harrypatrick442/hvps/Structure/Assembly/PCBImages/LM2596.png

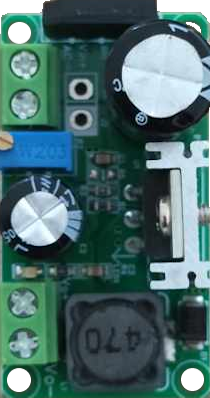
Structure/Assembly/PCBImages/LM2596.png
