harrypatrick442/hvps/Code/C++/VoltageFeedbackModuleBase/FiberOpticLayout.txt

 Voltage feedback module
 +  -   blank
TR2 RC  TR1
 ^^ ^^ ^^
