harrypatrick442/hvps/DataSheets/terminals/PCB-3 M4.png

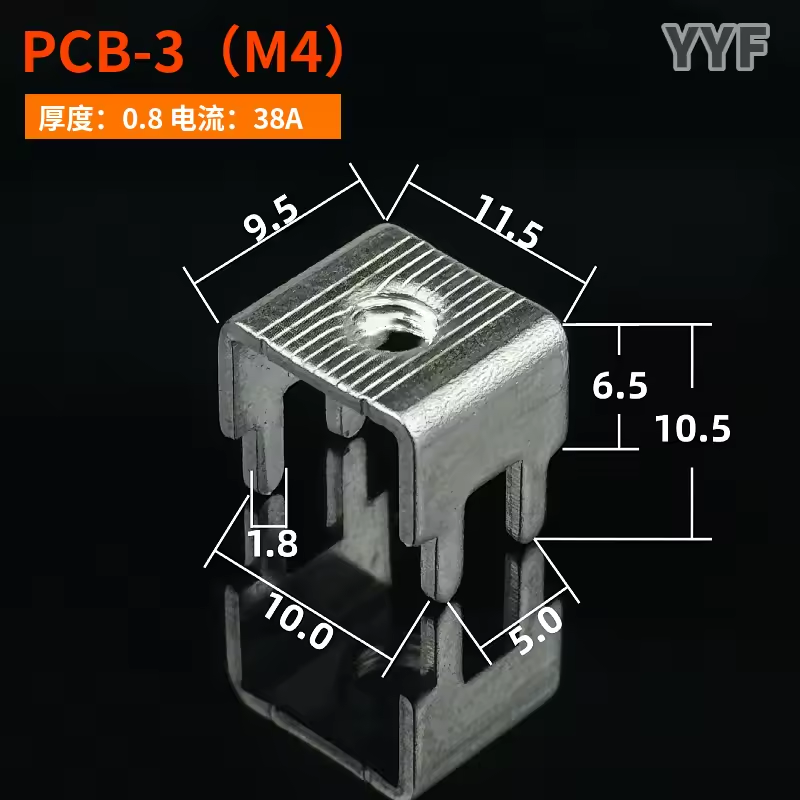
DataSheets/terminals/PCB-3 M4.png
