harrypatrick442/hvps/Documents/ESP-FPGA Interface/Block Logic Diagram.png

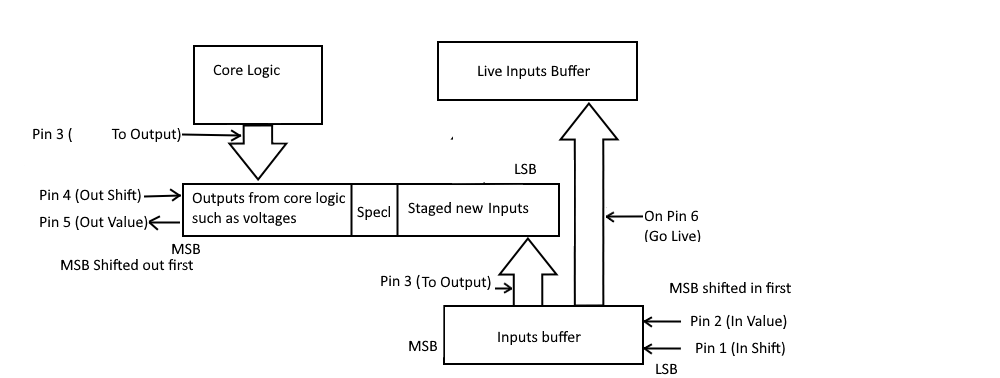
Documents/ESP-FPGA Interface/Block Logic Diagram.png
