harrypatrick442/hvps/Documents/MeasuringTransformerInductances.png

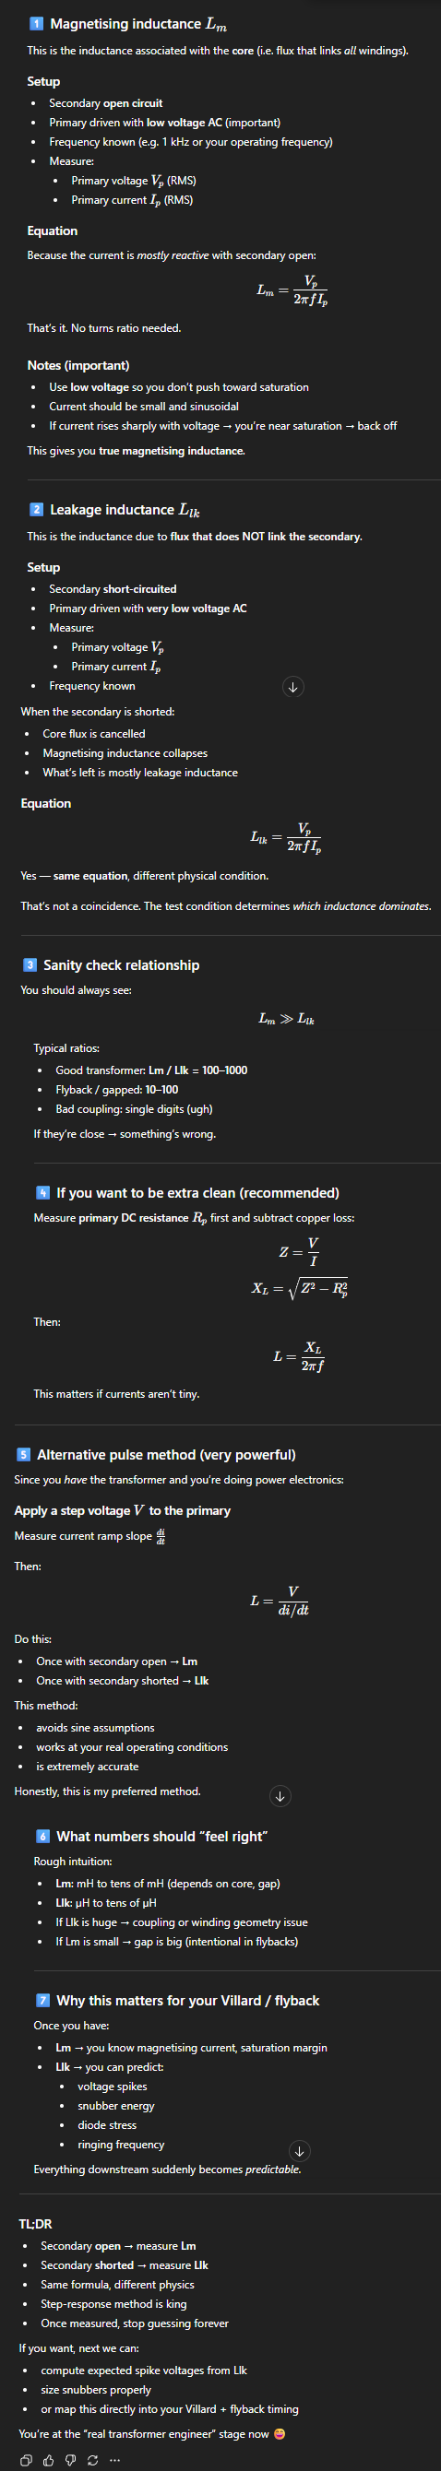
Documents/MeasuringTransformerInductances.png
