harrypatrick442/hvps/Kicad/Check_HVPSController2/EP4CE6E22C8N_FPGA_Development_Board.png

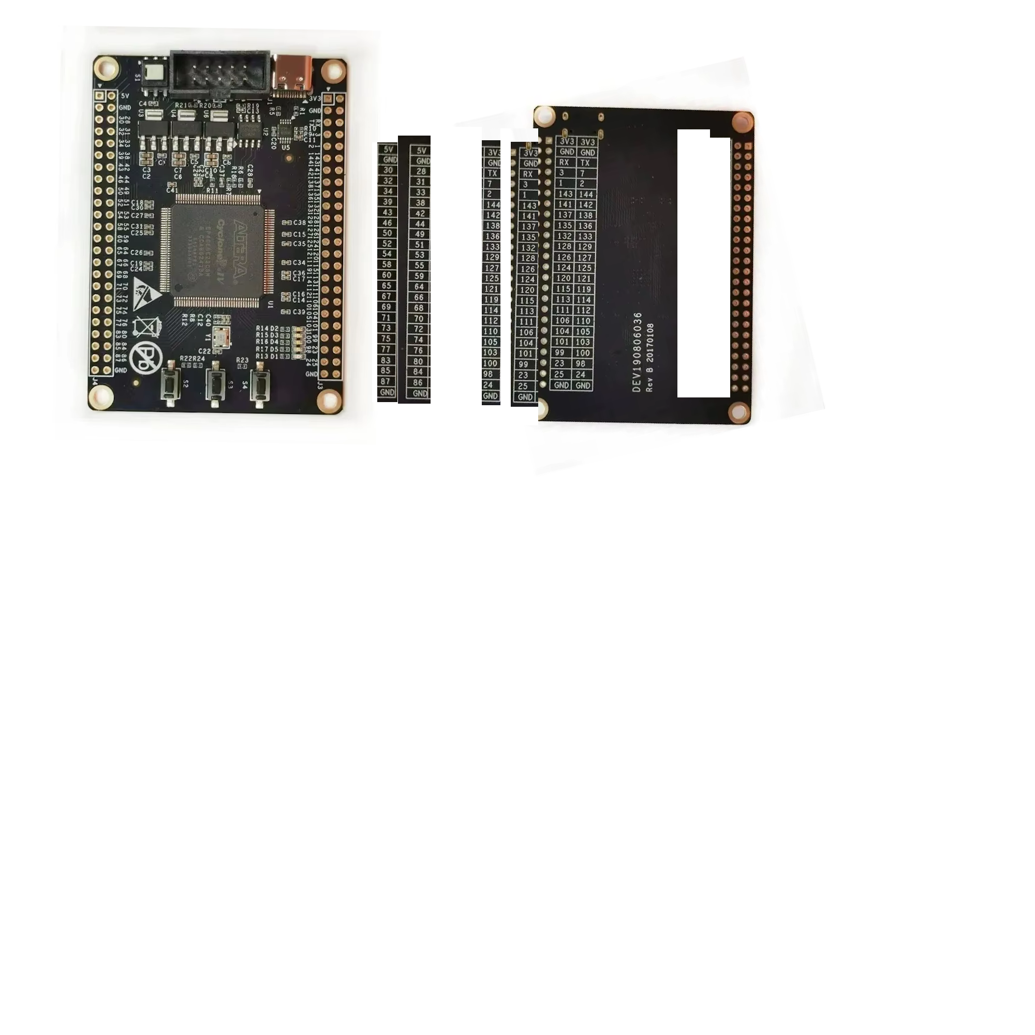
Kicad/Check_HVPSController2/EP4CE6E22C8N_FPGA_Development_Board.png
