harrypatrick442/hvps/Structure/Base/Bolts_Top.png

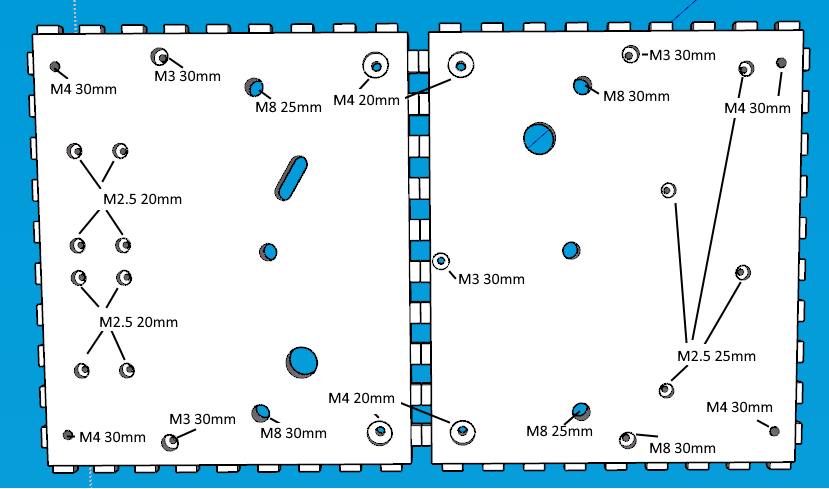
Structure/Base/Bolts_Top.png
