harrypatrick442/hvps/Validation/CheckingControllerSchematic.png

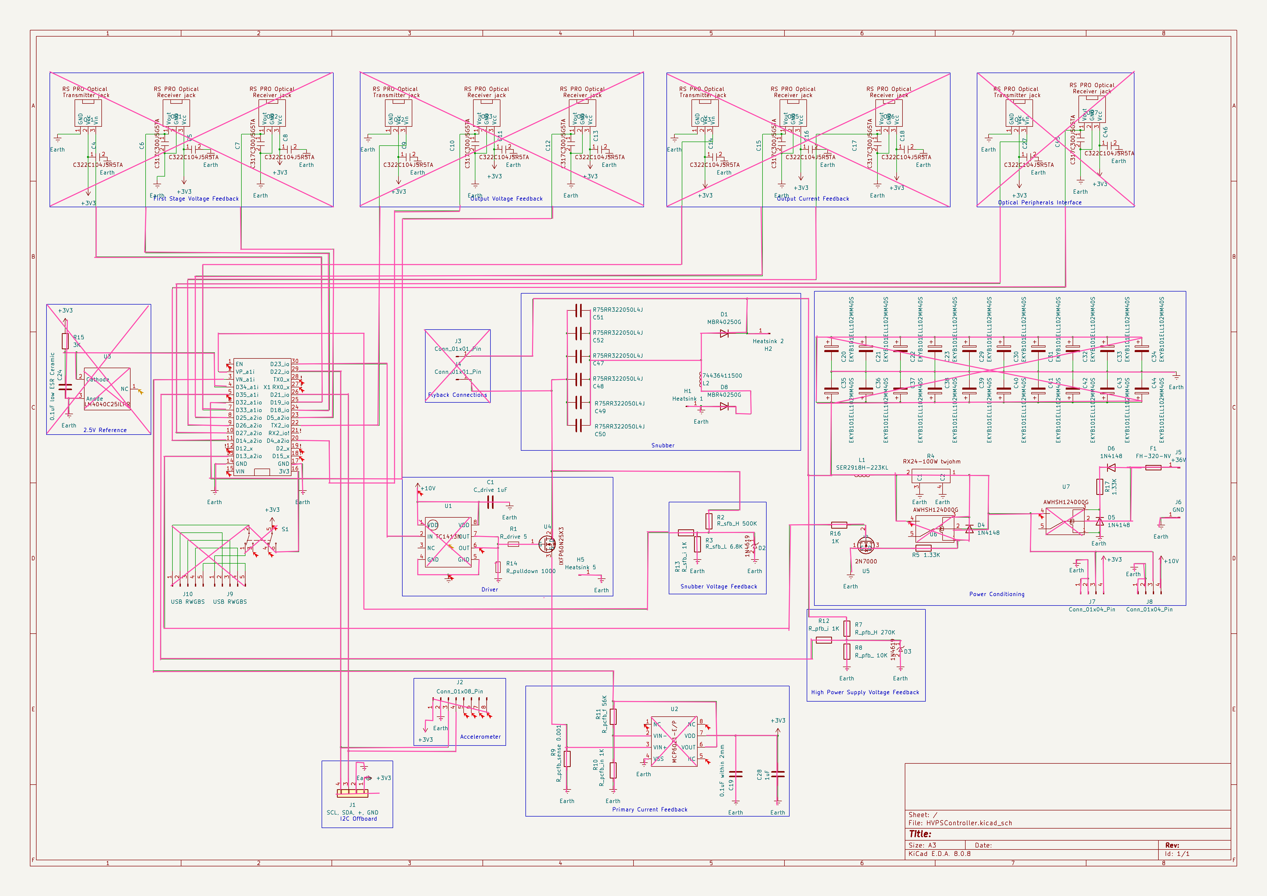
Validation/CheckingControllerSchematic.png
