harrypatrick442/hvps/Spreadsheets/Parts_HVPSController.xlsx

Sheet: Sheet1
Subsystem |  | Item # | Url | Include (green) | Part Name | Part Number | Category | Quantity Needed | Quantity in Stock | Description | Value/Rating | Tolerance | Voltage Rating | Power Rating | Package/Size | Supplier | Supplier Part Number | Unit Price | Total Cost | Lead Time | Notes
 |  | Unique identifier or reference number for each part (useful for cross-referencing in schematics). | Link(s) to related pages | ‎ | Name of the component (e.g., Resistor, Capacitor, MOSFET). | Manufacturer’s part number or internal part number. | ‎ | Number of each component required for the project. | Number of components you currently have. | Brief description of the part, including key specs (e.g., 10kΩ, 1/4W for a resistor). | Specific value, rating, or specification (e.g., 10µF, 16V for a capacitor). | Tolerance for components like resistors and capacitors (e.g., ±5%). | Voltage rating (especially important for capacitors, diodes, etc.). | Power rating for resistors, MOSFETs, etc. | Package type (e.g., SMD-0805, TO-220) or physical size. | Supplier name (e.g., Digi-Key, Mouser, LCSC). | Supplier-specific part number, if different from manufacturer part number. | Price per unit of the part. | Total cost calculated as Quantity Needed × Unit Price. | Expected time for delivery from supplier. | Any additional notes, like alternatives or special instructions.
Flyback Core |  |  |  | ‎
 |  |  |  | ‎
 |  |  | https://www.aliexpress.com/item/1005006725342220.html?scm_id=1007.13339.291025.0&scm-url=1007.13339.291025.0 | ‎ | UY42 UY120/89/42 | ‎
 |  |  | https://www.aliexpress.com/item/1005005826311044.html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 | ‎ | 1pair/lot UY42 Ultra Large Power Transformer Core Al 8448nH/N2 UY120/89/42 UU Isolator Ferrite Core Ferrite Chokes MnZn PC40 | ‎
 |  |  | https://www.aliexpress.com/item/33011851355.html?scm_id=1007.40050.354490.0&scm-url=1007.40050.354490.0 | ‎ | uy30
 |  |  | https://www.aliexpress.com/item/1005002286755922.html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 | ‎
 |  |  | https://www.aliexpress.com/item/1005002286755922.html | ‎ | 1pair UY 30 MnZn PC40 U Shape Ferrite Filter 130x95mm For Transformer Core | ‎ |  | 1 | 0 | 1pair UY 30 MnZn PC40 U Shape Ferrite Filter 130x95mm For Transformer Core | ‎ |  |  | PC40 |  | Aliexpress, New Accessory Store, Store no 912028214 | ‎ | £33.79 | £33.79
 |  |  |  | ‎ |  |  |  |  |  |  |  |  |  |  |  |  |  |  | £0.00
Capacitor Distcharge Resistor |  |  | https://www.mouser.co.uk/ProductDetail/Vishay-BC-Components/VR68000002496FAC00?qs=wEmTtUuRSe6YkQzEm4CWKw%3D%3D | ‎ |  | VR68000002496FAC00 |  |  |  |  |  |  |  |  |  |  |  |  | £0.00
 |  |  | ‎ | ‎ |  |  |  |  |  |  |  |  |  |  |  |  |  |  | £0.00
 |  |  | ‎ | ‎ |  |  |  |  |  |  |  |  |  |  |  |  |  |  | £0.00
 |  |  | ‎ | ‎ |  |  |  |  |  |  |  |  |  |  |  |  |  |  | £0.00
 |  |  | ‎ | ‎ |  |  |  |  |  |  |  |  |  |  |  |  |  |  | £0.00
 |  |  | ‎ | ‎ |  |  |  |  |  |  |  |  |  |  |  |  |  |  | £0.00
Gate Driver |  |  | ‎ | ‎ | n channel gate driver | TC1413N |  | 1 | 0 | single n channel non inverting gate driver able to drive up to 1800pf gate. | ‎ |  |  |  |  |  |  |  | £0.00
 |  |  | ‎ | ‎ | CSD19534KCS 100V N-Channel NexFET | CSD19534KCS |  | 1 | 0 | 100V N-Channel NexFET | ‎ |  |  |  |  |  |  |  | £0.00
 |  |  | ‎ | ‎ | 1uf X7R capacitor | C320C104K5R5TA (https://www.mouser.co.uk/ProductDetail/KEMET/C320C104K5R5TA) |  | 1 | 0 | Capacitor that goes across Vdd and Gnd for TC1413N | 1uf | 10% |  |  |  |  |  |  | £0.00
 |  |  | ‎ | ‎ |  |  |  |  |  |  |  |  |  |  |  |  |  |  | £0.00
 |  |  | ‎ | ‎ |  |  |  |  |  |  |  |  |  |  |  |  |  |  | £0.00
 |  |  | ‎ | ‎ |  |  |  |  |  |  |  |  |  |  |  |  |  |  | £0.00
Voltage Feedback |  |  | ‎ | ‎ | 1N4619 BK PBFREE | 1N4619 BK PBFREE |  |  |  | zener diode protection, 3v 0.8uA leakage | ‎ | 5% | 3 | 0.25w | DO-35-2 |  |  |  | £0.00
 |  |  | ‎ | ‎ |  | SM108033006FE (https://www.mouser.co.uk/ProductDetail/Ohmite/SM108033006FE) |  |  |  | Thick Film Resistors - Through Hole 300M ohms 1% | 300M | 1% | 20kv | 2.5w |  |  |  |  | £0.00
 |  |  | ‎ | ‎ |  | MFR-25FBF52-30K1 (https://www.mouser.co.uk/ProductDetail/YAGEO/MFR-25FBF52-45K3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) |  |  |  | Metal Film Resistors - Through Hole 30.1K OHM 1/4W 1% | 30.1k | s | 250v | 0.25w |  |  |  |  | £0.00
 |  |  | ‎ | ‎ |  | C322C102F5G5TA |  |  |  | Multilayer Ceramic Capacitors MLCC - Leaded 50V 1000pF C0G 1% LS=5.08mm | 1000pf | 1% | 50v |  |  |  |  |  | £0.00
 |  |  | ‎ | ‎ |  | RS Stock No.:270-7764 |  |  |  | RS PRO 16Mbps Fibre Optic Transmitter 640 → 670nm, Square Fiber Optic Connector, 13.6 x 11.5 x 9.5mm SUPPORTS toslink | ‎ |  |  |  |  |  |  |  | £0.00
 |  |  | ‎ | ‎ |  | RS Stock No.:270-7763 |  |  |  | RS PRO 16Mbps 650nm Fibre Optic Receiver, Square, Fiber Optic Connector SUPPORTS toslink | ‎ |  |  |  |  |  |  |  | £0.00
 |  |  | ‎ | ‎ |  | C317C300J5G5TA (https://www.mouser.co.uk/ProductDetail/KEMET/C317C300J5G5TA?qs=b8KOIaRqXtdsFXPxXiN2GA%3D%3D) |  |  |  | Multilayer Ceramic Capacitors MLCC - Leaded 50V 30pF C0G 5% LS=5.08mm | 30pf | 5% | 50v |  |  |  |  |  | £0.00
 |  |  | ‎ | ‎ |  | C322C104J5R5TA |  |  |  | Multilayer Ceramic Capacitors MLCC - Leaded 50V 0.1uF X7R 5% LS=5.08mm | 0.1uf | 5% | 50v |  |  |  |  |  | £0.00
 |  |  | ‎ | ‎ |  | WP154A4SEJ3VBDZGW/CA | ‎ |  |  | Common anode RGB led WP154A4SEJ3VBDZGW/CA | ‎ |  |  |  |  |  |  |  | £0.00
Villard Capacitor |  |  | https://www.alibaba.com/product-detail/CT81-20KV-1000PF-N4700-D19-5xT8_60495534513.html | ‎ | Villard Capacitors | AXCT81D20KV102K |  | 190 | 0 | CT81 20KV 1000PF N4700 D19.5xT8.5xF13.0mm, d0.8 | 1uF | 10% | 20000 | N4700 |  | AnXon |  | $0.68 | £180.00 | 7-8 weeks | $48 Fedex postage from china
 |  |  | ‎ | ‎ |  |  |  |  |  |  |  |  |  |  |  |  |  |  | £0.00
 |  |  | ‎ | ‎ |  |  |  |  |  |  |  |  |  |  |  |  |  |  | £0.00
 |  |  | ‎ | ‎ |  |  |  |  |  |  | ‎ |  |  |  |  |  |  |  | £0.00
 |  |  | ‎ | ‎ |  | HVC-20KV-DL21-F12.5-102K | ‎ |  |  | https://www.hv-caps.com/HV-Ceramic-Disc-Capacitor/hv-ceramic-disc-capacitor163.html | ‎ |  |  |  |  |  |  |  | £0.00
 |  |  | ‎ | ‎ |  | HVC-20KV -DL28- F16 -202K | ‎ |  |  |  |  |  |  |  |  |  |  |  | £0.00
 |  |  | https://www.mouser.co.uk/ProductDetail/Vishay-Roederstein/HVCC203Y6P102MEAX | ‎ |  | HVCC203Y6P102MEAX (https://www.mouser.co.uk/ProductDetail/Vishay-Roederstein/HVCC203Y6P102MEAX) |  |  |  |  |  |  |  |  |  |  |  |  | £0.00
 |  |  |  | ‎ |  |  |  |  |  |  |  |  |  |  |  |  |  |  | £0.00
villard Diode |  |  | https://www.aliexpress.com/item/1005008408941647.html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 | ‎ |  | 35kv 0.1 amp diodes |  |  |  |  |  |  |  |  |  |  |  |  | £0.00
 |  |  | https://www.aliexpress.com/item/32991104517.html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 | ‎ | high voltage capacitor | 2CL2FR (https://www.alldatasheet.com/datasheet-pdf/pdf/876496/GETEDZ/2CL2FP_16.html) |  |  |  | 35kv 0.1 amp diodes | 35kv 100ma |  |  |  |  |  |  |  | £0.00
 |  |  | https://www.aliexpress.com/item/1005007066972173.html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 | ‎ |  | 2CL2FP |  |  |  | 35kv 0.1 amp diodes | ‎ |  |  |  |  |  |  |  | £0.00
 |  |  | https://www.aliexpress.com/item/1005007066972173.html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 | ‎ |  | 2CL2FR (https://www.alldatasheet.com/datasheet-pdf/pdf/876496/GETEDZ/2CL2FP_16.html) |  |  |  | 35kv 0.1 amp diodes | ‎ |  |  |  |  |  |  |  | £0.00
 |  |  |  | ‎ |  | CL08-35 |  |  |  | 35kv 200ma high voltage diodes for main villard cascading | ‎ |  |  |  |  |  |  |  | £0.00
 |  |  | https://www.alibaba.com/product-detail/hot-sell-MT100F35-100mA-35KV-100ns_1601105852602.html | ‎ |  | MT100F35 |  |  |  | hot sell MT100F35 100mA 35KV 100ns Fast Recovery High Voltage Diode replace 2CL2FR for wholesales |  |  |  |  |  |  |  |  | £0.00
 |  |  | https://www.aliexpress.com/item/1005006421523336.html |  |  | JB289 |  | 12 | 0 | JB289 HIGH high voltage diodes | 35kv 100mA |  | 35kv |  |  |  |  | 2.1 | £25.20
 |  |  |  | ‎ |  |  |  |  |  |  |  |  |  |  |  |  |  |  | £0.00
Villard Distcharge Resistor |  |  | https://www.mouser.co.uk/ProductDetail/Vishay-BC-Components/VR68000002496FAC00?qs=wEmTtUuRSe6YkQzEm4CWKw%3D%3D | ‎ |  | VR68000002496FAC00 |  |  |  |  |  |  |  |  |  |  |  |  | £0.00
 |  |  | https://www.mouser.co.uk/ProductDetail/Murata-Power-Solutions/MHR0422SA108F70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 | ‎ |  | MHR0422SA_1G |  |  |  |  |  |  |  |  |  |  |  |  | £0.00
 |  |  | https://www.aliexpress.com/item/1005005496744751.html | ‎ |  | 2G HVR82ML2204J * 2 in series | ‎ |  |  | 30kv |  |  |  |  |  |  |  |  | £0.00
 |  |  | https://www.aliexpress.com/item/1005005756305538.html | ‎ |  | 2G HVR82MY2505 * 2 in series | ‎ |  |  |  |  |  |  |  |  |  |  |  | £0.00
 |  |  | https://www.aliexpress.com/item/1005007223750578.html | ‎ |  | multiple HVR82MZ1005. cheap high values low power small | ‎ |  |  |  |  |  |  |  |  |  |  |  | £0.00
 |  |  | https://www.aliexpress.com/item/1005003588041883.html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 | ‎ |  | multiple HVR82MZ1005. cheap high values low power small | ‎ |  |  |  |  |  |  |  |  |  |  |  | £0.00
 |  |  |  | ‎ |  |  |  |  |  |  |  |  |  |  |  |  |  |  | £0.00
Nice quick reply alibaba |  |  | https://anxon.en.alibaba.com/catalog/865474/index.html | ‎ |  |  |  |  |  |  |  |  |  |  |  |  |  |  | £0.00
 |  |  |  | ‎ |  |  |  |  |  |  |  |  |  |  |  |  |  |  | £0.00
Mineral oil pumping and floating power generation |  |  | https://www.aliexpress.com/item/1005007549969044.html?mp=1 | ‎ |  |  |  |  |  |  |  |  |  |  |  |  |  |  | £0.00
 |  |  | https://www.aliexpress.com/item/1005006754784195.html?mp=1 | ‎ |  |  |  |  |  |  |  |  |  |  |  |  |  |  | £0.00
 |  |  | https://www.aliexpress.com/item/1005007511957479.html?mp=1 | ‎ |  |  |  |  |  |  |  |  |  |  |  |  |  |  | £0.00
 |  |  |  | ‎ |  |  |  |  |  |  |  |  |  |  |  |  |  |  | £0.00
Mainboard: First Stage Voltage Feedback | / |  | ‎ http://uk.rs-online.com/web/p/fibre-optic-transmitters/2707764?gb=s | ‎ | RS PRO 16Mbps Fibre Optic Transmitter 640 → 670nm, Square Fiber Optic Connector, 13.6 x 11.5 x 9.5mm | RS Stock No.:270-7764 |  | 1 |  | RS PRO 16Mbps Fibre Optic Transmitter 640 → 670nm, Square Fiber Optic Connector, 13.6 x 11.5 x 9.5mm SUPPORTS toslink | ‎ |  |  |  |  | RS | 270-7764 |  | £0.00
 | / |  | ‎ https://uk.rs-online.com/web/p/fibre-optic-receivers/2707763?gb=s | ‎ | RS PRO 16Mbps 650nm Fibre Optic Receiver, Square, Fiber Optic Connector | RS Stock No.:270-7763 |  | 2 |  | RS PRO 16Mbps 650nm Fibre Optic Receiver, Square, Fiber Optic Connector SUPPORTS toslink | ‎ |  |  |  |  | RS | 270-7763 |  | £0.00
 | / |  | https://www.mouser.co.uk/ProductDetail/KEMET/C322C104J5R5TA?qs=fv%2FgaNrLmF3mCSYhUi18YA%3D%3D | ‎ | Multilayer Ceramic Capacitors MLCC - Leaded 50V 0.1uF X7R 5% LS=5.08mm | C322C104J5R5TA |  | 3 |  | Multilayer Ceramic Capacitors MLCC - Leaded 50V 0.1uF X7R 5% LS=5.08mm | ‎ | 5% | 50V |  |  | Mouser | 80-C322C104J5R | £0.28 | £0.84
 | / |  | https://www.mouser.co.uk/ProductDetail/?qs=b8KOIaRqXtdsFXPxXiN2GA%3D%3D | ‎ | Multilayer Ceramic Capacitors MLCC - Leaded 50V 30pF C0G 5% LS=5.08mm | C317C300J5G5TA |  | 2 |  | Multilayer Ceramic Capacitors MLCC - Leaded 50V 30pF C0G 5% LS=5.08mm | ‎ | 5% | 50V |  |  | Mouser | 80-C317C300J5G | £0.48 | £0.96
Mainboard: Output Voltage Feedback | / |  | ‎ http://uk.rs-online.com/web/p/fibre-optic-transmitters/2707764?gb=s | ‎ | RS PRO 16Mbps Fibre Optic Transmitter 640 → 670nm, Square Fiber Optic Connector, 13.6 x 11.5 x 9.5mm | RS Stock No.:270-7764 |  | 1 |  | RS PRO 16Mbps Fibre Optic Transmitter 640 → 670nm, Square Fiber Optic Connector, 13.6 x 11.5 x 9.5mm SUPPORTS toslink | ‎ |  |  |  |  | RS | 270-7764 |  | £0.00
 | / |  | ‎ https://uk.rs-online.com/web/p/fibre-optic-receivers/2707763?gb=s | ‎ | RS PRO 16Mbps 650nm Fibre Optic Receiver, Square, Fiber Optic Connector | RS Stock No.:270-7763 |  | 2 |  | RS PRO 16Mbps 650nm Fibre Optic Receiver, Square, Fiber Optic Connector SUPPORTS toslink | ‎ |  |  |  |  | RS | 270-7763 |  | £0.00
 | / |  | https://www.mouser.co.uk/ProductDetail/KEMET/C322C104J5R5TA?qs=fv%2FgaNrLmF3mCSYhUi18YA%3D%3D | ‎ | Multilayer Ceramic Capacitors MLCC - Leaded 50V 0.1uF X7R 5% LS=5.08mm | C322C104J5R5TA |  | 3 |  | Multilayer Ceramic Capacitors MLCC - Leaded 50V 0.1uF X7R 5% LS=5.08mm | ‎ | 5% | 50V |  |  | Mouser | 80-C322C104J5R | £0.28 | £0.84
 | / |  | https://www.mouser.co.uk/ProductDetail/?qs=b8KOIaRqXtdsFXPxXiN2GA%3D%3D | ‎ | Multilayer Ceramic Capacitors MLCC - Leaded 50V 30pF C0G 5% LS=5.08mm | C317C300J5G5TA |  | 2 |  | Multilayer Ceramic Capacitors MLCC - Leaded 50V 30pF C0G 5% LS=5.08mm | ‎ | 5% | 50V |  |  | Mouser | 80-C317C300J5G | £0.48 | £0.96
Mainboard: Output Current Feedback | / |  | ‎ http://uk.rs-online.com/web/p/fibre-optic-transmitters/2707764?gb=s | ‎ | RS PRO 16Mbps Fibre Optic Transmitter 640 → 670nm, Square Fiber Optic Connector, 13.6 x 11.5 x 9.5mm | RS Stock No.:270-7764 |  | 1 |  | RS PRO 16Mbps Fibre Optic Transmitter 640 → 670nm, Square Fiber Optic Connector, 13.6 x 11.5 x 9.5mm SUPPORTS toslink | ‎ |  |  |  |  | RS | 270-7764 |  | £0.00
 | / |  | ‎ https://uk.rs-online.com/web/p/fibre-optic-receivers/2707763?gb=s | ‎ | RS PRO 16Mbps 650nm Fibre Optic Receiver, Square, Fiber Optic Connector | RS Stock No.:270-7763 |  | 2 |  | RS PRO 16Mbps 650nm Fibre Optic Receiver, Square, Fiber Optic Connector SUPPORTS toslink | ‎ |  |  |  |  | RS | 270-7763 |  | £0.00
 | / |  | https://www.mouser.co.uk/ProductDetail/KEMET/C322C104J5R5TA?qs=fv%2FgaNrLmF3mCSYhUi18YA%3D%3D | ‎ | Multilayer Ceramic Capacitors MLCC - Leaded 50V 0.1uF X7R 5% LS=5.08mm | C322C104J5R5TA |  | 3 |  | Multilayer Ceramic Capacitors MLCC - Leaded 50V 0.1uF X7R 5% LS=5.08mm | ‎ | 5% | 50V |  |  | Mouser | 80-C322C104J5R | £0.28 | £0.84
 | / |  | https://www.mouser.co.uk/ProductDetail/?qs=b8KOIaRqXtdsFXPxXiN2GA%3D%3D | ‎ | Multilayer Ceramic Capacitors MLCC - Leaded 50V 30pF C0G 5% LS=5.08mm | C317C300J5G5TA |  | 2 |  | Multilayer Ceramic Capacitors MLCC - Leaded 50V 30pF C0G 5% LS=5.08mm | ‎ | 5% | 50V |  |  | Mouser | 80-C317C300J5G | £0.48 | £0.96
Mainboard: Other Peripherals | / |  | ‎ http://uk.rs-online.com/web/p/fibre-optic-transmitters/2707764?gb=s | ‎ | RS PRO 16Mbps Fibre Optic Transmitter 640 → 670nm, Square Fiber Optic Connector, 13.6 x 11.5 x 9.5mm | RS Stock No.:270-7764 |  | 1 |  | RS PRO 16Mbps Fibre Optic Transmitter 640 → 670nm, Square Fiber Optic Connector, 13.6 x 11.5 x 9.5mm SUPPORTS toslink | ‎ |  |  |  |  | RS | 270-7764 |  | £0.00
 | / |  | ‎ https://uk.rs-online.com/web/p/fibre-optic-receivers/2707763?gb=s | ‎ | RS PRO 16Mbps 650nm Fibre Optic Receiver, Square, Fiber Optic Connector | RS Stock No.:270-7763 |  | 1 |  | RS PRO 16Mbps 650nm Fibre Optic Receiver, Square, Fiber Optic Connector SUPPORTS toslink | ‎ |  |  |  |  | RS | 270-7763 |  | £0.00
 | / |  | https://www.mouser.co.uk/ProductDetail/KEMET/C322C104J5R5TA?qs=fv%2FgaNrLmF3mCSYhUi18YA%3D%3D | ‎ | Multilayer Ceramic Capacitors MLCC - Leaded 50V 0.1uF X7R 5% LS=5.08mm | C322C104J5R5TA |  | 2 |  | Multilayer Ceramic Capacitors MLCC - Leaded 50V 0.1uF X7R 5% LS=5.08mm | ‎ | 5% | 50V |  |  | Mouser | 80-C322C104J5R | £0.28 | £0.56
 | / |  | https://www.mouser.co.uk/ProductDetail/?qs=b8KOIaRqXtdsFXPxXiN2GA%3D%3D | ‎ | Multilayer Ceramic Capacitors MLCC - Leaded 50V 30pF C0G 5% LS=5.08mm | C317C300J5G5TA |  | 1 |  | Multilayer Ceramic Capacitors MLCC - Leaded 50V 30pF C0G 5% LS=5.08mm | ‎ | 5% | 50V |  |  | Mouser | 80-C317C300J5G | £0.48 | £0.48
Mainboard: 2.5V Reference | / |  | https://www.mouser.co.uk/ProductDetail/Texas-Instruments/LM4040C25ILPR?qs=xRTSnXjzBs7toHVdgzq9EQ%3D%3D | ‎ | LM4040C25ILPR | LM4040C25ILPR |  | 1 |  | Voltage References 2.5-V Precision Micr opower Shunt A 595-LM4040C25ILP |  | 0.50% | 2.5V | 15 mA | TO-92-3 | Mouser | 595-LM4040C25ILPR | £0.72 | £0.72
 | / |  | https://www.mouser.co.uk/ProductDetail/Vishay-Dale/CCF073K00JKE36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 | ‎ | Metal Film Resistors 1/4watt 3Kohms 5% Rated to 1/2watt | CCF073K00JKE36 |  | 1 |  | Metal Film Resistors - Through Hole 1/4watt 3Kohms 5% Rated to 1/2watt | 3K | 5% | 250 V |  | 6.22 mm | Mouser | 71-CCF073K00JKE36 | £0.24 | £0.24
 | / |  | https://www.mouser.co.uk/ProductDetail/Murata-Electronics/RDE5C1H104J2K1H03B | ‎ | Multilayer Ceramic Capacitors MLCC - Leaded .1UF 50V 5% 5.0MM | RDE5C1H104J2K1H03B |  | 1 |  | Multilayer Ceramic Capacitors MLCC - Leaded .1UF 50V 5% 5.0MM | 0.1 uF | 5% | 50V |  | 5mm | Mouser | 81-RDE5C1H104J2K1H3B | 0.583 | £0.58
Mainboard: Flyback Connections | / |  |  | ‎ | TE Connectivity, Nylon Screw Terminal, Vertical, 37.8A | 5055556-9 |  | 2 |  | TE Connectivity, Nylon Screw Terminal, Vertical, 37.8A |  |  |  |  |  | RS | 217-5473 | £3.17 | £6.34
 |  |  |  |  |  |  |  |  |  |  |  |  |  |  |  |  |  |  | £0.00
Mainboard: Driver | / |  | https://www.mouser.co.uk/ProductDetail/Microchip-Technology/TC1413NEPA?qs=Ux5rHyN1IXTGNXxjM5rIZA%3D%3D | ‎ | Gate Drivers 3A Sngl N-Inv | TC1413NEPA |  | 1 |  |  |  |  |  |  |  | Mouser | 579-TC1413NEPA | £1.78 | £1.78
 | / |  | https://www.mouser.co.uk/ProductDetail/IXYS/IXFP60N25X3?qs=5aG0NVq1C4yTnBULxG9HTw%3D%3D | ‎ | MOSFETs 250V/60A Ultra Junct ion X3-Class MOSFET | IXFP60N25X3 |  | 1 |  | MOSFETs 250V/60A Ultra Junct ion X3-Class MOSFET |  |  |  |  |  | Mouser | 747-IXFP60N25X3 | £6.86 | £6.86
 | / |  | https://www.mouser.co.uk/ProductDetail/Wakefield-Thermal/647-25ABPE?qs=1%252ByrAFyf4wEF4vm1j%252Byz0w%3D%3D | ‎ | Heat Sinks Heat Sink+Solder Pins, TO220, Flat-Back, Vertical, 12.8 Degree C/W, 2.67mm Hole | 647-25ABEP |  | 1 | 0 | Heat Sinks High Performance Heat Sink for Vertical Board Mounting for TO-220, 63.5mm Height |  |  |  |  |  | Mouser | 532-581202B25G | £2.18 | £2.18
 | / |  | https://www.mouser.co.uk/ProductDetail/Vishay-Dale/CMF555R0000FKEA?qs=2tJBorIoXcvFADtNDQGMUg%3D%3D | ‎ | Metal Film Resistors - Through Hole 1/2W 5ohms 1% | CMF555R0000FKEA |  | 1 |  | Metal Film Resistors - Through Hole 1/2W 5ohms 1% |  | 1% | 350V | 0.5w | 6.5 mm | Mouser | 71-CMF555R0000FKEA | £0.08 | £0.08
 | / |  | https://www.mouser.co.uk/ProductDetail/YAGEO/MFR-25FRE52-1K |  | Metal Film Resistors - Through Hole 1Kohm 1% 1/4W Metal Film Resistor | MFR-25FRE52-1K |  | 1 |  | Metal Film Resistors 1Kohm 1% 1/4W Metal Film Resistor |  | 1% | 250V | 0.25w |  | Mouser | 603-MFR-25FRE52-1K | £0.08 | £0.08
 | / |  | https://www.mouser.co.uk/ProductDetail/KEMET/C320C105K5R5TA?qs=J6JJqAtew8ZzkfLDcKcSxg%3D%3D | ‎ | Multilayer Ceramic Capacitors MLCC - Leaded 50V 1uF X7R 10% LS=2.54mm | C320C105K5R5TA (https://www.mouser.co.uk/ProductDetail/KEMET/C320C104K5R5TA) |  | 1 | 0 | Capacitor that goes across Vdd and Gnd for TC1413N. Multilayer Ceramic Capacitors MLCC - Leaded 50V 1uF X7R 10% LS=2.54mm | 1uf | 10% | 50V |  | 2.54mm | Mouser | 80-C320C105K5R5TA | £0.81 | £0.81
Mainboard: Accelerometer |  |  |  | ‎ |  |  |  |  |  |  |  |  |  |  |  |  |  |  | £0.00
 |  |  |  | ‎ |  |  |  |  |  |  |  |  |  |  |  |  |  |  | £0.00
Mainboard: I2C Offboard |  |  |  | ‎ |  |  |  |  |  |  |  |  |  |  |  |  |  |  | £0.00
 |  |  |  | ‎ |  |  |  |  |  |  |  |  |  |  |  |  |  |  | £0.00
Mainboard: Snubber | / |  | https://www.mouser.co.uk/ProductDetail/KEMET/R75RR322050L4J?qs=zW32dvEIR3sfSLCevL5nlQ%3D%3D | ‎ | Film Capacitors 1.25k V 0.22 uF 105C 5% 2 Pin LS=27.5 mm AEC-Q200 | R75RR322050L4J |  | 6 | 0 | Film Capacitors 1.25k V 0.22 uF 105C 5% 2 Pin LS=27.5 mm AEC-Q200 |  |  |  |  |  | Mouser | 80-R75RR322050L4J | £2.54 | £15.24
 | / |  | https://www.mouser.co.uk/ProductDetail/onsemi/MBR40250G?qs=3JMERSakebrJFUp9PnjkTw%3D%3D | ‎ | Schottky Diodes & Rectifiers 40A 250 | MBR40250G |  | 2 | 0 | Schottky Diodes & Rectifiers 40A 250 |  |  | 250v |  |  | Mouser | 863-MBR40250G | £1.65 | £3.30
 | / |  | https://www.mouser.co.uk/ProductDetail/Wakefield-Thermal/647-25ABPE?qs=1%252ByrAFyf4wEF4vm1j%252Byz0w%3D%3D | ‎ | Heat Sinks Heat Sink+Solder Pins, TO220, Flat-Back, Vertical, 12.8 Degree C/W, 2.67mm Hole | 647-25ABEP |  | 2 | 0 | Heat Sinks High Performance Heat Sink for Vertical Board Mounting for TO-220, 63.5mm Height |  |  |  |  |  | Mouser | 532-581202B25G | £2.18 | £4.36
 | / |  | https://www.we-online.com/components/products/datasheet/74436411500.pdf | ‎ | Power Inductors - SMD WE-HCF HighCurr 2815 15uH 36A 1.31mOhms AEC-Q200 | 74436411500 |  | 1 | 0 | Power Inductors - SMD WE-HCF HighCurr 2815 15uH 36A 1.31mOhms AEC-Q200 |  |  |  |  |  | Mouser | 710-74436411500 | £6.14 | £6.14
Mainboard: Snubber Voltage Feedback | / |  | https://www.mouser.co.uk/ProductDetail/YAGEO/MFR-25FRE52-1K | ‎ | Metal Film Resistors - Through Hole 1Kohm 1% 1/4W Metal Film Resistor | MFR-25FRE52-1K |  | 1 | 0 | Metal Film Resistors 1Kohm 1% 1/4W Metal Film Resistor |  | 1% | 250V | 0.25w |  | Mouser | 603-MFR-25FRE52-1K | £0.08 | £0.08
 | / |  | https://www.mouser.co.uk/ProductDetail/YAGEO/MFR-25FTF52-500K?qs=xZ%2FP%252Ba9zWqaL8mzaXpXK8g%3D%3D | ‎ | Metal Film Resistors - Through Hole 6.8K OHM 1/4W 1% | MFR-25FBF52-6K8 |  | 1 | 0 | Metal Film Resistors 6.8K OHM 1/4W 1% |  | 1% | 250V | 0.25w |  | Mouser | 603-MFR-25FBF52-6K8 | £0.08 | £0.08
 | / |  | https://www.mouser.co.uk/ProductDetail/YAGEO/MFR-25FTF52-500K | ‎ | Metal Film Resistors | MFR-25FTF52-500K |  | 1 | 0 | Metal Film Resistors |  | 1% | 250V | 0.25w |  | Mouser | 603-MFR-25FTF52-500K | £0.08 | £0.08
 | / |  | https://www.mouser.co.uk/ProductDetail/Central-Semiconductor/1N4619-BK-PBFREE?qs=l7cgNqFNU1hI2SGXFdSwFQ%3D%3D | ‎ | Zener Diodes .25W 5% Lw Noise/Lvl | 1N4619 BK PBFREE |  | 1 | 0 | Zener Diodes .25W 5% Lw Noise/Lvl |  | 5% | 3V | 0.25w |  | Mouser | 610-1N4619 | £0.59 | £0.59
Mainboard: Power Input Conditioning | / |  |  | ‎ | TE Connectivity, Nylon Screw Terminal, Vertical, 37.8A | 5055556-9 |  | 2 |  | TE Connectivity, Nylon Screw Terminal, Vertical, 37.8A |  |  |  |  |  | RS | 217-5473 | £3.17 | £6.34
 | / |  | https://www.aliexpress.com/item/1005003907866404.html?mp=1 | ‎ | 2PCS RX24-100W high-power winding resistor | 2PCS RX24-100W-33 |  | 1 | 0 | 2PCS RX24-100W |  |  |  |  |  |  |  |  | £0.00
 | / |  | https://www.mouser.co.uk/ProductDetail/Coilcraft/SER2918H-223KL | ‎ | Power Inductors - SMD 22uH Shld 20% 28A 2.86mOhms AECQ2 | SER2918H-223KL |  | 1 | 0 | Power Inductors - SMD 22uH Shld 20% 28A 2.86mOhms AECQ2 |  | 10% |  |  |  | Mouser | 994-SER2918H-223KL | £4.67 | £4.67
 | / |  | https://www.mouser.co.uk/ProductDetail/onsemi-Fairchild/2N7000?qs=FOlmdCx%252BAA2o%2FKZOTk%2F3hg%3D%3D | ‎ | MOSFETs N-Channel Enhancement Mode Field Effect Transistor 60V, 200mA, 5 ohm | 2N7000 |  | 1 | 0 | MOSFETs N-Channel Enhancement Mode Field Effect Transistor 60V, 200mA, 5 ohm |  |  |  |  |  | Mouser | 512-2N7000 | £0.38 | £0.38
 | / |  | https://www.mouser.co.uk/ProductDetail/onsemi-Fairchild/1N4148?qs=i4Fj9T%2FoRm8RMUhj5DeFQg%3D%3D |  | 1N4148 | 1N4148 |  | 3 | 0 | Small Signal Switching Diodes 100V Io/200mA BULK |  |  |  |  |  | Mouser | 512-1N4148 | £0.08 | £0.24
 | / |  | https://www.mouser.co.uk/ProductDetail/YAGEO/MFR-25FRE52-1K | ‎ | Metal Film Resistors - Through Hole 1Kohm 1% 1/4W Metal Film Resistor | MFR-25FRE52-1K |  | 1 | 0 | Metal Film Resistors 1Kohm 1% 1/4W Metal Film Resistor |  | 1% | 250V | 0.25w |  | Mouser | 603-MFR-25FRE52-1K | £0.08 | £0.08
 |  |  | https://www.mouser.co.uk/ProductDetail/YAGEO/MFR-25FTE52-10K?qs=oAGoVhmvjhyxqkhLibETTw%3D%3D | ‎ | Metal Film Resistors - Through Hole 10 kOhms 250 mW 1% 5 0 PPM / C | MFR-25FTE52-10K |  | 1 | 0 | Metal Film Resistors - Through Hole 10 kOhms 250 mW 1% 5 0 PPM / C |  | 1% | 250V | 0.25w |  | Mouser | 603-MFR-25FTE52-10K | £0.08 | £0.08
 | / |  | https://www.mouser.co.uk/ProductDetail/Amphenol-Anytek/AWHSH112DM00G?qs=rSMjJ%252B1ewcRkINR7MLX27w%3D%3D | ‎ | General Purpose Relays Commercial RelayRated Carrying Current :15AType of Sealing : Sealed and Waterproof TypeNumber of pole : one poleCoil Voltage : 24VCoil Type : Standard DC CoilContact Form : Form C | AWHSH124D00G |  | 2 | 0 | General Purpose Relays Commercial RelayRated Carrying Current :15AType of Sealing : Sealed and Waterproof TypeNumber of pole : one poleCoil Voltage : 24VCoil Type : Standard DC CoilContact Form : Form C |  |  |  |  |  | Mouser | 523-AWHSH124D00G | £0.80 | £1.60
 |  |  | https://www.mouser.co.uk/ProductDetail/YAGEO/MFR50SFTE52-1K33?qs=UFD7vfw3J8osCEB2xFvg0Q%3D%3D | ‎ | Metal Film Resistors - Through Hole 1.33K Ohm 1/2 Wat 1% Miniature Version | MFR50SFTE52-1K33 |  | 2 | 0 | Metal Film Resistors - Through Hole 1.33K Ohm 1/2 Wat 1% Miniature Version |  |  |  |  |  | Mouser | 603-MFR50SFTE52-1K33 | £0.09 | £0.18
 |  |  | https://www.mouser.co.uk/ProductDetail/Littelfuse/0232008.MX125P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 | ‎ | 576-0232008.MX125P | 0232008.MX125P |  | 1 | 0 | Fuse 576-0232008.MX125P |  |  |  |  |  | Mouser | 0232008.MX125P | £0.87 | £0.87
 | / |  | https://www.mouser.co.uk/ProductDetail/Chemi-Con/EKYB101ELL102MM40S?qs=IYueExuAvkrcoErCvSFiXg%3D%3D | ‎ | Aluminium Electrolytic Capacitors - Radial Leaded 100VDC 1000uF Tol 20% 18x40mm | EKYB101ELL102MM40S |  | 20 | 0 | Aluminium Electrolytic Capacitors - Radial Leaded 100VDC 1000uF Tol 20% 18x40mm |  | 20% | 100V |  |  | Mouser | 661-EKYB101E102MM40S | £1.49 | £29.80
 | / |  | https://www.mouser.co.uk/ProductDetail/Essentra/FH-320-NV?qs=PzGy0jfpSMtU9GQhdYJRvA%3D%3D | ‎ | Fuse Holder Accessories Fuse Holder,Black,5X20 Fuse | FH-320-NV |  | 1 | 0 | Fuse Holder Accessories Fuse Holder,Black,5X20 Fuse |  |  |  |  |  | Mouser | 144-FH-320-NV | £0.72 | £0.72
Mainboard:Power Conditioning Voltage Feedback | / |  | https://www.mouser.co.uk/ProductDetail/YAGEO/MFR-25FRE52-1K | ‎ | Metal Film Resistors - Through Hole 1Kohm 1% 1/4W Metal Film Resistor | MFR-25FRE52-1K |  | 1 | 0 | Metal Film Resistors 1Kohm 1% 1/4W Metal Film Resistor |  | 1% | 250V | 0.25w |  | Mouser | 603-MFR-25FRE52-1K | £0.08 | £0.08
 |  |  | https://www.mouser.co.uk/ProductDetail/YAGEO/MFR-25FTE52-10K?qs=oAGoVhmvjhyxqkhLibETTw%3D%3D | ‎ | Metal Film Resistors - Through Hole 10 kOhms 250 mW 1% 5 0 PPM / C | MFR-25FTE52-10K |  | 1 | 0 | Metal Film Resistors - Through Hole 10 kOhms 250 mW 1% 5 0 PPM / C |  | 1% | 250V | 0.25w |  | Mouser | 603-MFR-25FTE52-10K | £0.08 | £0.08
 | / |  | https://www.mouser.co.uk/ProductDetail/Central-Semiconductor/1N4619-BK-PBFREE?qs=l7cgNqFNU1hI2SGXFdSwFQ%3D%3D | ‎ | Zener Diodes .25W 5% Lw Noise/Lvl | 1N4619 BK PBFREE |  | 1 | 0 | Zener Diodes .25W 5% Lw Noise/Lvl |  | 5% | 3V | 0.25w |  | Mouser | 610-1N4619 | £0.59 | £0.59
 | / |  | https://www.mouser.co.uk/ProductDetail/YAGEO/MFR-25FTF52-270K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 | ‎ | MFR-25FTF52-270K | MFR-25FTF52-270K |  | 1 | 0 | Metal Film Resistors |  | 1% | 250V | 0.25w |  | Mouser | 603-MFR-25FTF52-270K | £0.08 | £0.08
Mainboard: Primary Current Feedback | / |  | https://www.mouser.co.uk/ProductDetail/Microchip-Technology/MCP6021-E-P?qs=W2ndVjZwIIKVhoK39SuWRw%3D%3D | ‎ | Operational Amplifiers - Op Amps Single 2.3V PNP in | MCP6021-E/P |  | 1 |  | Operational Amplifiers - Op Amps Single 2.3V PNP in |  |  |  |  |  | Mouser | 579-MCP616-I/P | £0.88 | £0.88
 | / |  | https://www.mouser.co.uk/ProductDetail/Ohmite/PCS2512FR0010ET | ‎ | Current Sense Resistors - SMD 2W 0.001 OHMS 1% | PCS2512FR0010ET |  | 1 |  | Current Sense Resistors - SMD 2W 0.001 OHMS 1% |  |  |  |  |  | Mouser | 588-PCS2512FR0010ET | £0.47 | £0.47
 | / |  | https://www.mouser.co.uk/ProductDetail/YAGEO/MFP-25BRD52-56K | ‎ | Metal Film Resistors - Through Hole 0.1% 25ppm 56K ohm | MFP-25BRD52-56K |  | 1 |  | Metal Film Resistors - Through Hole 0.1% 25ppm 56K ohm |  |  |  |  |  | Mouser | 603-MFP-25BRD52-56K | £0.43 | £0.43
 |  |  | https://www.mouser.co.uk/ProductDetail/YAGEO/MFP-25BRD52-1K | ‎ | Metal Film Resistors - Through Hole 0.1% 25ppm 1K ohm | MFP-25BRD52-1K |  | 1 |  | Metal Film Resistors - Through Hole 0.1% 25ppm 1K ohm |  |  |  |  |  | Mouser | 603-MFP-25BRD52-1K | £0.44 | £0.44
 | / |  | https://www.mouser.co.uk/ProductDetail/KEMET/C322C104J5R5TA?qs=fv%2FgaNrLmF3mCSYhUi18YA%3D%3D | ‎ | Multilayer Ceramic Capacitors MLCC - Leaded 50V 0.1uF X7R 5% LS=5.08mm | C322C104J5R5TA |  | 1 |  | Multilayer Ceramic Capacitors MLCC - Leaded 50V 0.1uF X7R 5% LS=5.08mm | ‎ | 5% | 50V |  |  | Mouser | 80-C322C104J5R | £0.28 | £0.28
 | / |  | https://www.mouser.co.uk/ProductDetail/KEMET/C320C105K5R5TA?qs=J6JJqAtew8ZzkfLDcKcSxg%3D%3D | ‎ | Multilayer Ceramic Capacitors MLCC - Leaded 50V 1uF X7R 10% LS=2.54mm | C320C105K5R5TA (https://www.mouser.co.uk/ProductDetail/KEMET/C320C104K5R5TA) |  | 1 | 0 | Capacitor that goes across Vdd and Gnd for TC1413N. Multilayer Ceramic Capacitors MLCC - Leaded 50V 1uF X7R 10% LS=2.54mm | 1uf | 10% | 50V |  | 2.54mm | Mouser | 80-C320C105K5R5TA | £0.81 | £0.81
 |  |  | https://www.mouser.co.uk/ProductDetail/Molex/50-57-9404?qs=u6Gr9%2FNt%252B%2F%2FUw3Dr7T8xxg%3D%3D |  | Headers & Wire Housings HSG 4P SINGLE ROW POSITIVE LATCH | 50-57-9404 |  | 1 | 0 | Headers & Wire Housings HSG 4P SINGLE ROW POSITIVE LATCH |  |  |  |  |  | Mouser | 538-50-57-9404 | £0.22 | £0.22
 |  |  | https://www.mouser.co.uk/ProductDetail/Molex/70553-0003?qs=tYx%252BZc2nXqor1JDF8v%2FPGQ%3D%3D |  | 70553-0003Headers & Wire Housings R/A HDR 4P low profile single | 70553-0003 |  | 1 | 0 | Headers & Wire Housings R/A HDR 4P low profile single |  |  |  |  |  | Mouser | 538-70553-0003 | £0.96 | £0.96
 |  |  | https://www.mouser.co.uk/ProductDetail/JST-Commercial/XNIRP-04V-A-S?qs=QpmGXVUTftGz3941P8FIaA%3D%3D |  | XNIRP-04V-A-S | XNIRP-04V-A-S |  | 1 | 0 |  |  |  |  |  |  |  |  |  | £0.00
 | / |  | https://www.mouser.co.uk/ProductDetail/Nichicon/UHD1H101MPD1TD?qs=NE4YvPat5pF7RlHwNM%252BO%2Fg%3D%3D | ‎ |  | UHD1H101MPD1TD |  | 1 | 0 | Aluminium Electrolytic Capacitors - Radial Leaded 100uF 50V 20% Aluminum Capacitor |  |  |  |  |  | Mouser | 647-UHD1H101MPD1TD |  | £0.00
 |  |  | https://www.mouser.co.uk/ProductDetail/Nichicon/UPW1E102MHD?qs=ecywdsU7aIK%252BPPnr1yjSKg%3D%3D | ‎ |  | UPW1E102MHD |  | 1 | 0 | Aluminium Electrolytic Capacitors - Radial Leaded 25volts 1000uF AEC-Q200 |  |  |  |  |  | Mouser | 647-UPW1E102MHD |  | £0.00
Bolts for structure |  |  |  |  |  |  |  |  |  |  |  |  |  |  |  |  |  |  | £0.00
Nylon rods, Allthread.co.uk |  |  | https://www.allthread.co.uk/custom-plastic-parts/ |  |  |  |  |  |  | two 107cm long lengths of M8 nylon rod |  |  |  |  |  |  |  |  | £0.00
 |  |  | https://www.plastock.co.uk/products/acrylic-extruded-clear-tube?variant=42776698618080 |  |  |  |  |  |  | £77 quid 180mm 5mm 500mm acrylic tube. |  |  |  |  |  |  |  |  | £0.00
High voltage wire |  |  | https://www.aliexpress.com/item/1005009422281234.html |  |  |  |  | 1 |  | 150kv 13awg silicon cable 1m |  |  |  |  |  |  |  |  | £0.00
Fiber optic cables |  |  | https://www.aliexpress.com/item/1005005833058990.html |  |  |  |  | 6 | 0 | TOSLINK Fiber optic cables |  |  |  |  |  |  |  | 0.59 | £3.54
 |  |  |  |  |  |  |  |  |  |  |  |  |  |  |  |  |  |  | £0.00
 |  |  |  |  |  |  |  |  |  |  |  |  |  |  |  |  |  |  | £0.00
 |  |  |  |  |  |  |  |  |  |  |  |  |  |  |  |  |  |  | £0.00
 |  |  |  |  |  |  |  |  |  |  |  |  |  |  |  |  |  |  | £0.00
 |  |  |  |  |  |  |  |  |  |  |  |  |  |  |  |  |  |  | £0.00
 |  |  |  |  |  |  |  |  |  |  |  |  |  |  |  |  |  |  | £0.00
 |  |  |  |  |  |  |  |  |  |  |  |  |  |  |  |  |  |  | £0.00
 |  |  |  |  |  |  |  |  |  |  |  |  |  |  |  |  |  |  | £0.00
 |  |  |  |  |  |  |  |  |  |  |  |  |  |  |  |  |  |  | £0.00
 |  |  |  |  |  |  |  |  |  |  |  |  |  |  |  |  |  |  | £0.00
 |  |  |  |  |  |  |  |  |  |  |  |  |  |  |  |  |  |  | £0.00
 |  |  |  |  |  |  |  |  |  |  |  |  |  |  |  |  |  |  | £0.00
 |  |  |  |  |  |  |  |  |  |  |  |  |  |  |  |  |  |  | £0.00
 |  |  |  |  |  |  |  |  |  |  |  |  |  |  |  |  |  |  | £0.00
 |  |  |  |  |  |  |  |  |  |  |  |  |  |  |  |  |  |  | £0.00
 |  |  |  |  |  |  |  |  |  |  |  |  |  |  |  |  |  |  | £0.00
 |  |  |  |  |  |  |  |  |  |  |  |  |  |  |  |  |  |  | £0.00
 |  |  |  |  |  |  |  |  |  |  |  |  |  |  |  |  |  |  | £0.00
 |  |  |  |  |  |  |  |  |  |  |  |  |  |  |  |  |  |  | £0.00
 |  |  |  |  |  |  |  |  |  |  |  |  |  |  |  |  |  |  | £0.00
 |  |  |  |  |  |  |  |  |  |  |  |  |  |  |  |  |  |  | £0.00
 |  |  |  |  |  |  |  |  |  |  |  |  |  |  |  |  |  |  | £0.00
 |  |  |  |  |  |  |  |  |  |  |  |  |  |  |  |  |  |  | £0.00
 |  |  |  |  |  |  |  |  |  |  |  |  |  |  |  |  |  |  | £0.00
 |  |  |  |  |  |  |  |  |  |  |  |  |  |  |  |  |  |  | £0.00
 |  |  |  |  |  |  |  |  |  |  |  |  |  |  |  |  |  |  | £0.00

Sheet: High Voltage Feedback
Subsystem | Item # | Url | ‎ | Part Name | Part Number | Category | Quantity Needed | Quantity in Stock | Description | Value/Rating | Tolerance | Voltage Rating | Power Rating | Package/Size | Supplier | Supplier Part Number | Unit Price | Total Cost | Lead Time | Notes
Voltage Feedback Board |  | ‎ | ‎ | Zener diode over voltage clamp | 1N4619 BK PBFREE |  | 1 | 0 | zener diode protection, 3v 0.8uA leakage | ‎ | 5% | 3 | 0.25w | DO-35-2
 |  | https://www.mouser.co.uk/ProductDetail/Murata-Power-Solutions/MHR0844SA107F70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 | ‎ | Potential divider upper leg resistors | MHR0844SA107F70 (https://www.mouser.co.uk/ProductDetail/Ohmite/SM108033006FE) |  | 2 | 0 | Thick Film Resistors - Through Hole 300M ohms 1% | 100M | 1% | 15.8 kV | 2.5w |  |  |  | £2.56 | £5.12
 |  | https://www.mouser.co.uk/ProductDetail/YAGEO/MFR-25FRF52-27K?qs=sGAEpiMZZMsPqMdJzcrNwiweiCzxKzWLhyrsT9Ty9ww%3D | ‎ | Potential divider lower leg resistor | MFR-25FRF52-27K (https://www.mouser.co.uk/ProductDetail/YAGEO/MFR-25FBF52-45K3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) |  | 1 | 0 | Metal Film Resistors - Through Hole 27K OHM 1/4W 1% | 27000 | 1% | 300v | 0.25w
 |  | ‎ | ‎ | Potential divider lower bias capacitor | C322C271K2G5TA |  | 1 | 0 | Multilayer Ceramic Capacitors MLCC - Leaded 50V 1000pF C0G 1% LS=5.08mm | 270pf | 1% | 250v
 |  | ‎ | ‎ | Fiber optic transmitter | RS Stock No.:270-7764 |  | 2 | 0 | RS PRO 16Mbps Fibre Optic Transmitter 640 → 670nm, Square Fiber Optic Connector, 13.6 x 11.5 x 9.5mm SUPPORTS toslink | ‎
 |  | ‎ | ‎ | Fiber optic receiver | RS Stock No.:270-7763 |  | 1 | 0 | RS PRO 16Mbps 650nm Fibre Optic Receiver, Square, Fiber Optic Connector SUPPORTS toslink | ‎
 |  | ‎ | ‎ |  | C317C300J5G5TA (https://www.mouser.co.uk/ProductDetail/KEMET/C317C300J5G5TA?qs=b8KOIaRqXtdsFXPxXiN2GA%3D%3D) |  | 1 | 0 | Multilayer Ceramic Capacitors MLCC - Leaded 50V 30pF C0G 5% LS=5.08mm | 30pf | 5% | 50v
 |  | ‎ | ‎ |  | C322C104J5R5TA |  | 3 | 0 | Multilayer Ceramic Capacitors MLCC - Leaded 50V 0.1uF X7R 5% LS=5.08mm | 0.1uf | 5% | 50v
 |  | ‎ | ‎ | Male Male pin strip |  | ‎ |  |  |  | ‎
Villard First Stage Potential Divider |  | https://www.mouser.co.uk/ProductDetail/Murata-Power-Solutions/MHR0844SA107F70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 | ‎ | Potential divider upper leg resistors | MHR0844SA107F70 (https://www.mouser.co.uk/ProductDetail/Ohmite/SM108033006FE) |  | 2 | 0 | Thick Film Resistors - Through Hole 300M ohms 1% | 100M | 1% | 15.8 kV | 2.5w |  |  |  | £2.56 | £5.12
 |  | https://www.aliexpress.com/item/1005004279932436.html | ‎ | Potential divider upper leg resistors | HVR82MY5010 100MF 1% (https://www.mouser.co.uk/ProductDetail/Ohmite/SM108033006FE) |  | 2 | 0 | HVR82MY5010 100MF (1% version) | 100M | 1% | 15.8 kV | 3.5w |  | Alibaba: twjohm |  | £0.80 | £1.59
200KV Villard Output Voltage |  | https://www.aliexpress.com/item/1005004279932436.html | ‎ | Potential divider upper leg resistors | HVR82MY5010 1GF 1% |  | 14 | 0 | HVR82MY5010 1GF (1% version) | 1G ohm | 1% | 25kv | 3.5w |  | Alibaba: twjohm |  | £0.97 | £13.58
 |  | https://www.aliexpress.com/item/1005003776755496.html?mp=1 |  | Potential divider calculations |  |  |  |  | M2 standoffs kit
 |  |  |  |  | Instance name | First Stage Voltage Feedback | Output Voltage Feedback 200Kv
 |  |  |  |  | Safety factor | 1.2 | 1.2
 |  |  |  |  | Maximum zener diode leakage current | 8e-07 | 8e-07
 |  |  |  |  | Maximum high voltage | 20000 | 250000
 |  |  |  |  | Minimum high voltage | 1000 | 50000
 |  |  |  |  | Maximum tap voltage | 2.7 | 2.7
 |  |  |  |  | Minimum tap voltage
 |  |  |  |  | Resistor ratio required | 7407.407407 | 92592.59259
 |  |  |  |  | X zener leakage current minimum | 6 | 4
 |  |  |  |  | minimum current | 4.8e-06 | 3.2e-06
 |  |  |  |  | maximum RL to give high enough current | 4166666667 | 78125000000 |  | Composite resistor combination finding
 |  |  |  |  | Power dissipated at maximum series resistance and high voltage | 0.096 | 0.8 |  | max voltage | 200000 | 250000
 |  |  |  | High volatge resistor Rh | Rh minimum individual voltage rating required | 12000 | 23076.92308 |  | safety factor | 1.2 | 1.2
 |  |  |  |  | Rh individual high voltage resistor resistance | 100000000 | 1000000000 |  | resistance required | 13500000000 | 300000
 |  |  |  |  | Rh actual voltage rating | 15800 | 25000 |  | voltage rating of part | 25000 | 25000
 |  |  |  |  | Rh tolerance percent | 1 | 1 |  | n parts required minimum | 10 | 12
 |  |  |  |  | Rh power rating | 2.5 | 3.5 |  | actual number of parts using | 13 | 15
 |  |  |  |  | Resistor part | MHR0844SA107F70 | HVR82MY5010 1GF |  | desired resistance | 1038461538 | 20000
 |  |  |  | Low voltage resistor Rl | Suggested value | 27000 | 10800 |  | desired resistance M | 1038.461538 | 0.02
 |  |  |  |  | RL voltage rating | 300 |  |  | voltage across each part | 15384.61538 | 16666.66667
 |  |  |  |  | RL resistance | 27000 | 18200 |  | power dissipation in each part | 0.2279202279 | 13888.88889
 |  |  |  |  | RL tolerance percent | 1 | 1 |  | Url | https://www.aliexpress.com/item/1005004279932436.html | https://www.aliexpress.com/item/1005004279932436.html
 |  |  |  |  | Rl power rating | 0.25 | 0.25 |  | part number | HVR82MY5010 1GF (1% version) | HVR82MY5010 1GF (1% version)
 |  |  |  |  | Resistor part | RN60C1351FB14 |  |  | voltage rating | 25000 | 25000
 |  |  |  |  | Rh individual maximum resistance | 101000000 | 1010000000 |  | tolerance | 1% | 1%
 |  |  |  |  | Rh individual minimum resistance | 99000000 | 990000000 |  | resistance | 1G | 200K
 |  |  |  |  | Nrh high voltage resistors | 2 | 13 |  | unit price | £0.97
 |  |  |  |  | RH tolerance proportion | 0.01 | 0.01 |  | total price | £12.61
 |  |  |  |  | RH total series resistance | 200000000 | 13000000000 |  | part power rating | 3.5W | 3.5W
 |  |  |  |  | RH maximum resistance | 202000000 | 13130000000 |  | unit length mm | 50 | 51
 |  |  |  |  | RH minimum resistance | 198000000 | 12870000000
 |  |  |  |  | Nrh x Vrh Total voltage rating | 31600 | 325000
 |  |  |  |  | Nrh x Vrh / safety factor Operating voltage rating | 26333.33333 | 270833.3333
 |  |  |  |  | RH tolerance proportion | 0.01 | 0.01
 |  |  |  |  | RL maximum resistance | 27270 | 18382
 |  |  |  |  | RL minimum resistance | 26730 | 18018
 |  |  |  |  | High voltage resistors Acceptible voltage rating | TRUE | TRUE
 |  |  |  |  | Low voltage resistor acceptible voltage rating
 |  |  |  |  | Minimum current (at lowest high voltage and highest end of tolerance) | 4.949833438e-06 | 3.808067836e-06
 |  |  |  |  | Maximum current (at highest high voltage and lowest end of tolerance) | 0.0001009964665 | 1.942499223e-05
 |  |  |  |  | Acceptibly large current at minimum high voltage | TRUE | TRUE
 |  |  |  |  | Alter resistance by proportion |  | 1.190022848
 |  |  |  |  | P_Rh Maximum power disipation individual high voltage resistor | 1.030228911 | 0.3811036264
 |  |  |  |  | P_RL Maximum power disipation low voltage resistor | 0.0002781618058 | 6.936086e-06
 |  |  |  |  | Rh maximum power rating including safety factor | 2.083333333 | 2.916666667
 |  |  |  |  | Rl maximum power rating including safety factor | 0.2083333333 | 0.2083333333
 |  |  |  |  | Rh power rating acceptible | TRUE | TRUE
 |  |  |  |  | Rl power rating acceptible | TRUE | TRUE
 |  |  |  |  | Total power loss | 2.060735983 | 4.954354079
 |  |  |  |  | Minimum cycles to rise through full voltage range (limited by energy transformer can transfer to capacitor per cycle) | 6 | 6
 |  |  |  |  | Minimum cycles to fall through full voltage range (limited by output current limiting resistance) | 1 | 1
 |  |  |  |  | Minimum transition time | 1 | 1
 |  |  |  |  | Frequency of driver | 16000 | 16001
 |  |  |  |  | Period | 6.25e-05 | 6.249609399e-05
 |  |  |  |  | t_99% desired | 3.125e-05 | 3.1248047e-05
 |  |  |  |  | Effective time constant τ desired | 6.786102063e-06 | 6.785677958e-06
 |  |  |  |  | Suggested lower leg capacitance | 2.513371134e-10 | 3.728394483e-10
 |  |  |  | Lower leg capacitor | Actual lower leg capacitance | 2.7e-10 | 3.7e-10
 |  |  |  |  | t_99% actual | 3.356596346e-05 | 3.101002702e-05
 |  |  |  |  | Effective time constant τ for actual capacitor | 7.289025724e-06 | 6.733990666e-06
 |  |  |  |  | V_∞min | 0.1349817775 | 0.069999902
 |  |  |  |  | V_∞max | 2.7 | 2.7
 |  |  |  |  | Time taken for V_L to go from maximum to within 0.99 of minimum value | 5.503033115e-05 | 5.543027519e-05
 |  |  |  |  | N Cycles taken for V_L to go from maximum to within 0.99 of minimum value | 0.8804852984 | 0.8869398332
 |  |  |  |  | Time taken for V_L to go from lowest to within 0.99 of maximum value | 3.319337759e-05 | 3.083428532e-05
 |  |  |  |  | N cycles taken for V_L to go from lowest to within 0.99 of maximum value | 0.5310940415 | 0.4933793995
 |  |  |  |  | Suitable | TRUE | TRUE
 |  |  | ‎
 |  |  | ‎
 |  |  | ‎
 |  |  | ‎
 |  |  | ‎
 |  |  | ‎
 |  |  | ‎
 |  |  | ‎
 |  |  | ‎
 |  |  | ‎
 |  |  | ‎
 |  |  | ‎
 |  |  | ‎
 |  |  | ‎
 |  |  | ‎
 |  |  | ‎
 |  |  | ‎
 |  |  | ‎
 |  |  | ‎
 |  |  | ‎
 |  |  | ‎
 |  |  | ‎
 |  |  | ‎

Sheet: VillardVessel
https://www.trentplastics.co.uk/product/clear-acrylic-tube/ |  |  |  | 200x5x190x1000 | 64
 |  |  |  | 3mm | £39.00
 | OD tube
 | ID tube | 0.17 | m
 | Height tube | 1 | m
 | Mineral oil volume | 0.02269800692 | m^3
 | Density | 870 | kg/m^3
 | Mass of mineral oil | 19.74726602
 | Safety factor | 4
 | Bending moment about base when on side filled supported at base | 96.86033984
 | Minimum distance between vessel base bolts | 0.154
 | Maximum bending moment on bolt | 628.9632457
 | Required bolt tensile strength | 2515.852983 | N
 | σ_nylon | 70000000
 | Required bolt tensile stress area | 3.59407569e-05 | m^2
 | Required Tensile stress diameter | 0.006764701985

Sheet: Sheet2
https://www.aliexpress.com/item/1005006754784195.html?mp=1
https://www.aliexpress.com/item/1005007549969044.html?mp=1
