harrypatrick442/hvps/Kicad/VillardCascadingVoltageMultiplierSubcircuit/experimenting with component layout.png

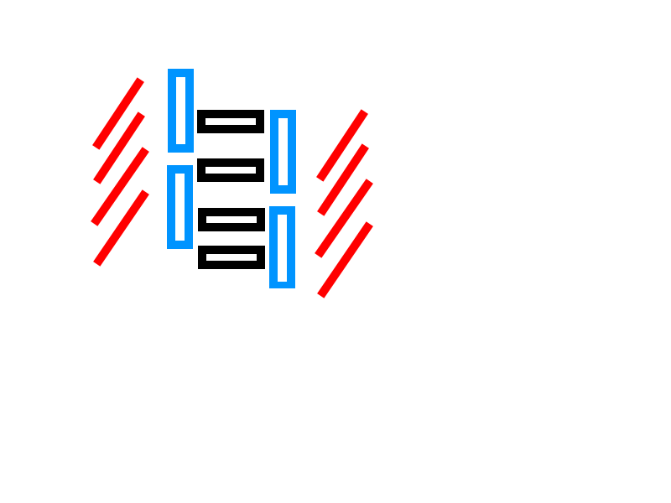
Kicad/VillardCascadingVoltageMultiplierSubcircuit/experimenting with component layout.png
