harrypatrick442/hvps/Structure/Assembly/SpacerForAssembling.stl

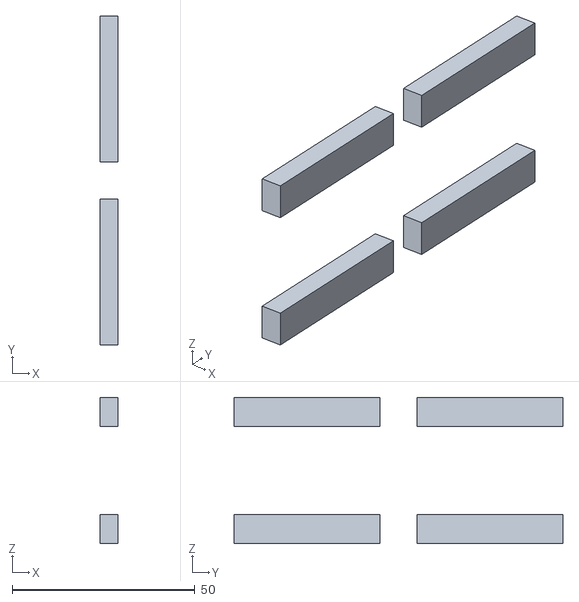
[picture p13: CAD file, 2025-09-17]
Structure/Assembly/SpacerForAssembling.stl
5.00 x 90.0 x 40.0
