harrypatrick442/hvps/Structure/Experimentation/FullEnclosedBoxJointMale.stl

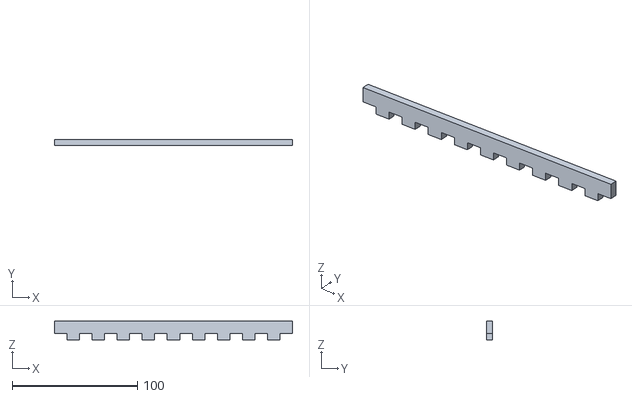
[picture p14: CAD file, 2025-09-17]
Structure/Experimentation/FullEnclosedBoxJointMale.stl
190.0 x 5.00 x 15.0
