harrypatrick442/hvps/Structure/Experimentation/FullEnclosedBoxJointFemale.stl

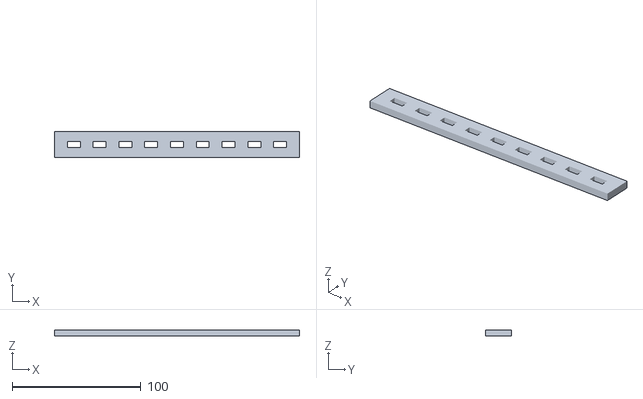
[picture p15: CAD file, 2025-09-17]
Structure/Experimentation/FullEnclosedBoxJointFemale.stl
190.0 x 20.0 x 5.00
