harrypatrick442/hvps/Code/C#/FlybackModelling/Meshes/UsingUY30MnZnPC40130x95mm.obj

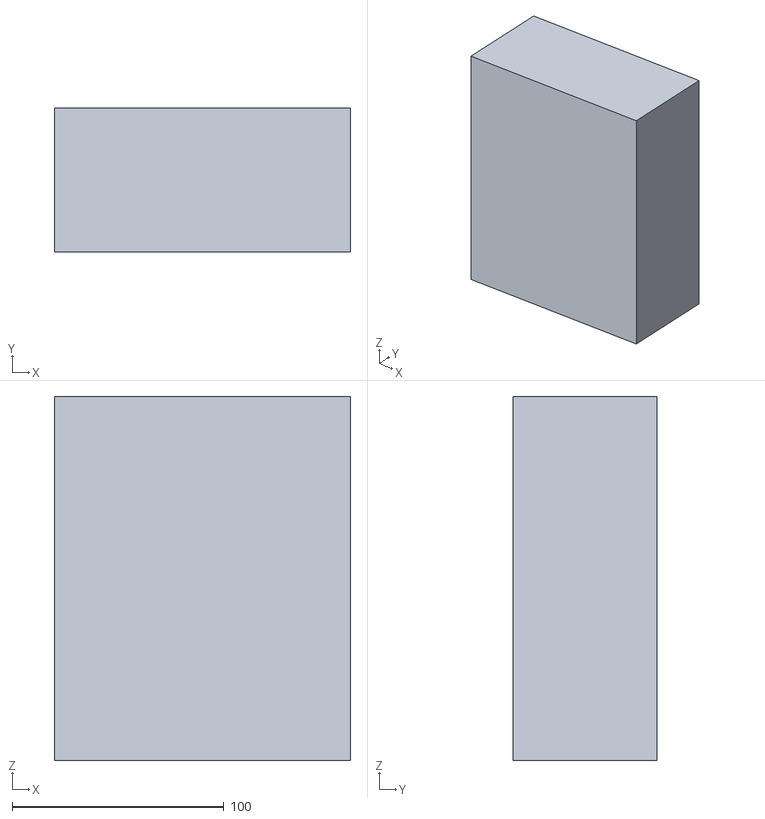
[picture p16: CAD file, 2025-09-17]
Code/C#/FlybackModelling/Meshes/UsingUY30MnZnPC40130x95mm.obj
140.0 x 68.0 x 172.0
Mesh1 Model
Mesh2 Model
Mesh3 Model
Mesh4 Model
Mesh5 Model
Mesh6 Model
Mesh7 Model
Mesh8 Model
Mesh9 Model
Mesh10 Model
Mesh11 Model
Mesh12 Model
Mesh13 Model
Mesh14 Model
Mesh15 Model
Mesh16 Model
Mesh17 Model
Mesh18 Model
Mesh19 Model
