harrypatrick442/hvps/Structure/Assembly/TubeFitTest.stl

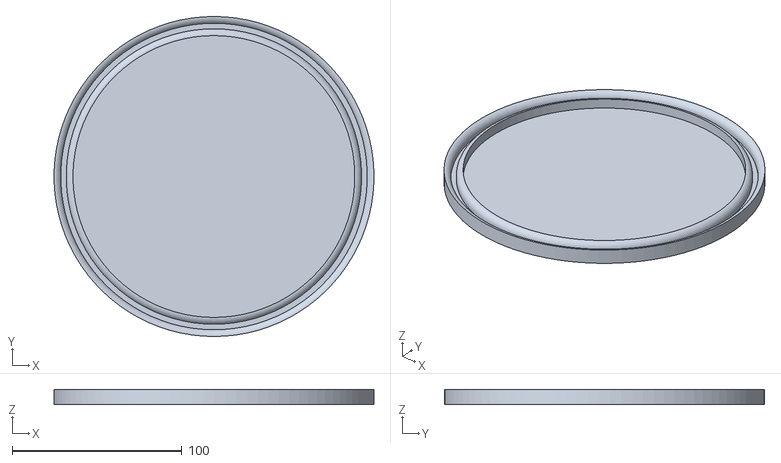
[picture p17: CAD file, 2025-09-17]
Structure/Assembly/TubeFitTest.stl
188.4 x 188.5 x 9.00
