harrypatrick442/hvps/Structure/Base/G.3mf

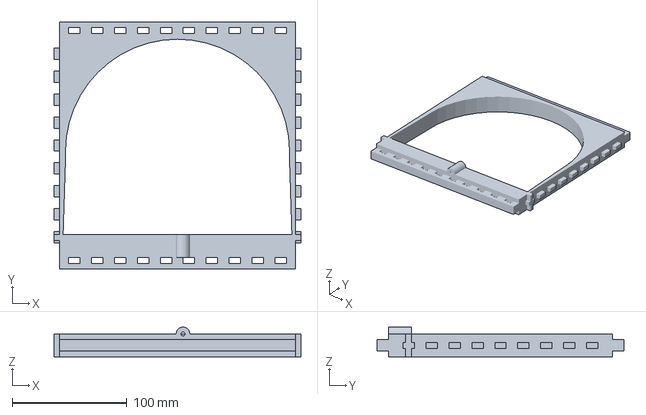
[picture p18: CAD file, 2025-09-17]
Structure/Base/G.3mf
215.0 x 215.0 x 26.0 mm
