harrypatrick442/hvps/Structure/DummyLoadResistorsCase/DummyLoadResistorsCase.3mf

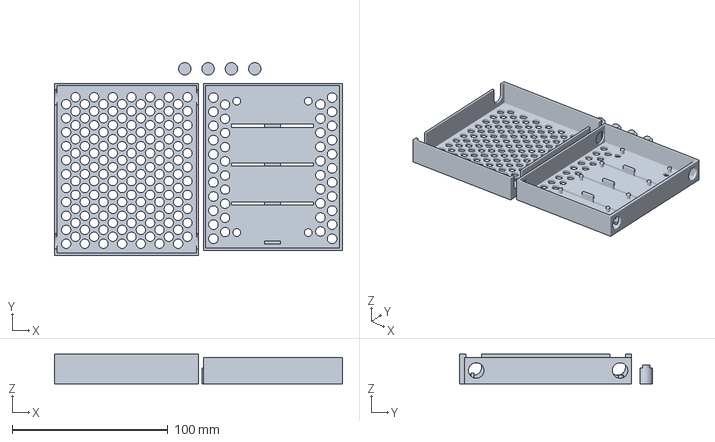
[picture p19: CAD file, 2026-01-17]
Structure/DummyLoadResistorsCase/DummyLoadResistorsCase.3mf
185.2 x 124.0 x 19.0 mm
