harrypatrick442/hvps/Structure/Experimentation/SlidingDovetailJointMale.stl

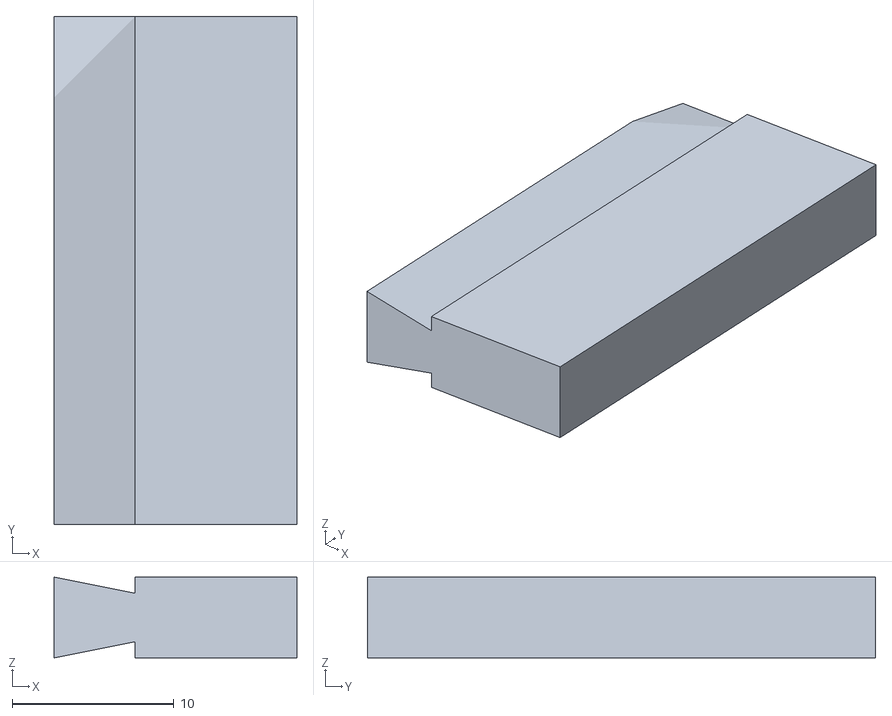
[picture p20: CAD file, 2025-09-17]
Structure/Experimentation/SlidingDovetailJointMale.stl
15.0 x 31.4 x 5.00
