harrypatrick442/hvps/Structure/FlybackBobin/FlybackBobinPerfectedSimpleDesign.stl

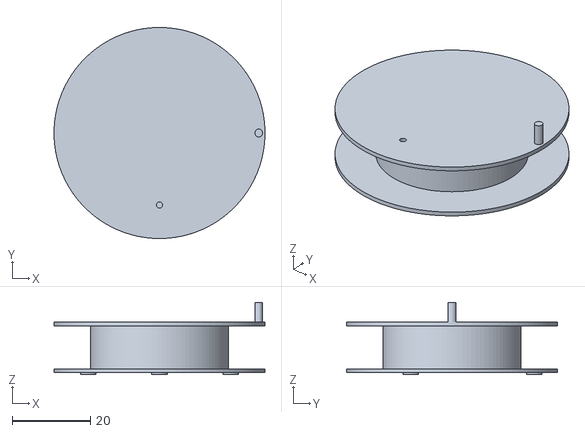
[picture p21: CAD file, 2025-09-17]
Structure/FlybackBobin/FlybackBobinPerfectedSimpleDesign.stl
54.0 x 54.0 x 18.5
