harrypatrick442/hvps/Structure/LM75AMounts/LM75APad.3mf

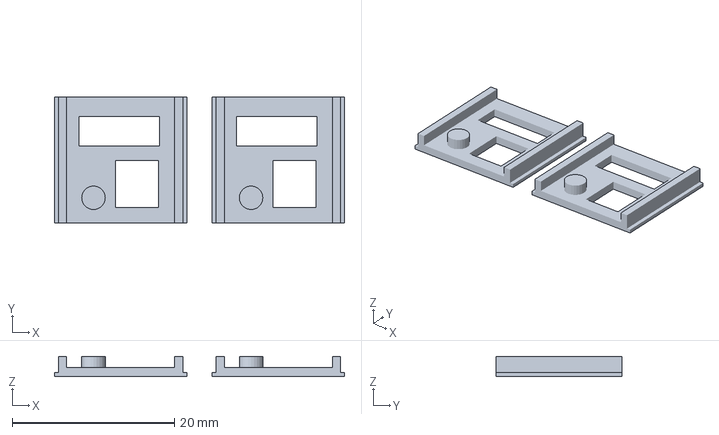
[picture p22: CAD file, 2026-01-17]
Structure/LM75AMounts/LM75APad.3mf
35.7 x 15.5 x 2.50 mm
