harrypatrick442/hvps/Structure/SoftStartResistorInsulator/SoftStartResistorInsulator.3mf

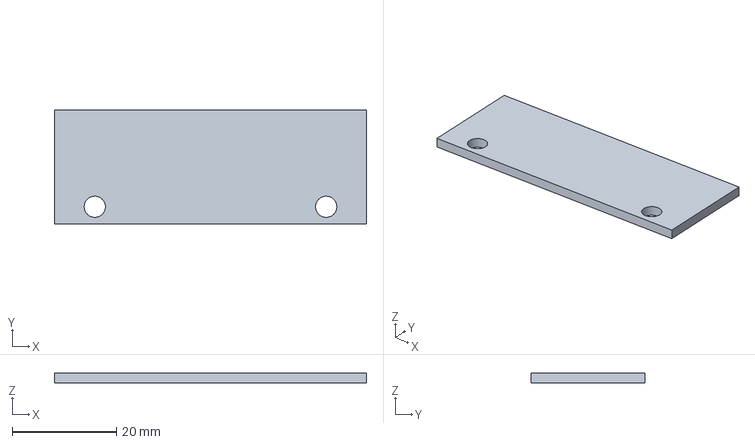
[picture p23: CAD file, 2025-09-17]
Structure/SoftStartResistorInsulator/SoftStartResistorInsulator.3mf
60.0 x 22.0 x 2.00 mm
