harrypatrick442/hvps/Structure/TransformerAirGapSpacers/TransformerAirGapSpacers.3mf

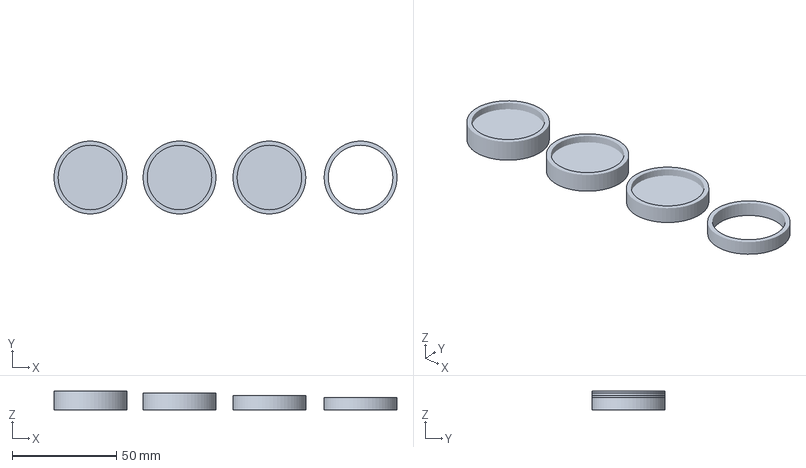
[picture p24: CAD file, 2026-01-30]
Structure/TransformerAirGapSpacers/TransformerAirGapSpacers.3mf
164.8 x 35.0 x 9.00 mm
