harrypatrick442/hvps/Structure/Assembly/ThreadFeeder.3mf

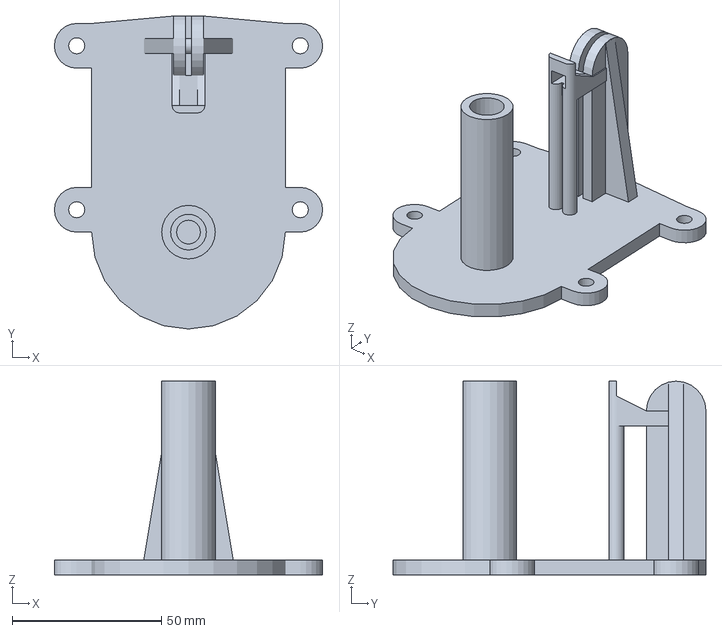
[picture p26: CAD file, 2025-09-17]
Structure/Assembly/ThreadFeeder.3mf
90.0 x 105.0 x 65.0 mm
