harrypatrick442/hvps/Structure/Base/E.3mf

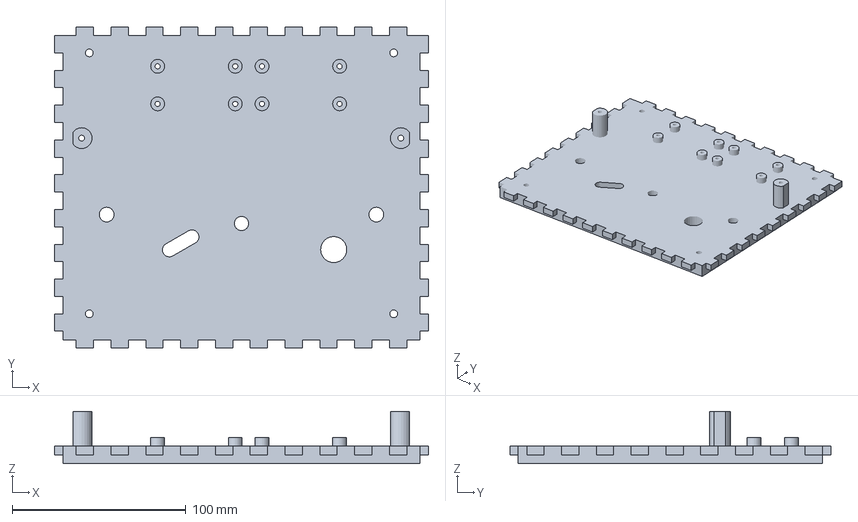
[picture p27: CAD file, 2025-09-17]
Structure/Base/E.3mf
215.0 x 184.8 x 30.0 mm
