harrypatrick442/hvps/Structure/Experimentation/TestPart2.3mf

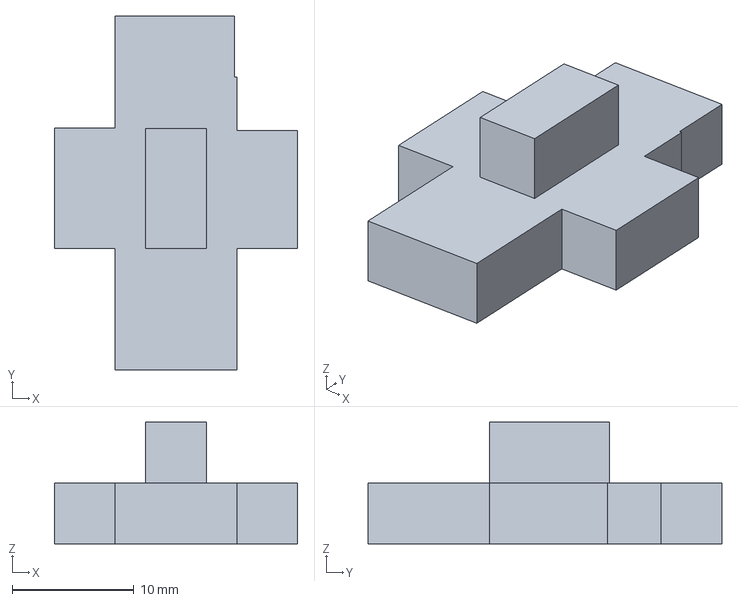
[picture p28: CAD file, 2025-09-17]
Structure/Experimentation/TestPart2.3mf
20.0 x 29.1 x 10.0 mm
