harrypatrick442/hvps/Structure/FlybackBobin/FlybackBobin4LowestVoltageEnd.stl

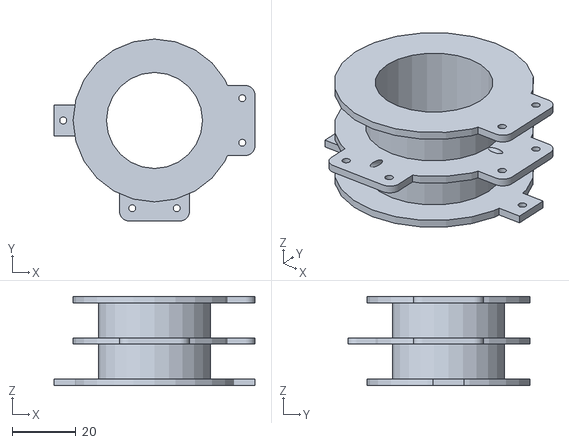
[picture p29: CAD file, 2025-09-17]
Structure/FlybackBobin/FlybackBobin4LowestVoltageEnd.stl
63.2 x 57.2 x 28.0
