harrypatrick442/hvps/Structure/LM75AMounts/LM75AClip.3mf

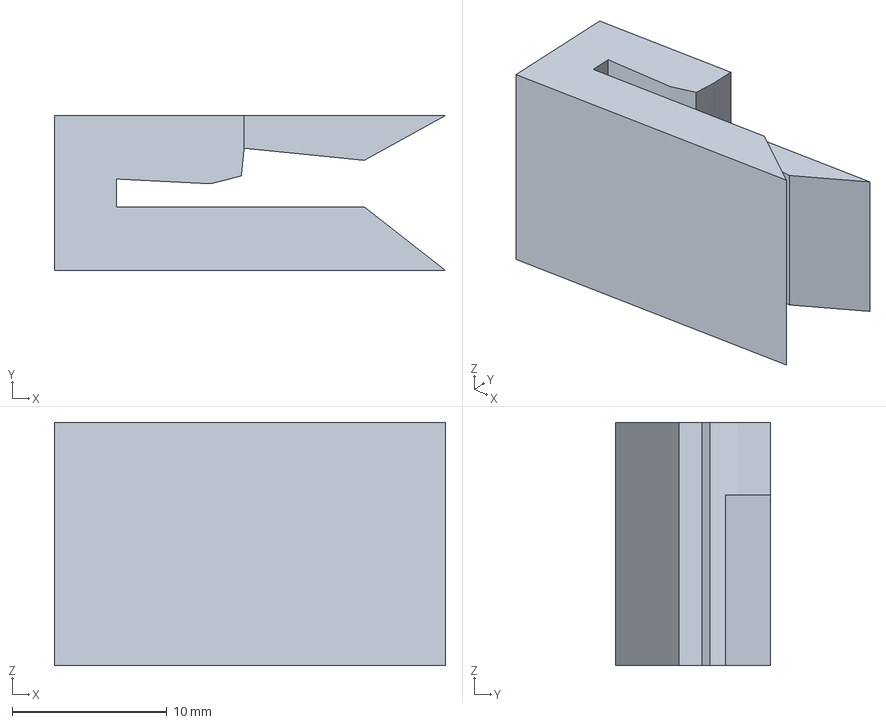
[picture p30: CAD file, 2026-01-17]
Structure/LM75AMounts/LM75AClip.3mf
25.2 x 10.0 x 15.7 mm
