harrypatrick442/hvps/Code/C#/FlybackModelling/Meshes/FlybackTransformer.obj

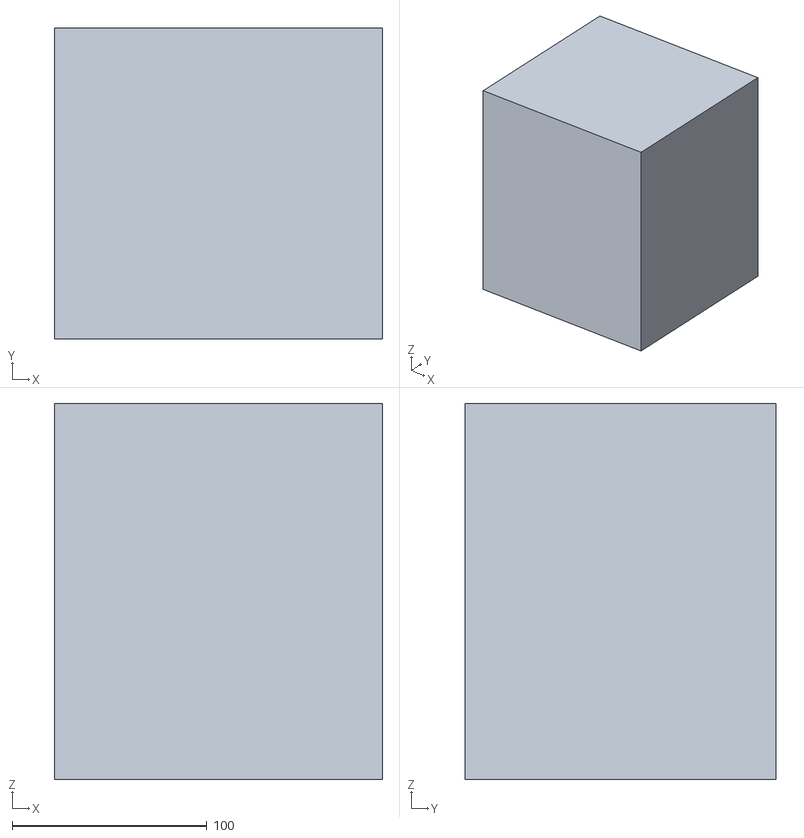
[picture p31: CAD file, 2025-09-17]
Code/C#/FlybackModelling/Meshes/FlybackTransformer.obj
168.5 x 159.5 x 193.0
