harrypatrick442/hvps/Structure/Assembly/TubeCap.stl

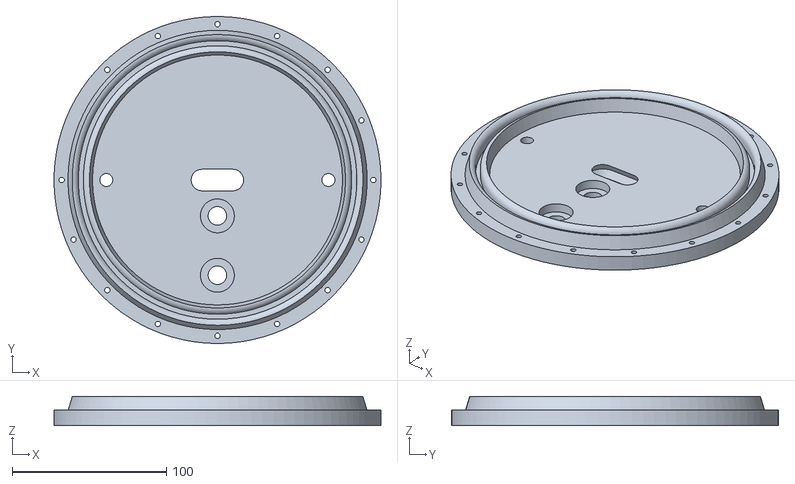
[picture p32: CAD file, 2025-09-17]
Structure/Assembly/TubeCap.stl
211.9 x 212.0 x 19.0
