harrypatrick442/hvps/Structure/Base/B.3mf

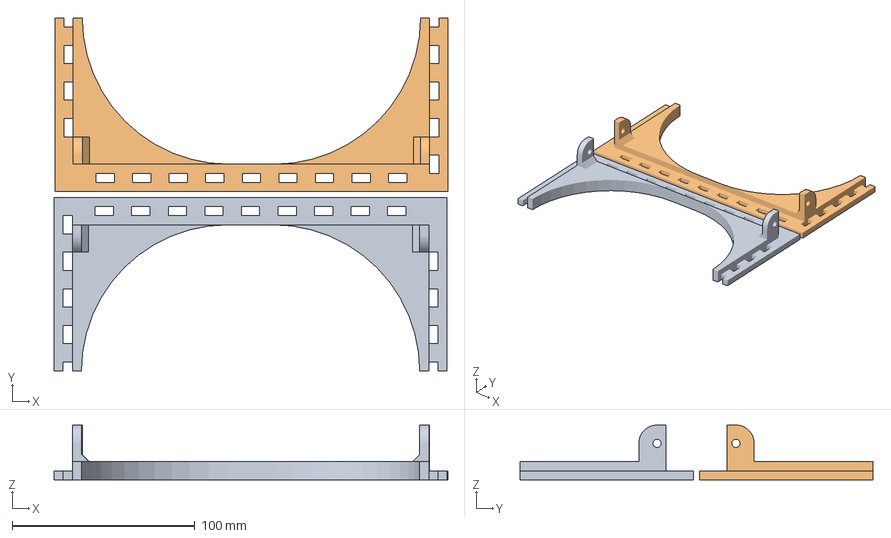
[picture p33: CAD file, 2025-09-17]
Structure/Base/B.3mf
215.5 x 193.1 x 30.0 mm
B.stl x 2
