harrypatrick442/hvps/Structure/Experimentation/TestPart1.3mf

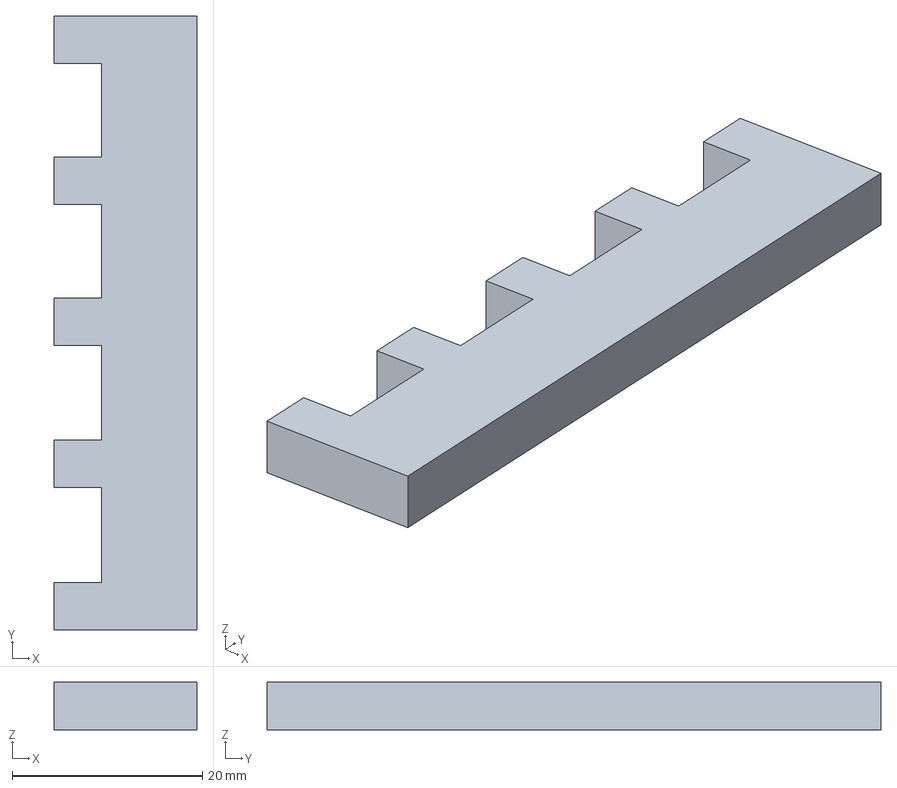
[picture p34: CAD file, 2025-09-17]
Structure/Experimentation/TestPart1.3mf
15.0 x 64.6 x 5.00 mm
