harrypatrick442/hvps/Structure/FlybackBobin/FlybackBobin1HighestVoltageEnd.stl

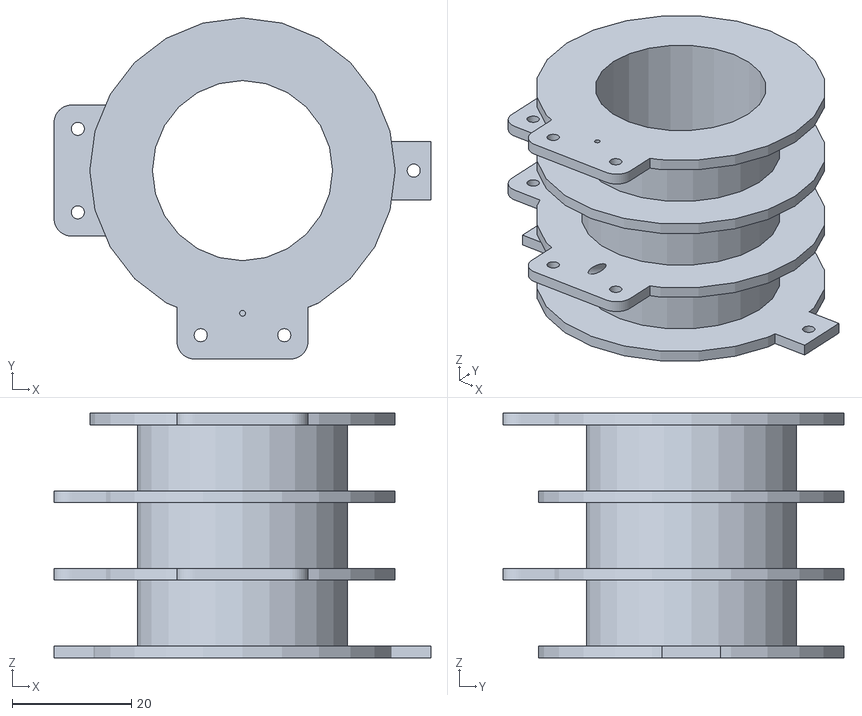
[picture p35: CAD file, 2025-09-17]
Structure/FlybackBobin/FlybackBobin1HighestVoltageEnd.stl
63.2 x 57.2 x 41.0
