harrypatrick442/hvps/Code/C#/FlybackModelling/Meshes/CheckingCurrentDensity.obj

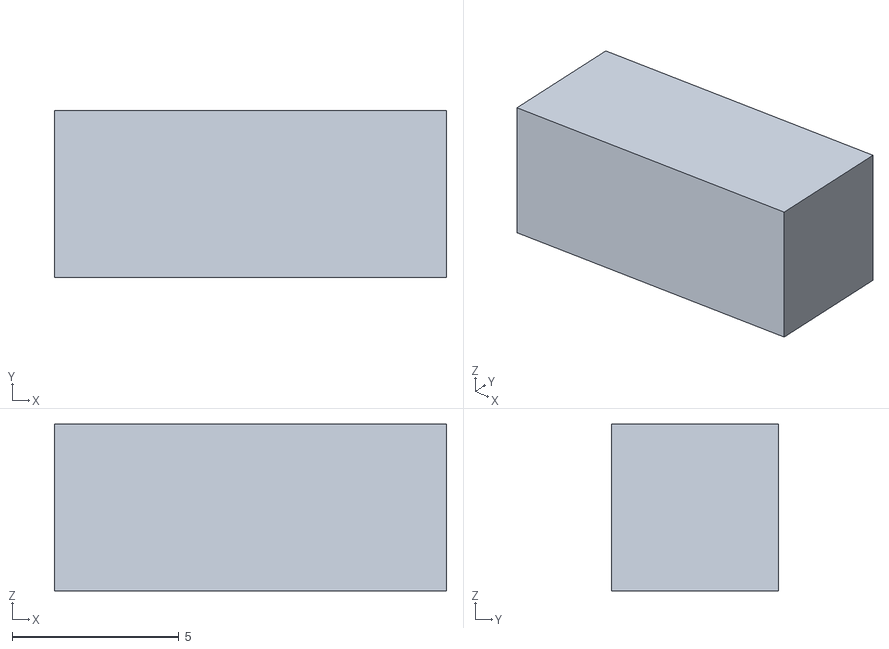
[picture p36: CAD file, 2025-09-17]
Code/C#/FlybackModelling/Meshes/CheckingCurrentDensity.obj
11.8 x 5.00 x 5.00
Mesh1 Component_1_1 Model
Mesh2 Component_1_1 Model
