harrypatrick442/hvps/Structure/Base/D.3mf

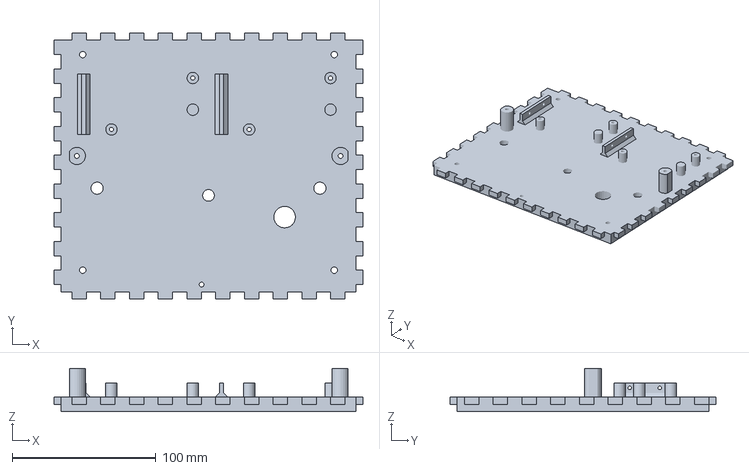
[picture p37: CAD file, 2025-09-17]
Structure/Base/D.3mf
215.0 x 185.0 x 30.0 mm
