harrypatrick442/hvps/Structure/Experimentation/BoxJoint005Female.stl

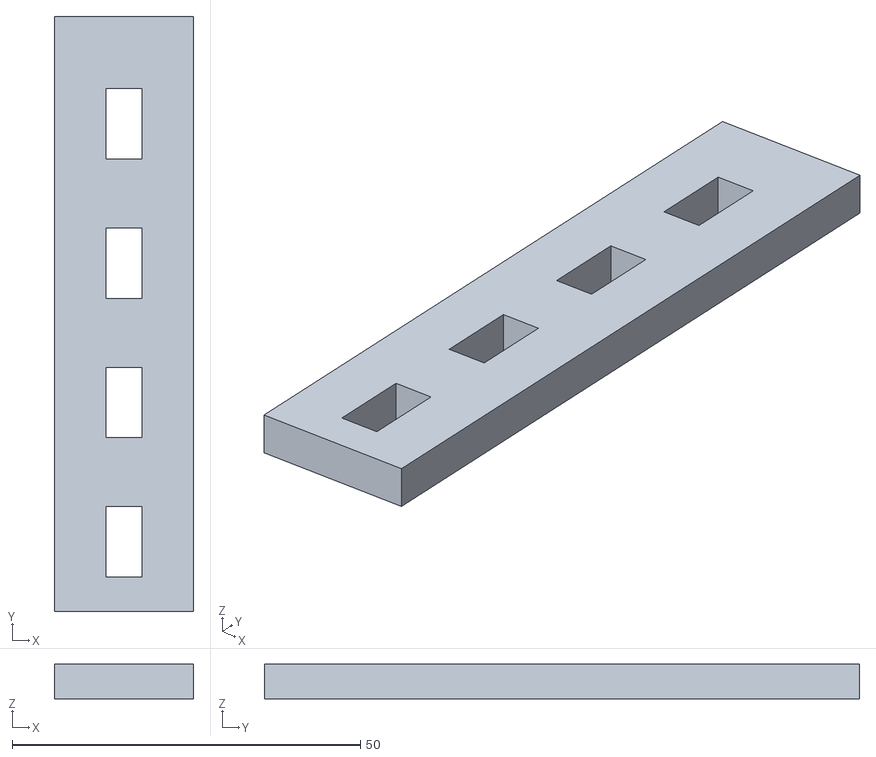
[picture p38: CAD file, 2025-09-17]
Structure/Experimentation/BoxJoint005Female.stl
20.0 x 85.4 x 5.00
