harrypatrick442/hvps/Structure/Assembly/TubeBase.stl

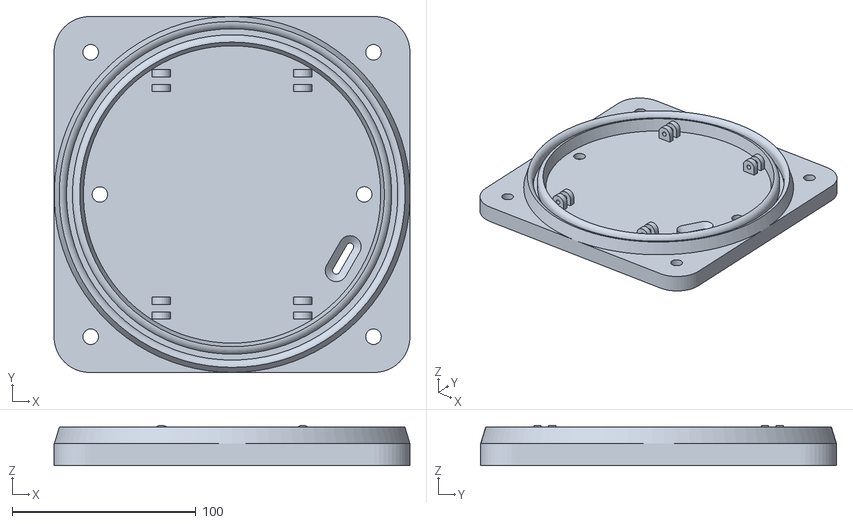
[picture p39: CAD file, 2025-09-17]
Structure/Assembly/TubeBase.stl
194.0 x 194.0 x 22.0
