harrypatrick442/hvps/Structure/Base/A.3mf

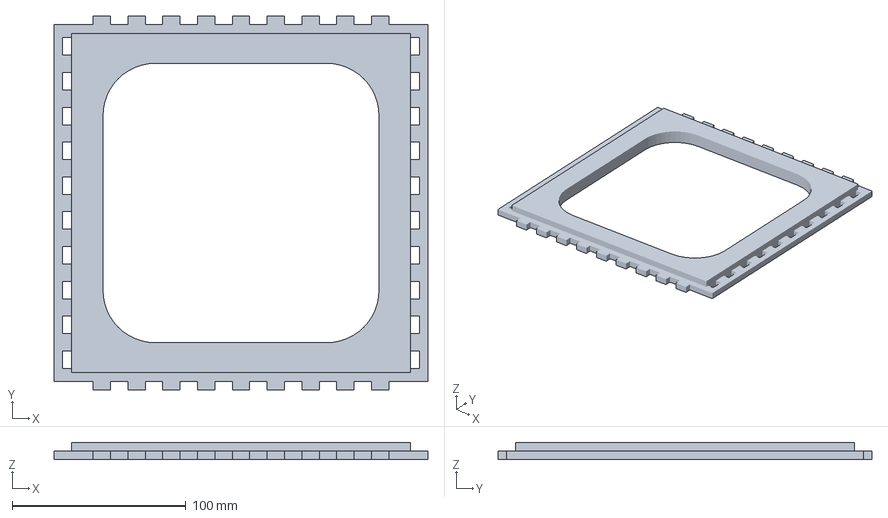
[picture p40: CAD file, 2025-09-17]
Structure/Base/A.3mf
215.0 x 215.0 x 10.0 mm
