harrypatrick442/hvps/Structure/Experimentation/BoxJoint005.stl

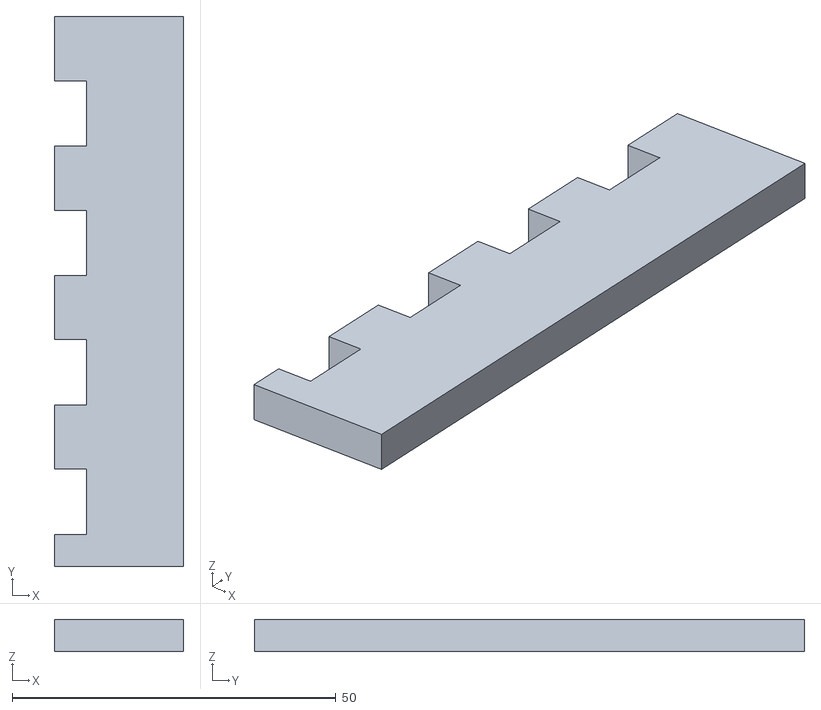
[picture p41: CAD file, 2025-09-17]
Structure/Experimentation/BoxJoint005.stl
20.0 x 85.0 x 5.00
