harrypatrick442/hvps/Structure/FlybackBobin/WindingBoss.3mf

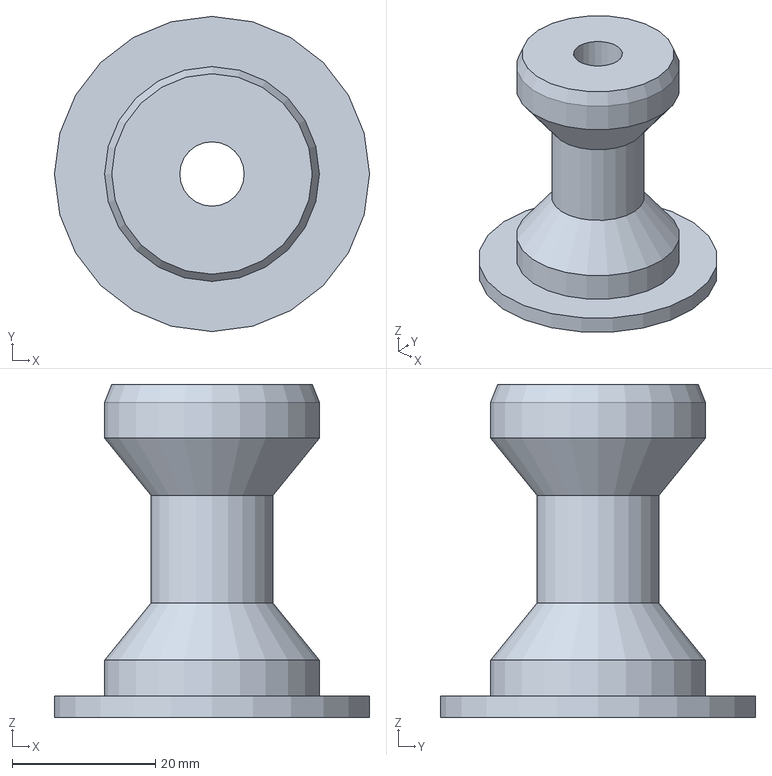
[picture p42: CAD file, 2025-09-17]
Structure/FlybackBobin/WindingBoss.3mf
44.0 x 44.0 x 46.5 mm
