harrypatrick442/hvps/Structure/Base/I.3mf

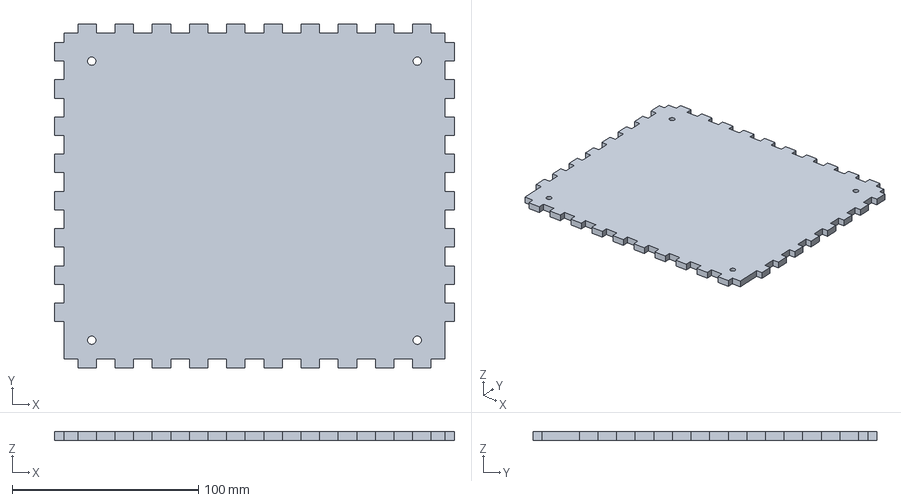
[picture p43: CAD file, 2025-09-17]
Structure/Base/I.3mf
215.0 x 185.0 x 5.00 mm
