harrypatrick442/hvps/Structure/Base/H.3mf

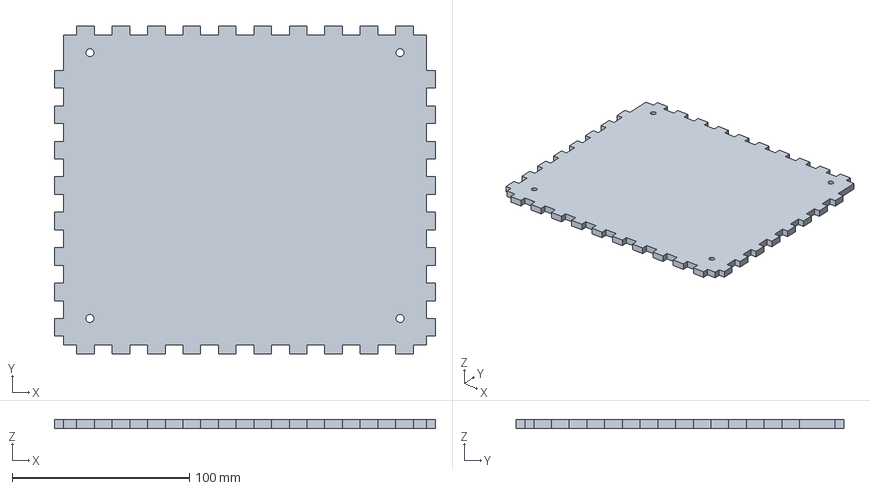
[picture p44: CAD file, 2025-09-17]
Structure/Base/H.3mf
215.0 x 185.0 x 5.00 mm
