harrypatrick442/hvps/Structure/Experimentation/SlidingHalfDovetailJointMale.stl

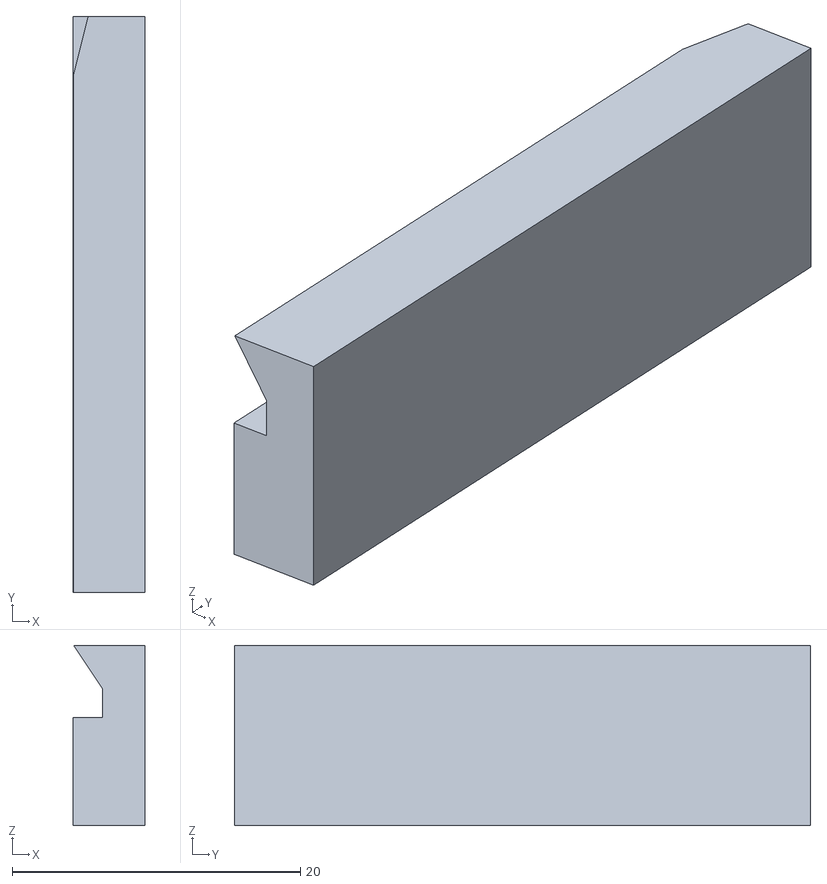
[picture p45: CAD file, 2025-09-17]
Structure/Experimentation/SlidingHalfDovetailJointMale.stl
5.00 x 40.0 x 12.5
