harrypatrick442/hvps/Structure/Base/F.3mf

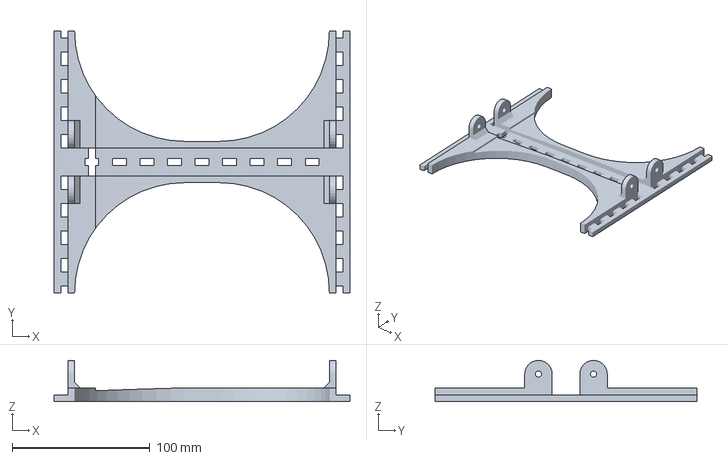
[picture p46: CAD file, 2025-09-17]
Structure/Base/F.3mf
215.0 x 190.0 x 30.0 mm
