harrypatrick442/hvps/Structure/Base/J.3mf

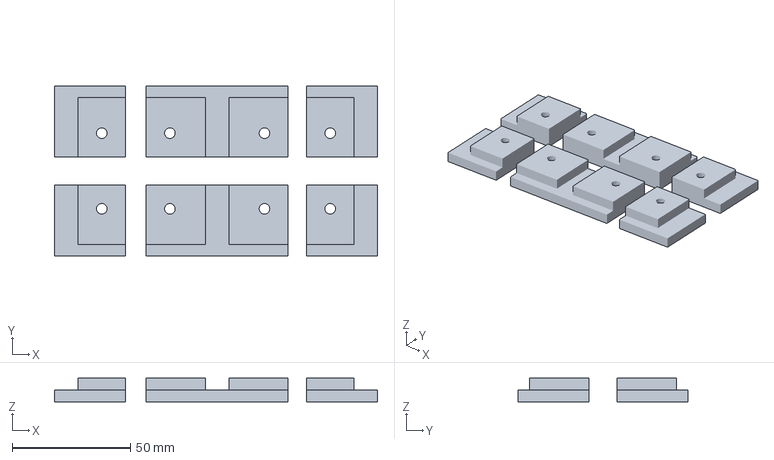
[picture p47: CAD file, 2025-09-17]
Structure/Base/J.3mf
136.6 x 72.0 x 10.00 mm
