harrypatrick442/hvps/Structure/Base/C.3mf

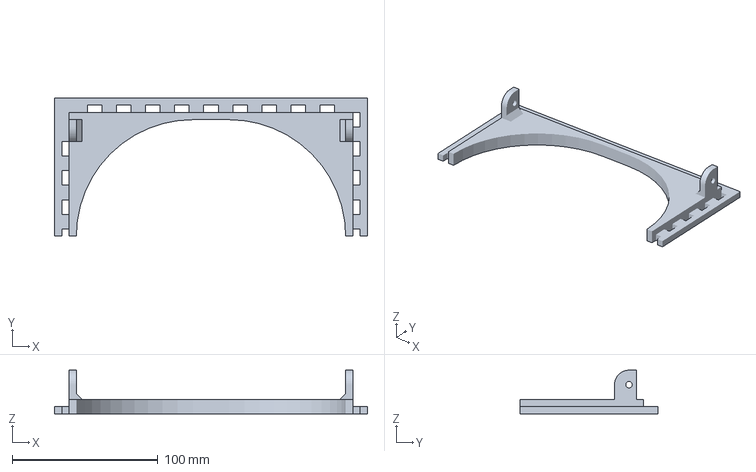
[picture p48: CAD file, 2025-09-17]
Structure/Base/C.3mf
215.0 x 95.0 x 30.0 mm
