harrypatrick442/hvps/Structure/Experimentation/BoxJoint0.stl

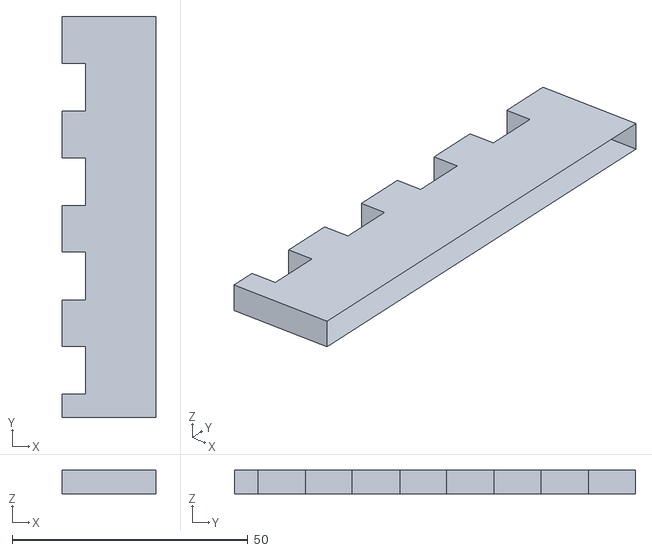
[picture p49: CAD file, 2025-09-17]
Structure/Experimentation/BoxJoint0.stl
20.0 x 85.0 x 5.00
