harrypatrick442/hvps/Structure/Experimentation/SlidingDovetailJointFemale.stl

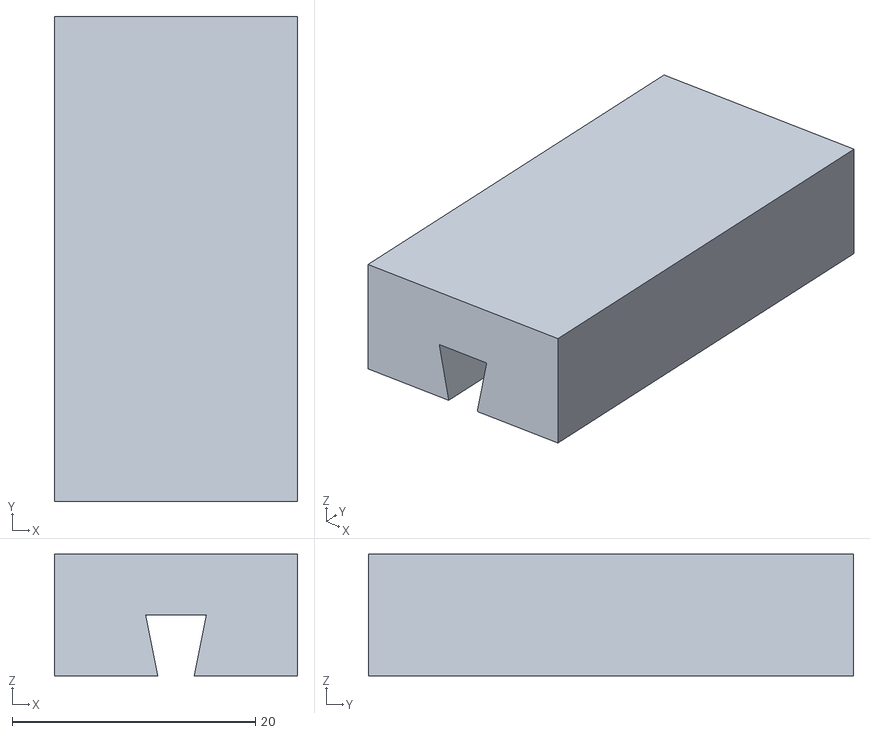
[picture p50: CAD file, 2025-09-17]
Structure/Experimentation/SlidingDovetailJointFemale.stl
20.0 x 39.9 x 10.0
