harrypatrick442/hvps/Structure/FlybackBobin/TubePlate.3mf

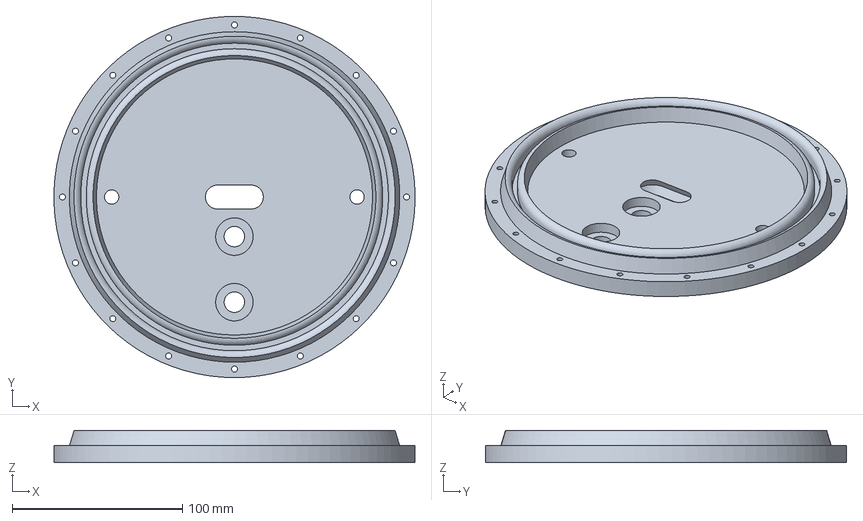
[picture p51: CAD file, 2025-09-17]
Structure/FlybackBobin/TubePlate.3mf
211.9 x 212.0 x 19.0 mm
