harrypatrick442/hvps/Structure/Experimentation/SlidingHalfDovetailJointFemale.stl

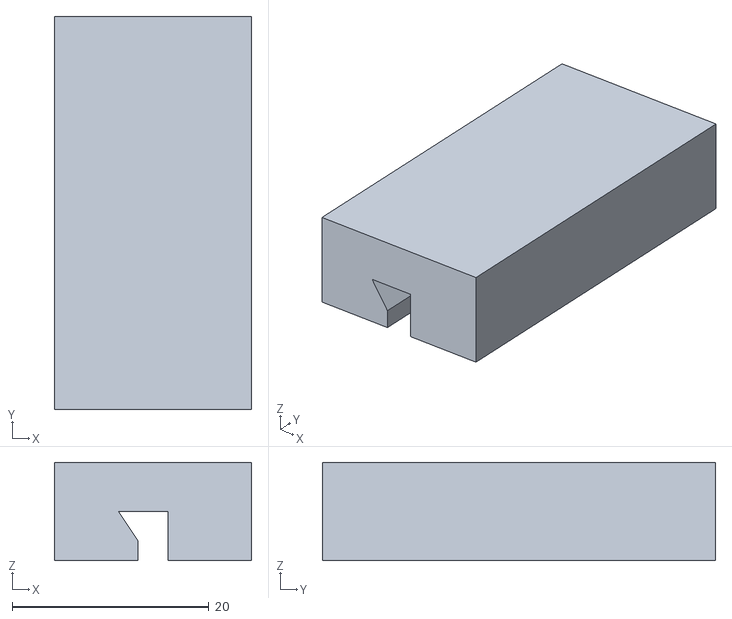
[picture p52: CAD file, 2025-09-17]
Structure/Experimentation/SlidingHalfDovetailJointFemale.stl
20.0 x 39.9 x 10.0
