harrypatrick442/hvps/Structure/Experimentation/TestPartFemale.3mf

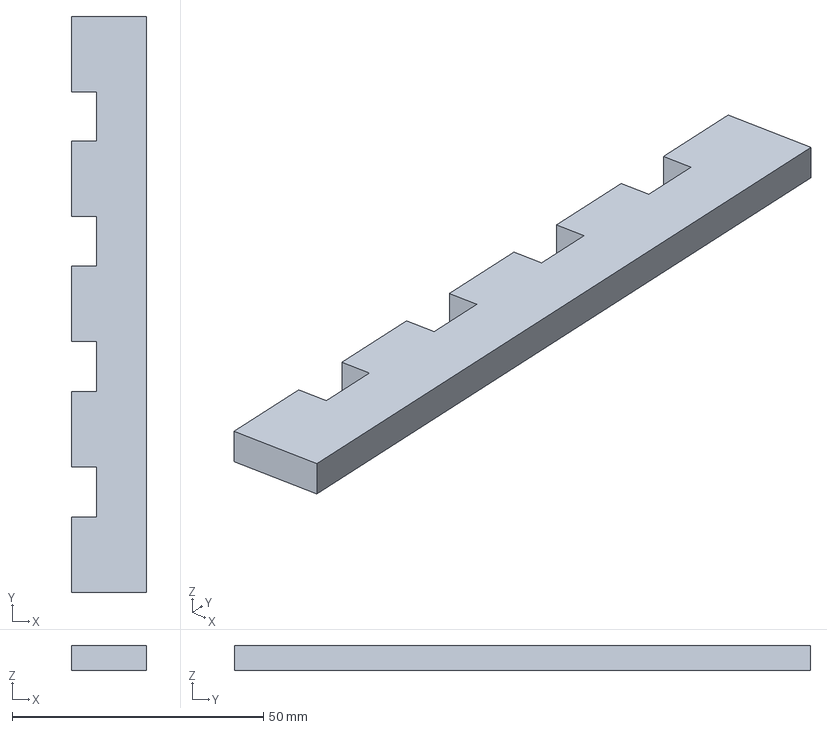
[picture p53: CAD file, 2025-09-17]
Structure/Experimentation/TestPartFemale.3mf
15.0 x 114.6 x 5.00 mm
