harrypatrick442/hvps/(list of files, cad)

Other CAD files:
Structure/DummyLoadResistorsCase2/DummyLoadResistorsCase2.3mf
Structure/FlybackBobin/Bobin4.3mf
Structure/Experimentation/TestPartMale.3mf
Structure/FlybackBobin/CustomFlybackBobin.3mf
Structure/FlybackBobin/FlybackBobin2.stl
Structure/FlybackBobin/Bobin2.3mf
Structure/FlybackBobin/Bobin1.3mf
Structure/FlybackBobin/FlybackBobin1HighestVoltageEnd.stl.stl
Structure/FlybackBobin/FlybackBobin4.stl
Code/C#/FlybackModelling/Meshes/CheckingCurrentDensity.skp
Code/C#/FlybackModelling/Meshes/FlybackTransformer.skp
Code/C#/FlybackModelling/Meshes/FlybackTransformerUnexploded.skp
Code/C#/FlybackModelling/Meshes/UsingPC40_UU120X160X20.skp
Code/C#/FlybackModelling/Meshes/UsingUY30MnZnPC40130x95mm.skp
Structure/Assembly/Assembly.skp
Structure/Assembly/SpacerForAssembling.skp
Structure/Assembly/ThreadFeeder.skp
Structure/Assembly/ThreadFeeder.stl
Structure/Assembly/TubeBase.skp
Structure/Assembly/TubeCap.skp
Structure/Assembly/TubeFitTest.skp
Structure/Base/A.skp
Structure/Base/A.stl
Structure/Base/B.skp
Structure/Base/B.stl
Structure/Base/C.skp
Structure/Base/C.stl
Structure/Base/D.skp
Structure/Base/D.stl
Structure/Base/E.skp
Structure/Base/E.stl
Structure/Base/F.skp
Structure/Base/F.stl
Structure/Base/G.obj
Structure/Base/G.skp
Structure/Base/G.stl
Structure/Base/H.skp
Structure/Base/H.stl
Structure/Base/I.skp
Structure/Base/I.stl
Structure/Base/J.skp
Structure/Base/J.stl
Structure/DummyLoadResistorsCase/DummyLoadResistorsCase.skp
Structure/DummyLoadResistorsCase/DummyLoadResistorsCase.stl
Structure/DummyLoadResistorsCase2/DummyLoadResistorsCase2.skp
Structure/DummyLoadResistorsCase2/DummyLoadResistorsCase2.stl
Structure/Experimentation/BoxJoint0.05.skp
Structure/Experimentation/SlidingDovetailJointMale.skp
Structure/Experimentation/TestPart1.obj
Structure/Experimentation/TestPart1.skp
Structure/Experimentation/TestPart1.stl
Structure/Experimentation/TestPart1_old.3mf
Structure/Experimentation/TestPart2.skp
Structure/Experimentation/TestPart2.stl
Structure/Experimentation/TestPartFemale.skp
Structure/Experimentation/TestPartMale.stl
Structure/FlybackBobin/FlybackBobin.skp
Structure/FlybackBobin/FlybackBobin1HighestVoltageEnd.obj
Structure/FlybackBobin/FlybackBobin1HighestVoltageEnd.skp
Structure/FlybackBobin/FlybackBobin1HighestVoltageEnd_Attempt2.skp
Structure/FlybackBobin/FlybackBobin1HighestVoltageEnd_Attempt3.skp
Structure/FlybackBobin/FlybackBobin2.skp
Structure/FlybackBobin/FlybackBobin3.skp
Structure/FlybackBobin/FlybackBobin4LowestVoltageEnd.skp
Structure/FlybackBobin/FlybackBobinBeforeMakeGroundSideThinnerToReduceLeakageInductance.skp
Structure/FlybackBobin/FlybackBobinPerfectedSimpleDesign.skp
Structure/FlybackBobin/WindingBoss.skp
Structure/FlybackBobin/WindingBoss.stl
Structure/LM75AMounts/LM75AClip.skp
Structure/LM75AMounts/LM75AClip.stl
Structure/LM75AMounts/LM75AClip_Try0.skp
Structure/LM75AMounts/LM75APad.skp
Structure/LM75AMounts/LM75APad.stl
Structure/SoftStartResistorInsulator/SoftStartResistorInsulator.skp
Structure/SoftStartResistorInsulator/SoftStartResistorInsulator.stl
Structure/TransformerAirGapSpacers/TransformerAirGapSpacers.skp
Structure/TransformerAirGapSpacers/TransformerAirGapSpacers.stl
