harrypatrick442/hvps/Structure/Assembly/PCBImages/CompositeSeriesResistor.png

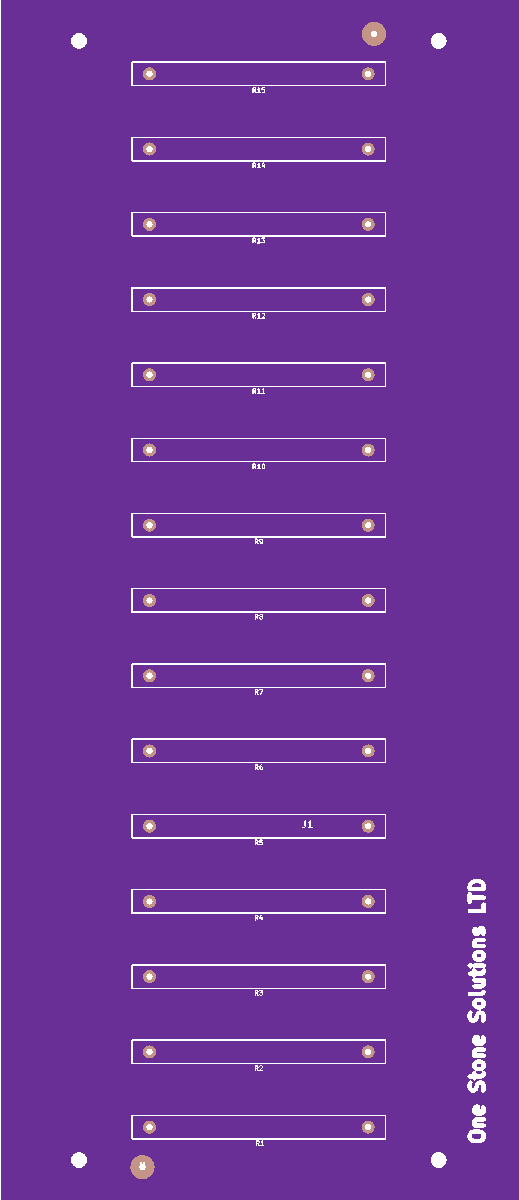
Structure/Assembly/PCBImages/CompositeSeriesResistor.png
