harrypatrick442/hvps/Structure/Assembly/PCBImages/HighVoltageFeedbackModule2.png

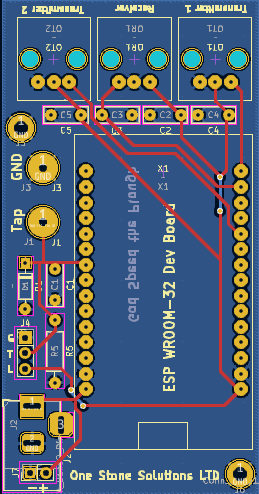
Structure/Assembly/PCBImages/HighVoltageFeedbackModule2.png
