harrypatrick442/hvps/Structure/Assembly/PCBImages/PCB.png

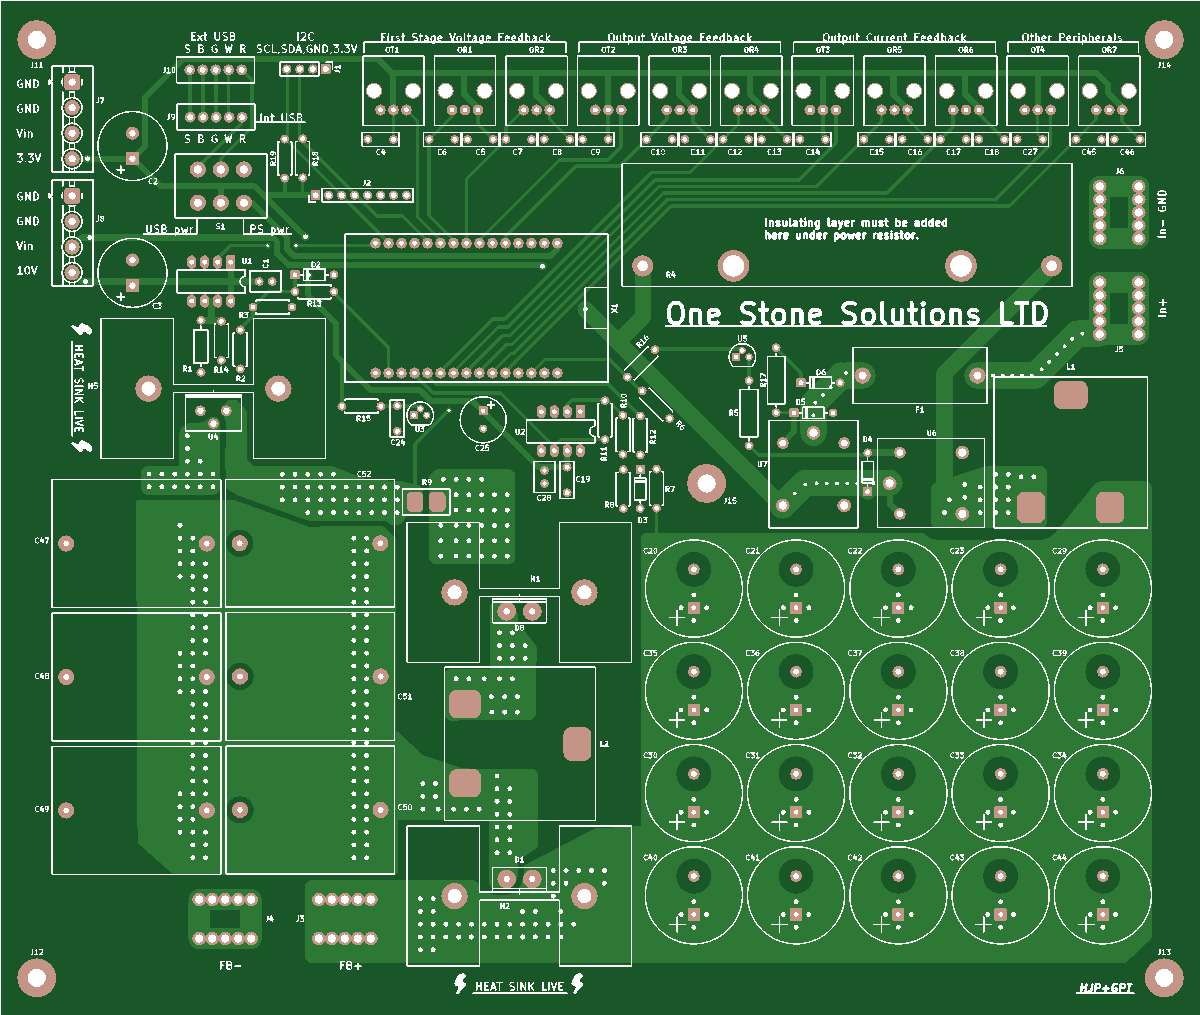
Structure/Assembly/PCBImages/PCB.png
