harrypatrick442/hvps/Structure/Assembly/PCBImages/VillardPCB.png

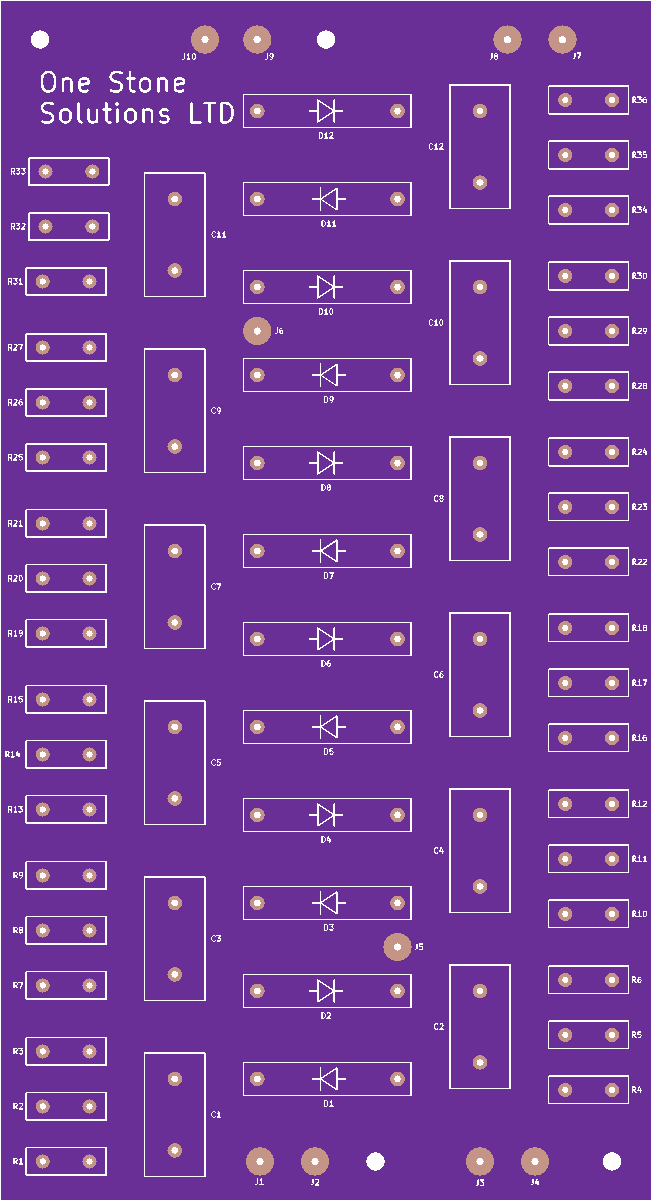
Structure/Assembly/PCBImages/VillardPCB.png
