harrypatrick442/hvps/Validation/Checking Controller.png

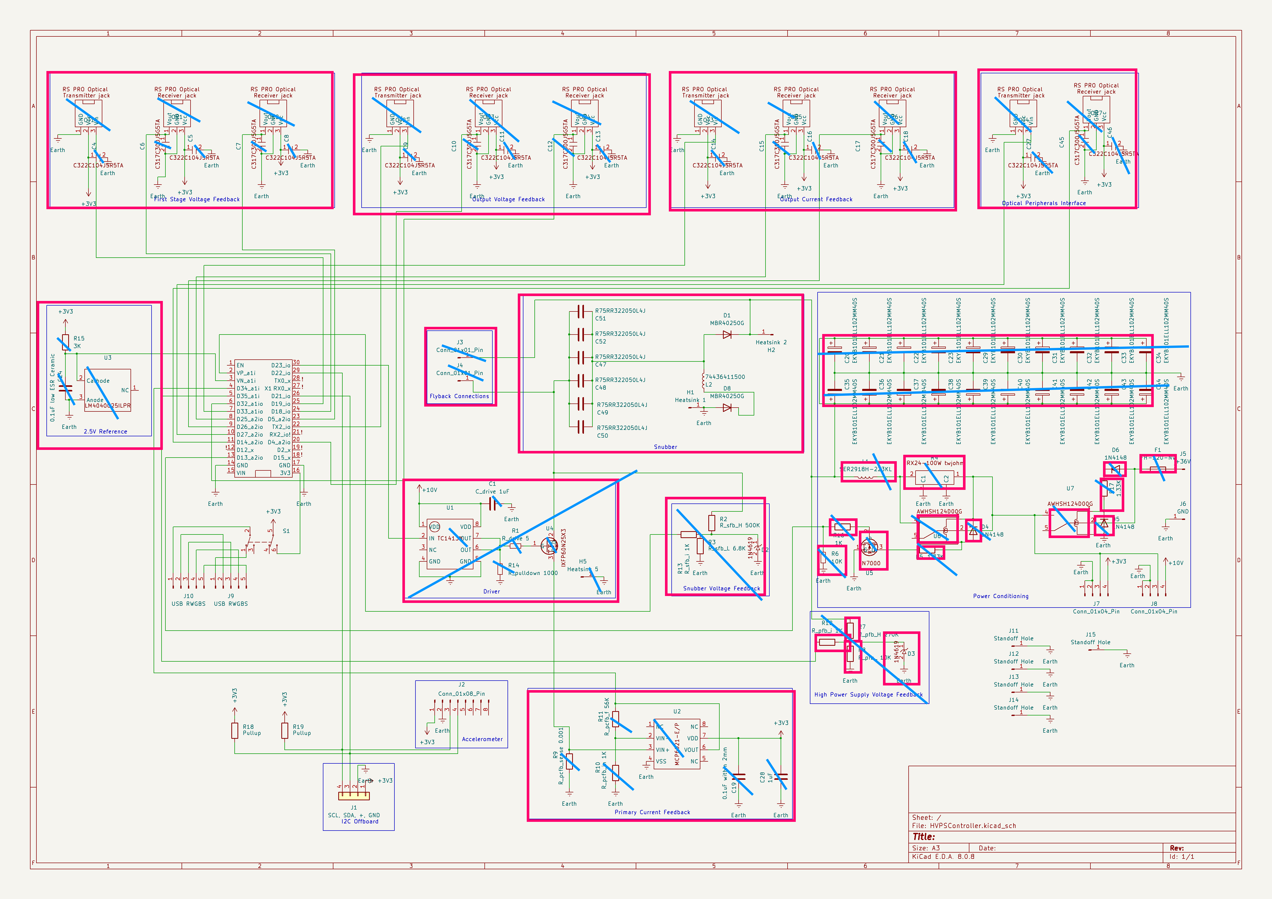
Validation/Checking Controller.png
