harrypatrick442/hvps/Validation/CheckingControllerPCB.png

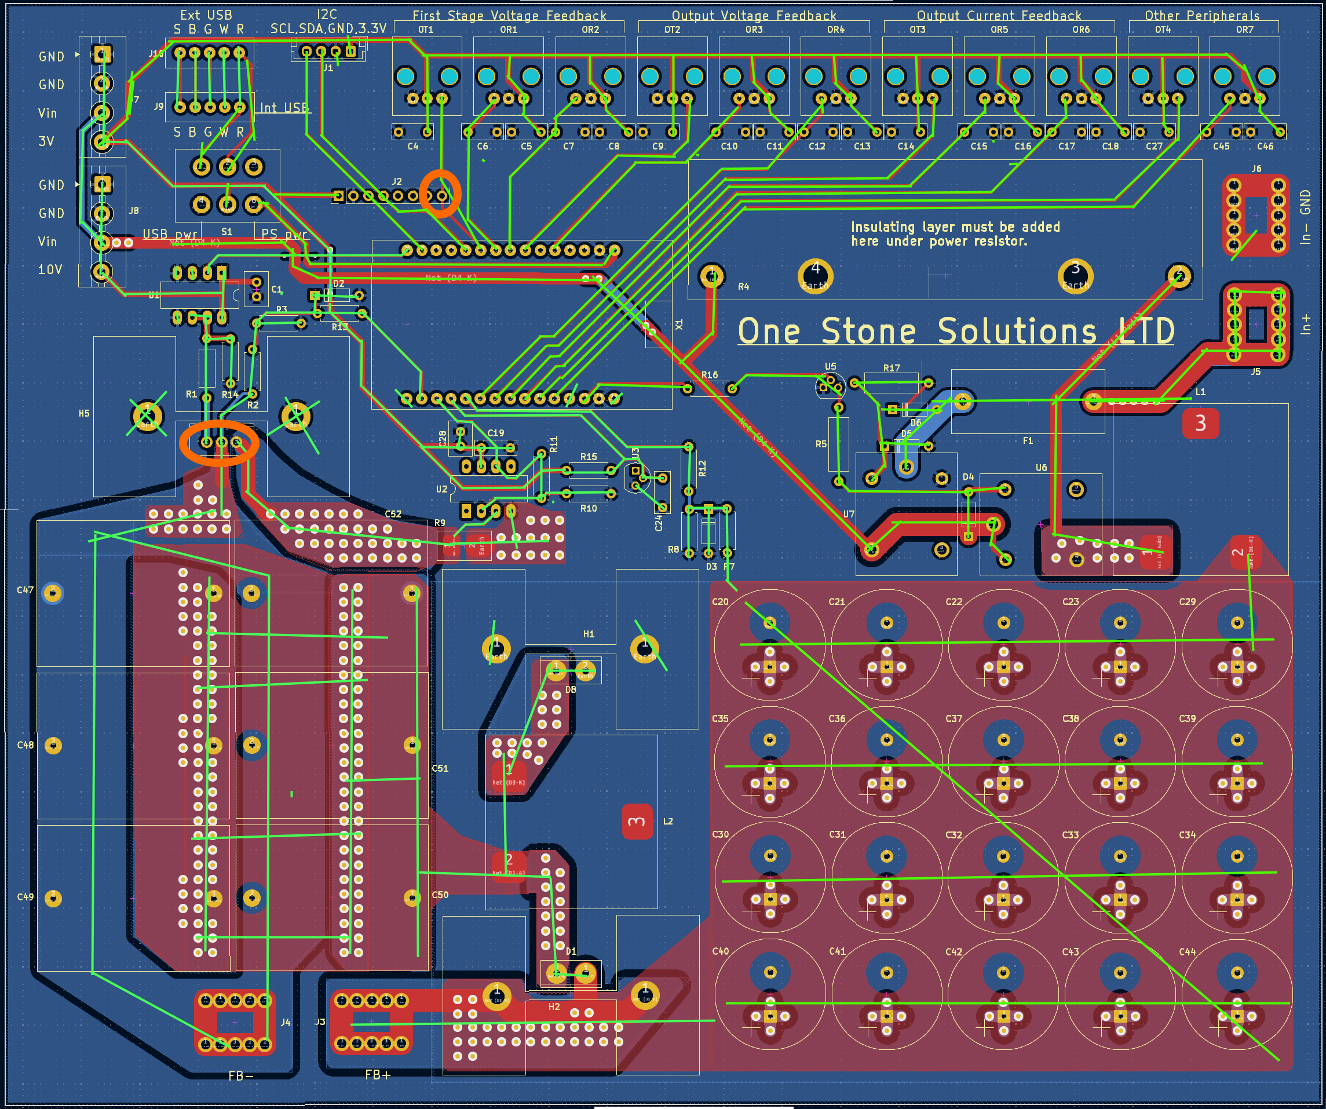
Validation/CheckingControllerPCB.png
