harrypatrick442/hvps/Validation/CheckingHighVoltageFeedbackModulePCB.png

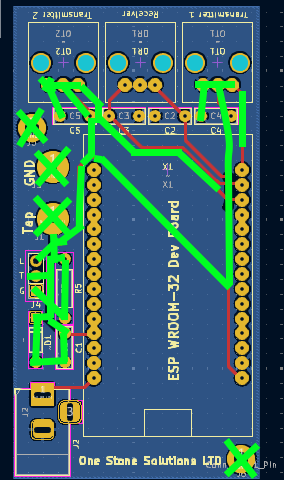
Validation/CheckingHighVoltageFeedbackModulePCB.png
