harrypatrick442/hvps/Code/C++/TODO IMPORTANT.txt

Must make sure voltage threshold set is capped. 
that low level locking mechanism check where used that it seemed to cause problems.
