harrypatrick442/hvps/MATLAB/schematic_capture.pdf

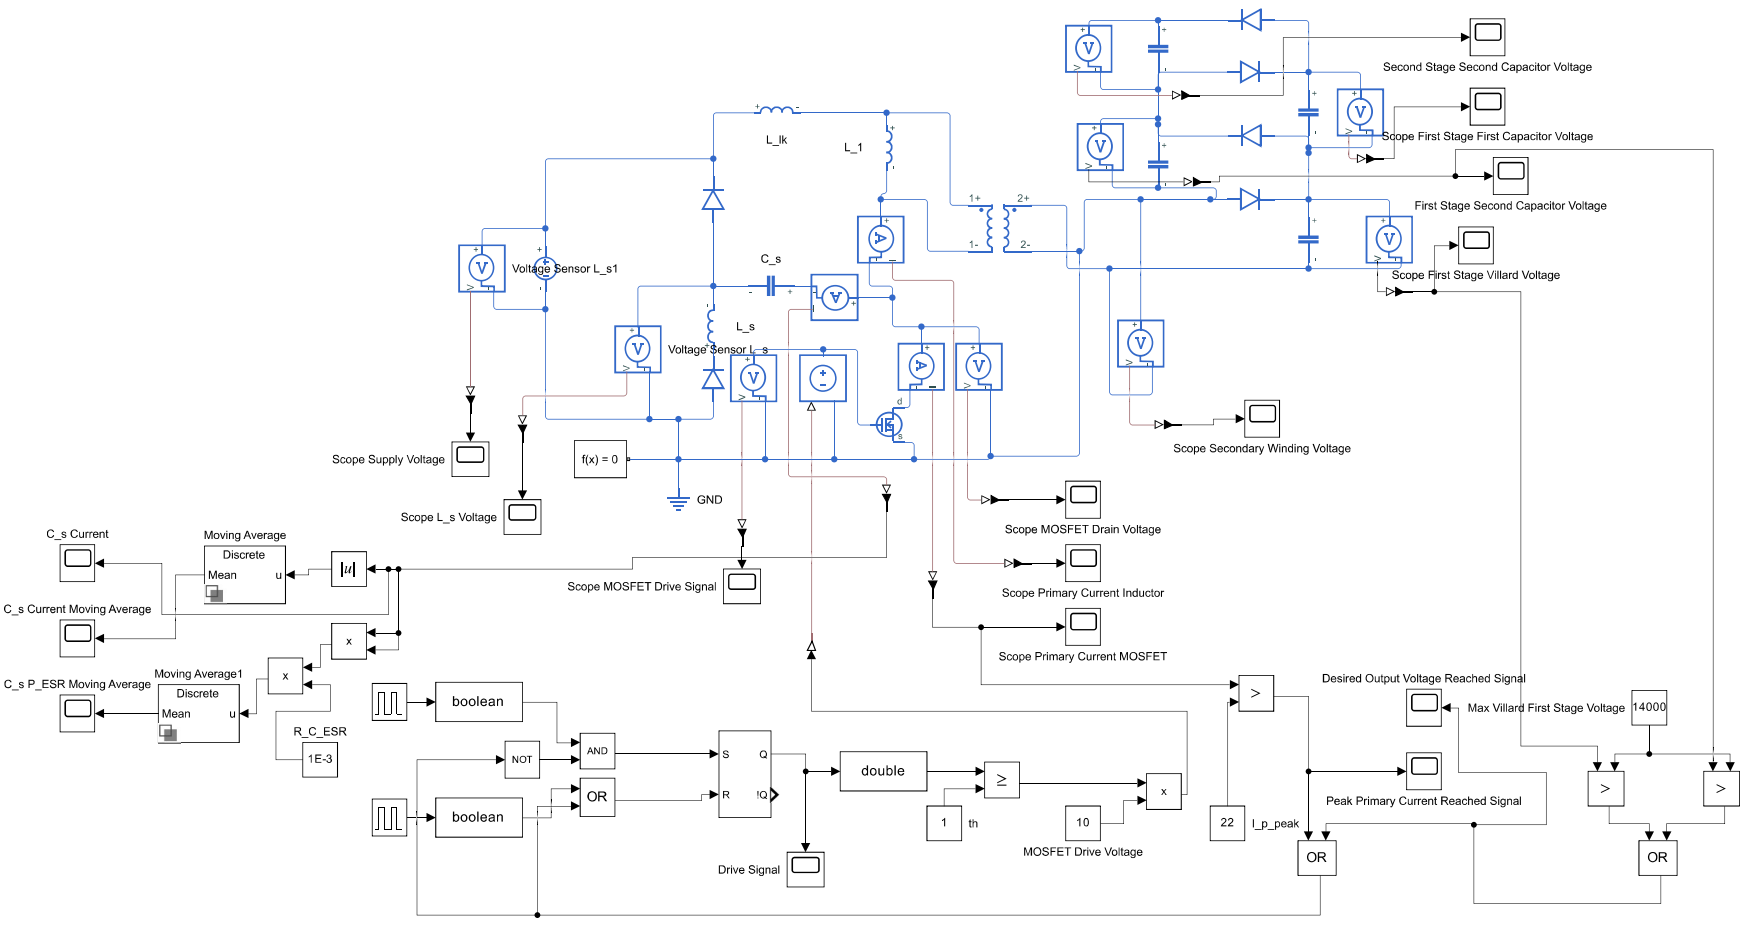
[picture p61: page 1]
