harrypatrick442/hvps/LTSpice/VillardCascadingModesOfFailure/FailedCapacitor.asc

C1: cap; 1e-9
C2: cap; 1e-9
C3: cap; 1e-9
C4: cap; 1e-9
C5: cap; 1e-9
D1: diode
D2: diode
D3: diode
D4: diode
D5: diode
S1: sw; switchshort
V1: voltage; PULSE(0 15000 0 0 0 3.125e-5 6.25e-5 30)
V2: voltage; PULSE(0 10 0.0015625 0 0 1e-3 2e-3 2)
Named nets: 0
.tran 2e-3
.plot V(C1)
