harrypatrick442/hvps/LTSpice/DriverSnubberModelling1/DriverSnubberModelling1.asc

C6: cap; 8.8108E-5
D6: diode
Lp: ind2; 5.0625E-5
M1: nmos; BSC060N10NS3
R1: res; 127
V1: voltage; 36
V5: voltage; PULSE(0 15 0 0 0 0.00003125 0.0000625 40)
Named nets: 0
.tran 0 0.000625 0 6.25e-7
.plot V(C1)
.model M1 NMOS (Vto=2.5V)
