harrypatrick442/hvps/LTSpice/RegenerativeSnubberModelling/RegenerativeSnubbe.asc

C_s: cap; 3.3E-6
L_m: ind; 0.000049 IC=-22
R2: res; 1000000000
V3: voltage; 36
Named nets: 0
.tran 0 0.0000625 0 6.25e-8
