harrypatrick442/hvps/LTSpice/VillardCascadingModel1/VillardCascadingModel1.asc

C1: cap; 1e-9
C2: cap; 1e-9
C3: cap; 1e-9
C4: cap; 1e-9
C5: cap; 1e-9
D1: diode
D2: diode
D3: diode
D4: diode
D5: diode
Lp: ind2; 5.0625E-5
Ls: ind2; 8.78906
S2: sw; switchshort
V1: voltage; PULSE(-18 18 0 0 0 3.125e-5 6.25e-5 30)
V3: voltage; PULSE(0 10 0 0 0 0.00003125 0.0000625 40)
Named nets: 0
.tran 2e-3
.plot V(C1)
K1 Lp Ls 1
