harrypatrick442/hvps/LTSpice/VillardCascadingModel2/VillardCascadingModel2.asc

C1: cap; 1e-9
C2: cap; 1e-9
C3: cap; 1e-9
C4: cap; 1e-9
C5: cap; 1e-9
C6: cap; 8.8108E-5
C7: cap; 8.8108E-5
D1: diode
D2: diode
D3: diode
D4: diode
D5: diode
D6: diode
D7: diode
Lp2: ind2; 5.0625E-5
Lp: ind2; 5.0625E-5
Ls: ind2; 4.39453
M1: nmos; BSC060N10NS3
M2: nmos; BSC060N10NS3
R1: res; 127
R2: res; 127
V1: voltage; 36
V2: voltage; PULSE(15 0 0.00003125 0 0 0.000015625 0.0000625 40)
V5: voltage; PULSE(15 0 0 0 0 0.000015625 0.0000625 40)
Named nets: 0
.tran 0 0.0025 0 6.25e-7
.plot V(C1)
K1 Lp Lp2 Ls 1
.model M1 NMOS (Vto=2.5V)
.model M2 NMOS (Vto=2.5V)
