harrypatrick442/hvps/Kicad/Check_HVPSController2/HVPSController2.kicad_pcb

## KiCad design Kicad/Check_HVPSController2/HVPSController2.kicad_pcb (2026-02-26)

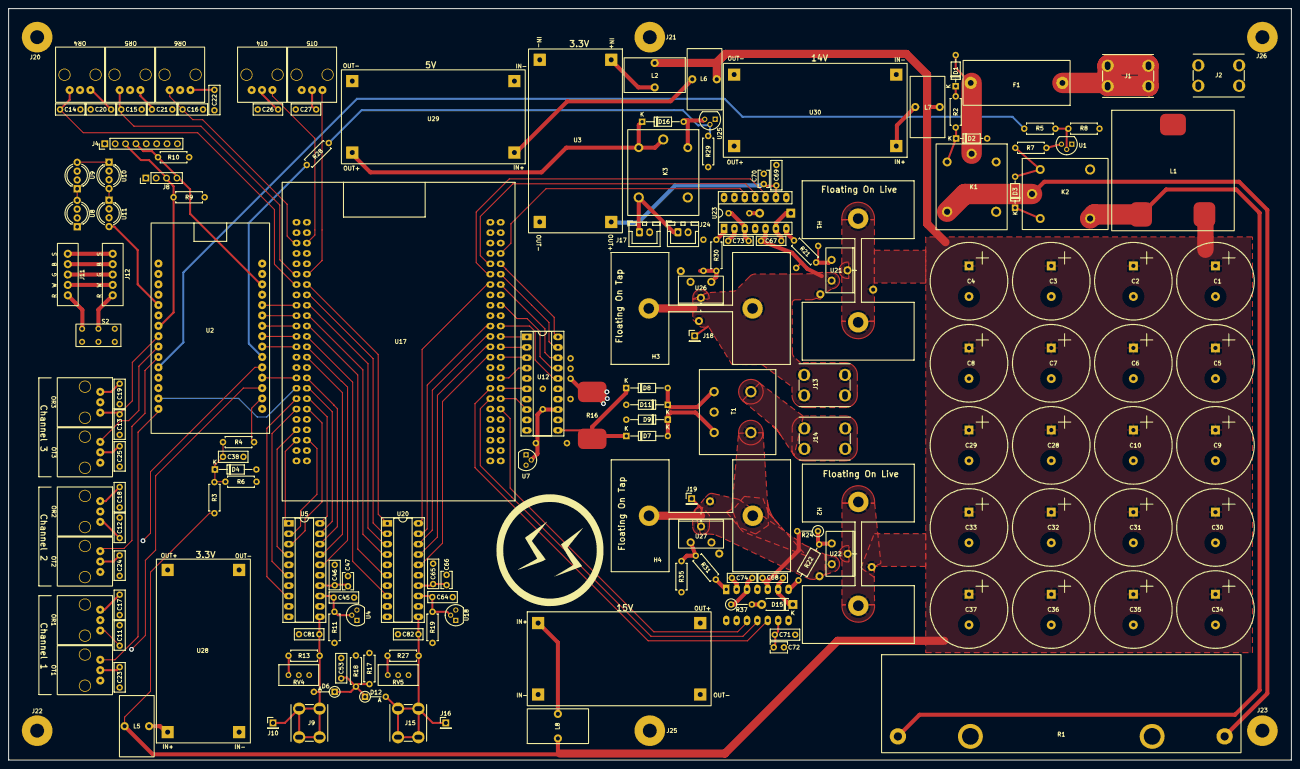
[picture p62: board HVPSController2.kicad_pcb from above]

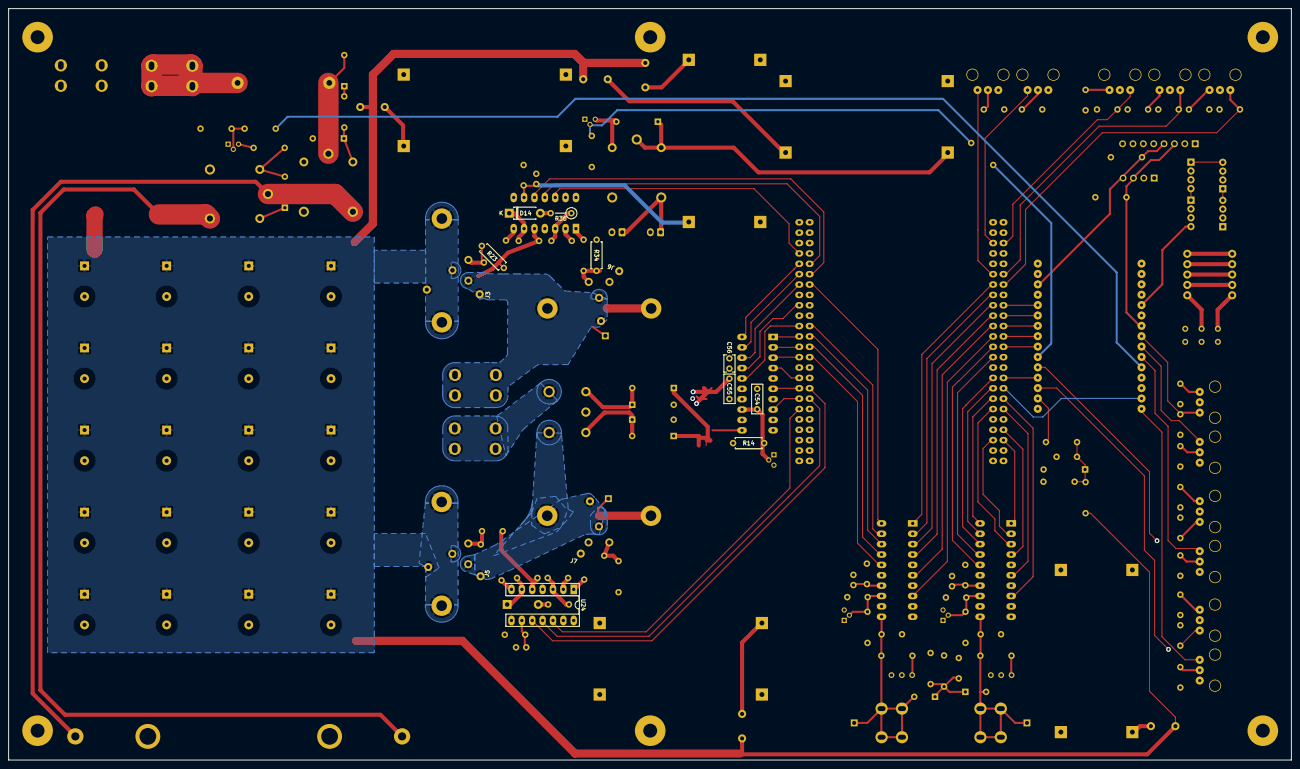
[picture p63: board HVPSController2.kicad_pcb from below]

Board: 4 copper layers, 314.1 x 184.0 mm, 181 parts (13 on the bottom side), 124 nets.

Parts:
C1, C2, C3, C4, C5, C6, C7, C8, C9, C10, C28, C29, C30, C31, C32, C33, C34, C35, C36, C37: EKYB101ELL102MM40S
C11, C12, C13, C14, C15, C16, C17, C18, C19, C20, C21, C22, C23, C24, C25, C26, C27: C_Rect_L7.0mm_W2.5mm_P5.00mm
C38: 4.7uF; C_Rect_L7.0mm_W2.5mm_P5.00mm
C45, C46, C54, C55, C64, C65, C69, C71, C81, C82: 0.1uF; C_Rect_L7.0mm_W2.5mm_P5.00mm
C47, C56, C66, C70, C72: 10uF; C_Rect_L4.0mm_W2.5mm_P2.50mm
C53: C; C_Rect_L7.0mm_W2.5mm_P5.00mm
C67: 1uF FG26X7R2A105KNT06; C_Rect_L7.0mm_W2.0mm_P5.00mm
C68: FG26X7R2A105KNT06; C_Rect_L7.0mm_W2.0mm_P5.00mm
C73, C74: 1uF; C_Rect_L7.0mm_W2.0mm_P5.00mm
D1, D2, D3: 1N4148; D_DO-35_SOD27_P7.62mm_Horizontal
D4: BZX55C3V0-TR; D_DO-35_SOD27_P10.16mm_Horizontal
D6, D12: 1N4149; D_DO-35_SOD27_P5.08mm_Vertical_AnodeUp
D7, D8, D9, D11: 1N4149; D_DO-35_SOD27_P10.16mm_Horizontal
D14: MUR220RLG; D_DO-41_SOD81_P7.62mm_Horizontal
D15: MUR420 R0; D_DO-41_SOD81_P7.62mm_Horizontal
D16: 1N4148; D_DO-35_SOD27_P10.16mm_Horizontal
F1: FH-320-NV
H1, H2, H3, H4: Heatsink; 647-25ABEP
J1: Vsupply; PCB-3 (M4)
J2: GND; PCB-3 (M4)
J3, J5, J6, J7: Snubber; Snubber_Connection_1
J4: Conn_01x08_Pin; PinHeader_1x08_P2.54mm_Vertical
J8: SCL, SDA, +, GND; PinHeader_1x04_P2.54mm_Vertical
J9, J15: Tap; PCB-1 (M4)
J10, J16: Tap debug pin; PinHeader_1x01_P2.54mm_Vertical
J11, J12: USB RWGBS; USB connection
J13, J14: Conn_01x01_Pin; PCB-3 (M4)
J17, J24: Conn_01x02_Pin; JST_XH_B2B-XH-A_1x02_P2.50mm_Vertical
J18, J19: PinHeader_1x01_P2.54mm_Vertical
J20, J21, J22, J23, J25, J26: Standoff Hole; ContactViaM3
K1, K2: AWHSH124D00G
K3: SRD-5VDC-SL-C
L1: SER2918H-223KL
L2, L5, L6, L7, L8: 5026 Inductor
OR1, OR2, OR3, OR4, OR5, OR6: RS PRO Optical Receiver jack
OT1, OT2, OT3, OT4, OT5: RS Pro Optical Transmitter jack
R1: RX24-100W
R2, R7: 1.33K; R_Axial_DIN0207_L6.3mm_D2.5mm_P7.62mm_Horizontal
R3: 33k; R_Axial_DIN0207_L6.3mm_D2.5mm_P7.62mm_Horizontal
R4, R5, R11, R14, R19, R28: 1K; R_Axial_DIN0207_L6.3mm_D2.5mm_P7.62mm_Horizontal
R6: 2k; R_Axial_DIN0207_L6.3mm_D2.5mm_P7.62mm_Horizontal
R8, R29: 10K; R_Axial_DIN0207_L6.3mm_D2.5mm_P7.62mm_Horizontal
R9, R10: Pullup; R_Axial_DIN0207_L6.3mm_D2.5mm_P7.62mm_Horizontal
R13: 120K; R_Axial_DIN0207_L6.3mm_D2.5mm_P7.62mm_Horizontal
R16: 10; SL2TTED10R0F
R17: 50; R_Axial_DIN0207_L6.3mm_D2.5mm_P7.62mm_Horizontal
R18: 100; R_Axial_DIN0207_L6.3mm_D2.5mm_P7.62mm_Horizontal
R21, R30, R31: 4.7; R_Axial_DIN0207_L6.3mm_D2.5mm_P7.62mm_Horizontal
R22: 4.7; R_Axial_DIN0207_L6.3mm_D2.5mm_P10.16mm_Horizontal
R23, R34, R35: 1000; R_Axial_DIN0207_L6.3mm_D2.5mm_P7.62mm_Horizontal
R24: 1000; R_Axial_DIN0207_L6.3mm_D2.5mm_P5.08mm_Vertical
R27: 22K; R_Axial_DIN0207_L6.3mm_D2.5mm_P7.62mm_Horizontal
R36, R37: 4.7; R_Axial_DIN0207_L6.3mm_D2.5mm_P5.08mm_Vertical
RV4: 10K (adjust to 5K); Potentiometer_Bourns_3296W_Vertical
RV5: 5K (adjusted to 1.38 for 23.8K total; Potentiometer_Bourns_3296W_Vertical
S2: MSS-04A
T1: CST2020-200L
U1, U4, U7, U18, U25: TO-92
U2: ESP32_WROOM-32_Dev_Board
U3, U28, U29, U30, U31: HW-677 LM2596HVS DC-DC
U5, U12, U20: DIP-20_W7.62mm_Socket_LongPads
U8, U9, U10, U11: LED_D5.0mm-4_RGB_Wide_Pins
U17: EP4CE6E22C8N_FPGA_Development_Board_
U21, U22, U26, U27: IXFP60N25X3_2
U23, U24: DIP-14_W7.62mm_Socket_LongPads

Connections:
+3V3: C17.1, C18.1, C19.1, C23.1, C24.1, C25.1, C46.1, C47.1, C65.1, C66.1, C71.1, C72.1, OR1.3 (Vcc), OR2.3 (Vcc), OR3.3 (Vcc), OT1.2 (Vcc), OT2.2 (Vcc), OT3.2 (Vcc), R11.1, R17.1, R19.1, S2.5, U5.14 (VDD), U20.14 (VDD), U24.9 (VDD), U28.4 (OUT+)
+5V: D16.1 (K), K3.2, K3.3, U8.2 (VDD), U9.2 (VDD), U10.2 (VDD), U11.2 (VDD), U17.1 (5V), U17.2 (5V), U29.4 (OUT+)
+15V: C73.2, R36.1, U23.3 (VCC), U30.4 (OUT+)
+36V: C1.1, C2.1, C3.1, C4.1, C5.1, C6.1, C7.1, C8.1, C9.1, C10.1, C28.1, C29.1, C30.1, C31.1, C32.1, C33.1, C34.1, C35.1, C36.1, C37.1, H1.1, H2.1, J3.2, J5.2, L1.2, L2.1, L5.1, L6.1, L7.1, L8.1, R3.1, U21.2 (D), U22.2 (D)
/3v3_2: C20.1, C21.1, C22.1, C26.1, C27.1, C55.1, C56.1, C69.1, C70.1, J4.1, J8.2, OR4.3 (Vcc), OR5.3 (Vcc), OR6.3 (Vcc), OT4.2 (Vcc), OT5.2 (Vcc), R9.1, R10.1, R14.1, U3.4 (OUT+), U12.14 (VDD), U23.9 (VDD)
/15V_2: C74.2, R37.1, U24.3 (VCC), U31.4 (OUT+)
Earth: C1.2, C2.2, C3.2, C4.2, C5.2, C6.2, C7.2, C8.2, C9.2, C10.2, C11.2, C12.2, C13.2, C14.2, C15.2, C16.2, C17.2, C18.2, C19.2, C20.2, C21.2, C22.2, C23.2, C24.2, C25.2, C26.2, C27.2, C28.2, C29.2, C30.2, C31.2, C32.2, C33.2, C34.2, C35.2, C36.2, C37.2, C38.2, C45.2, C46.2, C47.2, C53.2, C54.2, C55.2, C56.2, C64.2, C65.2, C66.2, C69.2, C70.2, C71.2, C72.2, C73.1, C74.1, C81.2, C82.2, D2.2 (A), D4.2 (A), D9.2 (A), D11.2 (A), J2.1, J4.2, J6.1, J7.1, J8.1, J17.2, J20.1, J21.1, J22.1, J23.1, J24.2, J25.1, J26.1, K1.1, OR1.2 (GND), OR2.2 (GND), OR3.2 (GND), OR4.2 (GND), OR5.2 (GND), OR6.2 (GND), OT1.1 (GND), OT2.1 (GND), OT3.1 (GND), OT4.1 (GND), OT5.1 (GND), R6.2, R8.2, R16.2, R18.2, R29.2, R34.2, R35.2, RV4.2, RV5.2, U1.1 (S), U2.14 (GND), U2.17 (GND), U3.2 (IN-), U3.3 (OUT-), U4.3 (Anode), U5.5 (!CS), U5.7 (DGND), U5.9 (!PD), U5.15 (AGND), U7.3 (Anode), U8.3 (GND), U9.3 (GND), U10.3 (GND), U11.3 (GND), U12.5 (!CS), U12.7 (DGND), U12.9 (!PD), U12.15 (AGND), U17.3 (GND), U17.4 (GND), U17.47 (GND), U17.48 (GND), U17.51 (GND), U17.52 (GND), U17.95 (GND), U17.96 (GND), U18.3 (Anode), U20.5 (!CS), U20.7 (DGND), U20.9 (!PD), U20.15 (AGND), U23.2 (COM), U23.13 (VSS), U24.2 (COM), U24.13 (VSS), U25.1 (S), U26.3 (S), U27.3 (S), U28.2 (IN-), U28.3 (OUT-), U29.2 (IN-), U29.3 (OUT-), U30.2 (IN-), U30.3 (OUT-), U31.2 (IN-), U31.3 (OUT-)
unnamed: D1.2 (A), F1.2, K1.2
unnamed: D1.1 (K), R2.1
unnamed: D2.1 (K), K1.3, R2.2
unnamed: D3.2 (A), K2.1, R7.1
unnamed: D3.1 (K), K1.4, K2.2, K2.3, R1.2
unnamed: C38.1, D4.1 (K), R3.2, R4.2, R6.1
unnamed: C81.1, D6.2 (A), J9.1, J10.1, R13.1, U5.11 (VIN1)
unnamed: D7.2 (A), D9.1 (K), T1.1
unnamed: D7.1 (K), D8.1 (K), R16.1, U12.11 (VIN1)
unnamed: D8.2 (A), D11.1 (K), T1.3
unnamed: C82.1, D12.2 (A), J15.1, J16.1, R27.1, U20.11 (VIN1)
unnamed: C53.1, D6.1 (K), D12.1 (K), R17.2, R18.1
unnamed: D14.2 (A), R36.2
unnamed: C67.2, D14.1 (K), U23.6 (VB)
unnamed: D15.2 (A), R37.2
unnamed: C68.2, D15.1 (K), U24.6 (VB)
unnamed: D16.2 (A), K3.1, U25.3 (D)
unnamed: C67.1, H3.1, J3.1, J6.2, J13.1, J18.1, R23.2, U21.3 (S), U23.5 (VS), U26.2 (D)
unnamed: C68.1, H4.1, J5.1, J7.2, J19.1, R24.2, T1.5, U22.3 (S), U24.5 (VS), U27.2 (D)
unnamed: F1.1, J1.1
unnamed: J4.3, J8.3, R9.2, U2.22 (TX2_io)
unnamed: J4.4, J8.4, R10.2, U2.13 (D13_a2io)
unnamed: J11.1, S2.1
unnamed: J11.2, J12.2
unnamed: J11.3, J12.3
unnamed: J11.4, J12.4
unnamed: J11.5, J12.5
unnamed: J12.1, S2.2
unnamed: J14.1, T1.4
unnamed: J17.1, J24.1, K3.4
unnamed: K2.4, L1.1, R1.1
unnamed: C11.1, OR1.1 (Vout), U2.3 (VN_a1i)
unnamed: C12.1, OR2.1 (Vout), U2.5 (D35_a1i)
unnamed: C13.1, OR3.1 (Vout), U2.23 (D5_a2io)
unnamed: C14.1, OR4.1 (Vout), U17.13 (43)
unnamed: C15.1, OR5.1 (Vout), U17.11 (39)
unnamed: C16.1, OR6.1 (Vout), U17.5 (30)
unnamed: OT1.3 (Vin), U2.30 (D23_io)
unnamed: OT2.3 (Vin), U2.25 (D19_io)
unnamed: OT3.3 (Vin), U2.24 (D18_io)
unnamed: OT4.3 (Vin), U17.6 (28)
unnamed: OT5.3 (Vin), U17.12 (38)
unnamed: R13.2, RV4.1
unnamed: R27.2, RV5.1
unnamed: R7.2, U1.3 (D)
unnamed: R5.2, R8.1, U1.2 (G)
unnamed: S2.6, U2.16 (3V3)
unnamed: R5.1, U2.26 (D21_io)
unnamed: R28.1, U2.6 (D32_a1io)
unnamed: R4.1, U2.2 (VP_a1i)
unnamed: L2.2, U3.1 (IN+)
unnamed: C45.1, R11.2, U4.2 (Cathode), U5.13 (VREF_IN/OUT)
unnamed: U8.4 (DIN), U9.1 (DOUT)
unnamed: U10.4 (DIN), U11.1 (DOUT)
unnamed: U9.4 (DIN), U10.1 (DOUT)
unnamed: U2.20 (D4_a2io), U11.4 (DIN)
unnamed: U12.4 (!CONVST), U17.80 (113)
unnamed: U12.8 (!EOC), U17.84 (106)
unnamed: U12.6 (!RD), U17.82 (111)
unnamed: U12.3 (DB0), U17.76 (120)
unnamed: U12.2 (DB1), U17.74 (124)
unnamed: U12.1 (DB2), U17.72 (126)
unnamed: U12.20 (DB3), U17.58 (1)
unnamed: U12.19 (DB4), U17.60 (143)
unnamed: U12.18 (DB5), U17.62 (141)
unnamed: U12.17 (DB6), U17.66 (135)
unnamed: U12.16 (DB7), U17.70 (128)
unnamed: C54.1, R14.2, U7.2 (Cathode), U12.13 (VREF_IN/OUT)
unnamed: U17.57 (2), U23.11 (SD)
unnamed: U17.56 (3), U23.12 (LIN)
unnamed: U17.14 (42), U20.1 (DB2)
unnamed: U17.16 (44), U20.2 (DB1)
unnamed: U17.18 (49), U20.3 (DB0)
unnamed: U2.11 (D14_a2io), U17.17 (50)
unnamed: U17.20 (51), U20.4 (!CONVST)
unnamed: U2.10 (D27_a2io), U17.19 (52)
unnamed: U17.22 (53), U20.6 (!RD)
unnamed: U2.9 (D26_a2io), U17.21 (54)
unnamed: U17.24 (55), U20.8 (!EOC)
unnamed: U2.8 (D25_a2io), U17.23 (58)
unnamed: U5.16 (DB7), U17.26 (59)
unnamed: U2.7 (D33_a1io), U17.25 (60)
unnamed: U5.17 (DB6), U17.28 (64)
unnamed: U5.18 (DB5), U17.32 (68)
unnamed: U2.4 (D34_a1i), U17.31 (69)
unnamed: U5.19 (DB4), U17.34 (70)
unnamed: U2.29 (D22_io), U17.33 (71)
unnamed: U5.20 (DB3), U17.36 (72)
unnamed: U5.8 (!EOC), U17.35 (73)
unnamed: U5.3 (DB0), U17.38 (74)
unnamed: U5.6 (!RD), U17.37 (75)
unnamed: U5.4 (!CONVST), U17.41 (83)
unnamed: U5.2 (DB1), U17.44 (84)
unnamed: U5.1 (DB2), U17.43 (85)
unnamed: U17.86 (104), U24.12 (LIN)
unnamed: U17.83 (110), U24.11 (SD)
unnamed: U17.81 (112), U24.10 (HIN)
unnamed: U17.75 (121), U20.16 (DB7)
unnamed: U17.73 (125), U20.17 (DB6)
unnamed: U17.71 (127), U20.18 (DB5)
unnamed: U17.69 (129), U20.19 (DB4)
unnamed: U17.61 (142), U20.20 (DB3)
unnamed: U17.59 (144), U23.10 (HIN)
unnamed: C64.1, R19.2, U18.2 (Cathode), U20.13 (VREF_IN/OUT)
unnamed: R21.2, R23.1, U21.1 (G)
unnamed: R22.2, R24.1, U22.1 (G)
unnamed: R21.1, U23.7 (HO)
unnamed: R30.1, U23.1 (LO)
unnamed: R22.1, U24.7 (HO)
unnamed: R31.1, U24.1 (LO)
unnamed: R28.2, R29.1, U25.2 (G)
unnamed: R30.2, R34.1, U26.1 (G)
unnamed: R31.2, R35.1, U27.1 (G)
unnamed: L5.2, U28.1 (IN+)
unnamed: L6.2, U29.1 (IN+)
unnamed: L7.2, U30.1 (IN+)
unnamed: L8.2, U31.1 (IN+)
