harrypatrick442/hvps/Kicad/VillardCascadingVoltageMultiplierSubcircuit/VillardCascadingVoltageMultiplierSubcircuit.kicad_pcb

## KiCad design Kicad/VillardCascadingVoltageMultiplierSubcircuit/VillardCascadingVoltageMultiplierSubcircuit.kicad_pcb (2025-09-17)

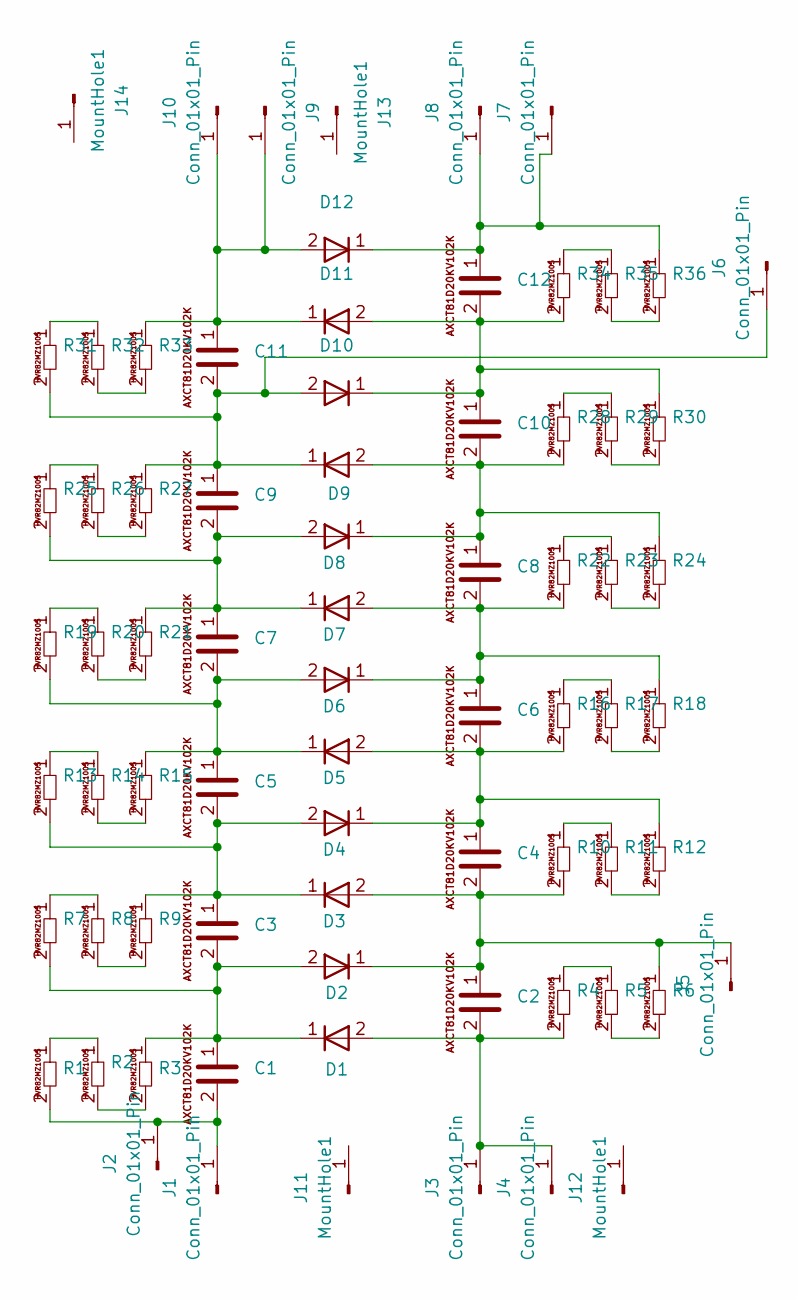
[picture p64: schematic VillardCascadingVoltageMultiplierSubcircuit.kicad_sch]

Parts:
C1, C2, C3, C4, C5, C6, C7, C8, C9, C10, C11, C12: AXCT81D20KV102K
D1, D2, D3, D4, D5, D6, D7, D8, D9, D10, D11, D12: 2CL2FR_JB289_MT100F35
J1, J2, J3, J4, J5, J6, J7, J8, J9, J10: Conn_01x01_Pin; VersatilePad
J11, J12, J13, J14: MountHole1; M3Hole
R1, R2, R3, R4, R5, R6, R7, R8, R9, R10, R11, R12, R13, R14, R15, R16, R17, R18, R19, R20, R21, R22, R23, R24, R25, R26, R27, R28, R29, R30, R31, R32, R33, R34, R35, R36: HVR82MZ1005

Connections:
unnamed: C1.1, C3.2, D1.1, D2.2, R3.1, R7.2
unnamed: C3.1, C5.2, D3.1, D4.2, R9.1, R13.2
unnamed: C4.1, C6.2, D4.1, D5.2, R12.1, R16.2
unnamed: C5.1, C7.2, D5.1, D6.2, R15.1, R19.2
unnamed: C6.1, C8.2, D6.1, D7.2, R18.1, R22.2
unnamed: C7.1, C9.2, D7.1, D8.2, R21.1, R25.2
unnamed: C10.1, C12.2, D10.1, D11.2, R30.1, R34.2
unnamed: C8.1, C10.2, D8.1, D9.2, R24.1, R28.2
unnamed: C1.2, J1.1, J2.1, R1.2
unnamed: C2.2, D1.2, J3.1, J4.1, R4.2
unnamed: C2.1, C4.2, D2.1, D3.2, J5.1, R6.1, R10.2
unnamed: C9.1, C11.2, D9.1, D10.2, J6.1, R27.1, R31.2
unnamed: C12.1, D12.1, J7.1, J8.1, R36.1
unnamed: C11.1, D11.1, D12.2, J9.1, J10.1, R33.1
unnamed: R1.1, R2.1
unnamed: R2.2, R3.2
unnamed: R4.1, R5.1
unnamed: R5.2, R6.2
unnamed: R7.1, R8.1
unnamed: R8.2, R9.2
unnamed: R10.1, R11.1
unnamed: R11.2, R12.2
unnamed: R13.1, R14.1
unnamed: R14.2, R15.2
unnamed: R16.1, R17.1
unnamed: R17.2, R18.2
unnamed: R19.1, R20.1
unnamed: R20.2, R21.2
unnamed: R22.1, R23.1
unnamed: R23.2, R24.2
unnamed: R25.1, R26.1
unnamed: R26.2, R27.2
unnamed: R28.1, R29.1
unnamed: R29.2, R30.2
unnamed: R31.1, R32.1
unnamed: R32.2, R33.2
unnamed: R34.1, R35.1
unnamed: R35.2, R36.2

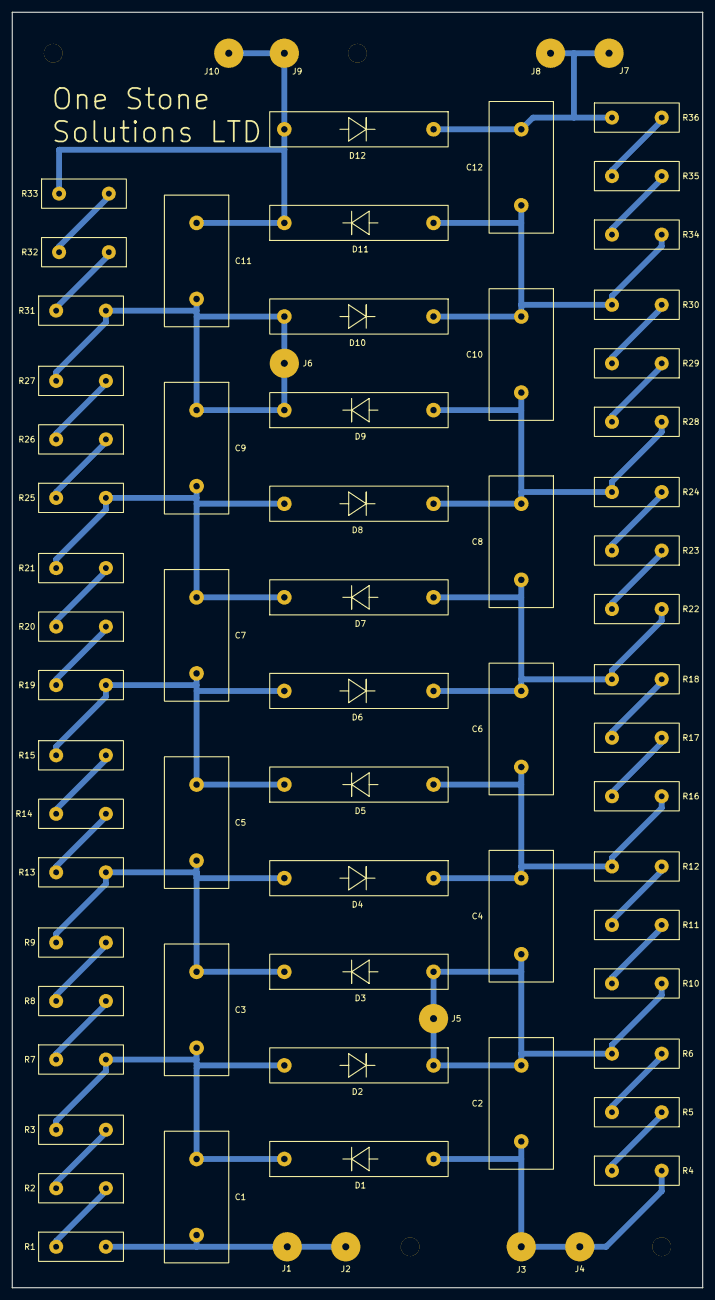
[picture p65: board VillardCascadingVoltageMultiplierSubcircuit.kicad_pcb from above]

Board: 2 copper layers, 118.0 x 218.0 mm, 74 parts (0 on the bottom side), 38 nets.
