harrypatrick442/hvps/Kicad/CurrentVoltageFeedbackModule/CurrentVoltageFeedbackModule.kicad_pcb

## KiCad design Kicad/CurrentVoltageFeedbackModule/CurrentVoltageFeedbackModule.kicad_pcb (2025-09-17)

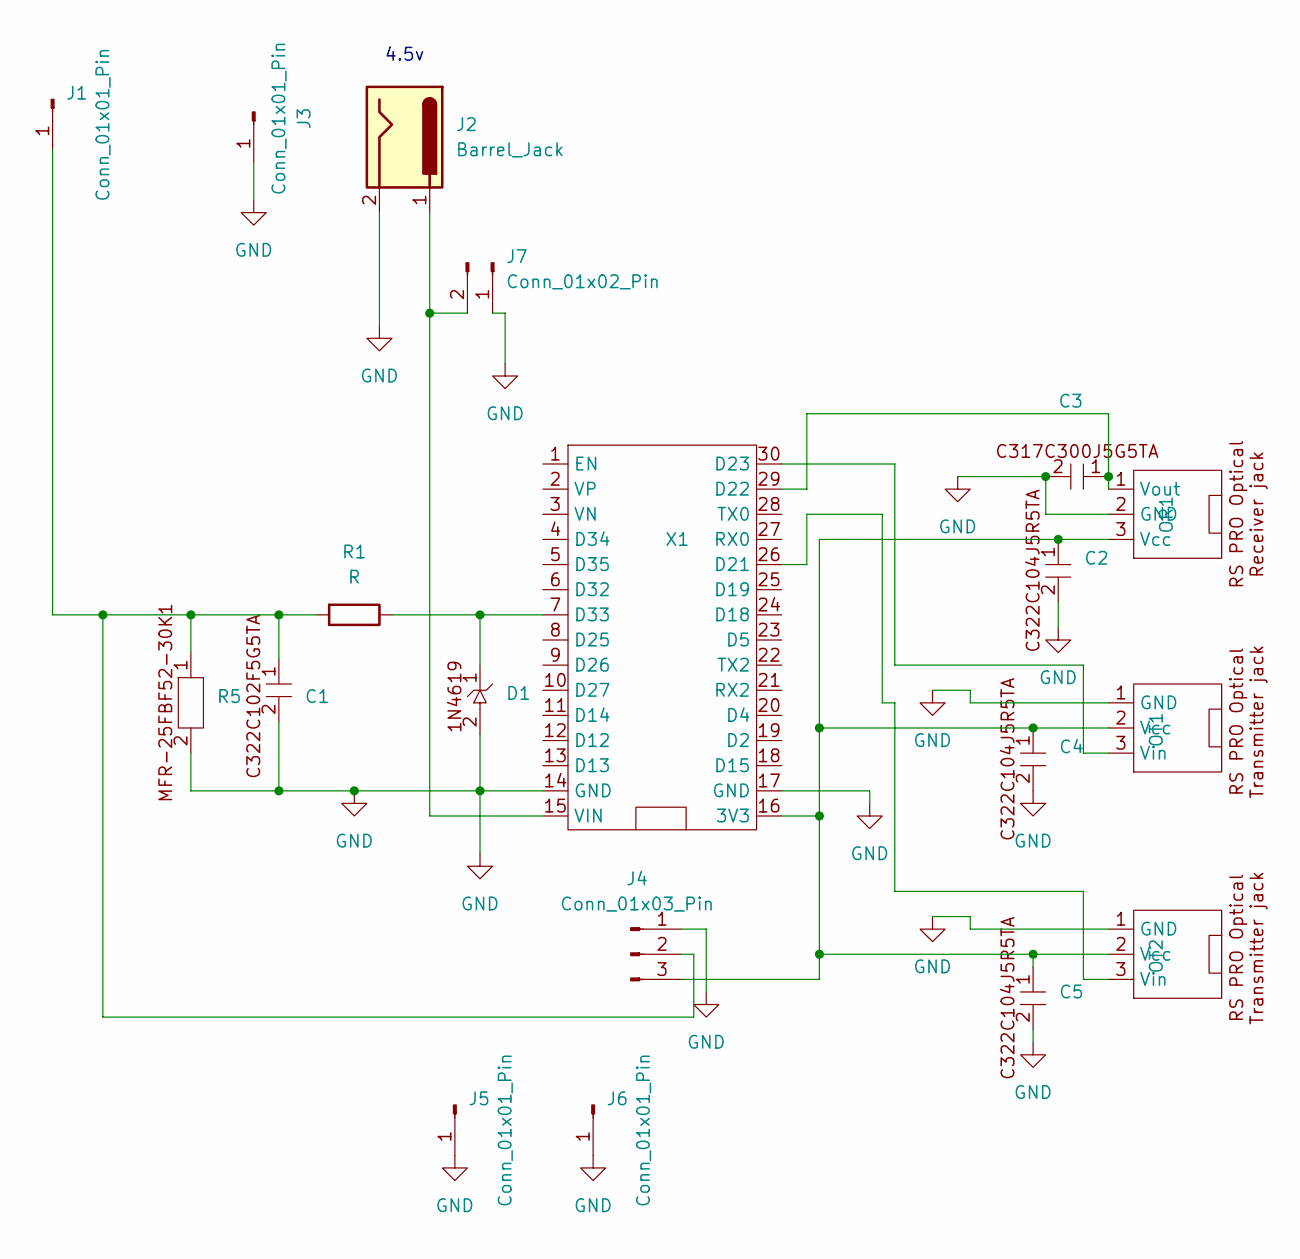
[picture p66: schematic CurrentVoltageFeedbackModule.kicad_sch]

Parts:
C1, C2, C3, C4, C5: C_Rect_L7.0mm_W2.5mm_P5.00mm
D1: D_DO-35_SOD27_P7.62mm_Horizontal
J1, J3: Conn_01x01_Pin; VersatilePad
J2: Barrel_Jack; BarrelJack_Horizontal
J4: Conn_01x03_Pin; PinHeader_1x03_P2.54mm_Vertical
J5, J6: Conn_01x01_Pin; ContactViaM2_5
J7: Conn_01x02_Pin; PinHeader_1x02_P2.54mm_Vertical
OR1: RS PRO Optical Receiver jack
OT1, OT2: RS Pro Optical Transmitter jack
R1: R; R_Axial_DIN0207_L6.3mm_D2.5mm_P5.08mm_Vertical
R5: R_Axial_DIN0207_L6.3mm_D2.5mm_P10.16mm_Horizontal
X1: ESP32_WROOM-32_Dev_Board

Connections:
GND: C1.2, C2.2, C3.2, C4.2, C5.2, D1.2, J2.2, J3.1, J4.1, J5.1, J6.1, J7.1, OR1.2 (GND), OT1.1 (GND), OT2.1 (GND), R5.2, X1.14 (GND), X1.17 (GND)
unnamed: C1.1, J1.1, J4.2, R1.2, R5.1
unnamed: C2.1, C4.1, C5.1, J4.3, OR1.3 (Vcc), OT1.2 (Vcc), OT2.2 (Vcc), X1.16 (3V3)
unnamed: J2.1, J7.2, X1.15 (VIN)
unnamed: C3.1, OR1.1 (Vout), X1.29 (D22)
unnamed: OT1.3 (Vin), X1.30 (D23)
unnamed: OT2.3 (Vin), X1.26 (D21)
unnamed: D1.1, R1.1, X1.7 (D33)

Notes on the sheet:
4.5v

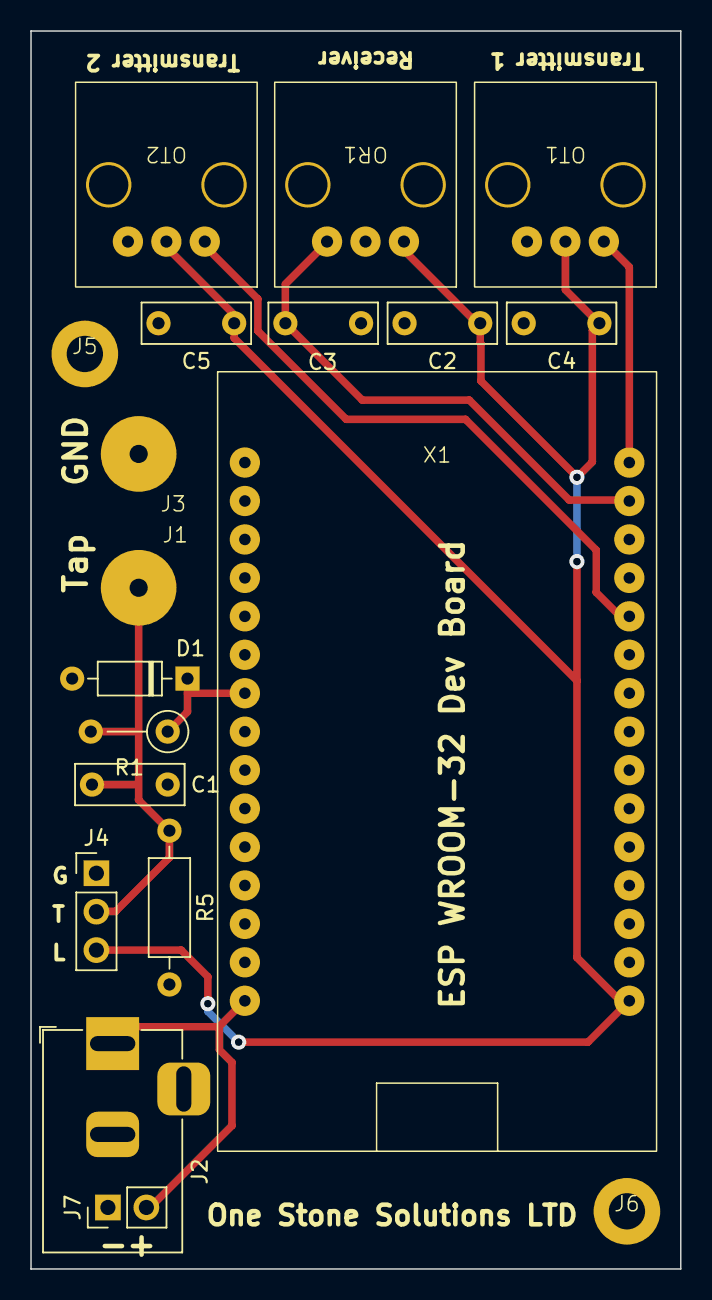
[picture p67: board CurrentVoltageFeedbackModule.kicad_pcb from above]

Board: 2 copper layers, 42.9 x 81.8 mm, 19 parts (0 on the bottom side), 8 nets.
