harrypatrick442/hvps/Code/C++/VoltageFeedbackModuleBase/ThresholdMonitor.cpp

#include "ThresholdMonitor.hpp"
#include "IO/Outputs.hpp"
#include "ADC/ADC.hpp"
#include "Timing/Delay.hpp"
#include "Tasks/TaskFactory.hpp"
#include "Storage/Flash.hpp"
#include "System/SafeAbort.hpp"
#include "Logging/Log.hpp"
#include <functional>
#include "Macros/GetFileName.hpp"
const char* ThresholdMonitor::getTag() {return GET_FILE_NAME;}
const char* ThresholdMonitor::SET_TAP_VOLTAGE_THRESHOLD_ERROR_MESSAGE = "Tap threshold voltage calculation error";
ThresholdMonitor::ThresholdMonitor(
	adc_channel_t ch, 
	const VoltageFeedbackModuleConfiguration& config1, const VoltageFeedbackModuleConfiguration& config2
):
_config1(config1),
_config2(config2),
_monitorVoltageThresholdHandle(nullptr),
_forceReached(std::nullopt),
_actualReached(false)
{
	float initialUnscaledVoltageThreshold = _config1.defaultThreshold;
	Flash::getFloat(FLASH_NAMESPACE, THRESHOLD_VOLTAGE_KEY, initialUnscaledVoltageThreshold);
	float tapThresholdVoltage, tapThresholdVoltageCopy;
	toScaledADCThreshold(initialUnscaledVoltageThreshold, tapThresholdVoltage, tapThresholdVoltageCopy);
	_monitorVoltageThresholdHandle = 
		ADC::monitorVoltageThresholdWithNewPriorityTask(
			ch,
			tapThresholdVoltage,
			[this](bool reached) { onVoltageThresholdReachedChanged(reached); }
		);
	if(tapThresholdVoltage!=tapThresholdVoltageCopy){
		SAFE_ABORT(SET_TAP_VOLTAGE_THRESHOLD_ERROR_MESSAGE);
		return;
	}
}
float ThresholdMonitor::getVoltage(uint16_t& raw){
	float voltage =  fromScaledADCToActual(_monitorVoltageThresholdHandle->getVoltage(raw));
	return voltage;
}
void ThresholdMonitor::setThresholdVoltage(float voltage){
	float tapThresholdVoltage, tapThresholdVoltageCopy;
	toScaledADCThreshold(voltage, tapThresholdVoltage, tapThresholdVoltageCopy);
	_monitorVoltageThresholdHandle->setThresholdVoltage(tapThresholdVoltage);
	if(tapThresholdVoltage!=tapThresholdVoltageCopy){
		SAFE_ABORT(SET_TAP_VOLTAGE_THRESHOLD_ERROR_MESSAGE);
		return;
	}
	Flash::setFloat(FLASH_NAMESPACE, THRESHOLD_VOLTAGE_KEY, voltage);
}
void ThresholdMonitor::setForce(std::optional<bool> forceReached) noexcept{
	
	_lock.lock();
	_forceReached = forceReached;
	if(!forceReached.has_value()){
		bool actualReached = _actualReached;
		Outputs::setThresholdReached(actualReached);
		_lock.unlock();
		return;
	}
	bool value = forceReached.value();
	Outputs::setThresholdReached(value);
	_lock.unlock();
}
void ThresholdMonitor::onVoltageThresholdReachedChanged(bool actualReached)noexcept{
	
	_lock.lock();
	_actualReached = actualReached;
	std::optional<bool> forceReached = _forceReached;
	if(!forceReached.has_value()){
		Outputs::setThresholdReached(actualReached);
		_lock.unlock();
		return;
	}
	bool value = forceReached.value();
	Outputs::setThresholdReached(value);
	_lock.unlock();
}
void ThresholdMonitor::toScaledADCThreshold(float vUnscaled, float& a, float& b)noexcept{
	a =  vUnscaled/_config1.vHvOverVadcRatio;
	b = vUnscaled / _config2.vHvOverVadcRatio;
	if(a!=b){
		SAFE_ABORT(SET_TAP_VOLTAGE_THRESHOLD_ERROR_MESSAGE);
	}
}
float ThresholdMonitor::fromScaledADCToActual(float adc){
	return adc * _config2.vHvOverVadcRatio;
}
