harrypatrick442/hvps/Code/C++/MRTExample/main/IO/FiberOpticDuplexChannel_1.hpp

#ifndef FiberOpticDuplexChannel_1_hpp
#define FiberOpticDuplexChannel_1_hpp
#include "Communication/FiberOptic/TOSLINKDuplexChannel.hpp"
class FiberOpticDuplexChannel_1: public TOSLINKDuplexChannel{
	public:
        FiberOpticDuplexChannel_1();
};
#endif // FiberOpticDuplexChannel_1_hpp
