harrypatrick442/hvps/(commit log)

2025-09-17 Initial commit
    High voltage power supply I have been engineering for some experiments related to a high energy plasma anomaly I observed as a teenager which I speculate was basically small scale ball-lightning. This project was previously part of a larger hierarchy of projects but I have separated it out from that. Some subsystems are currently not in here including a cross platform JavaScript UI
    [A.3mf, A.skp, A.stl, Assembly.skp, B.3mf, B.skp, B.stl, BasicCalculations.xlsx]
2025-09-18 Reorganising is going nicely.
    [CheckingCurrentDensity.obj, CheckingCurrentDensity.skp, FlybackTransformer.obj, FlybackTransformer.skp, FlybackTransformerUnexploded.skp, Primary.obj, Primary.skp, UsingPC40_UU120X160X20.obj]
2025-09-25 Now building again nicely.
    [BasicCalculations.xlsx, Parts.xlsx]
2025-10-01 Finally building :D. Now back to the voltage feedback module for the tweaks required.
2025-10-05 Getting there
    Major refactoring splitting into dependency components. Shared and VoltageFeedbackModuleBase :) OutputVoltageFeedbackModule, FirstStageFeedbackModule, HVPSController are top level projects.
    [BasicCalculations.xlsx]
2025-10-13 All now building. Had to tweak the design slightly to use
    Had to tweak the design to use twelve https://www.aliexpress.com/item/1005005011684166.html in series as the output current limiting resistor. This gives me superior value for money and limits the output current safely to under 0.089 amps on short circuit output with a safety factor over 1.2. This increased the number of stages i can fit in the affordable 0.5m tall acrylic vessel of mineral oil to 12 which results in twice the output voltage at 160kv. The driver circuit is able to drive a large range of stages with very few changes and doubling the output voltage gives me better bang for buck. The high energy output capacitor (other s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
    [Assembly.skp, BasicCalculations.xlsx]
2025-10-25 ProgrammingHelper
    Utility that has buttons to quickly spin up the console if not open and send commands for configuring building flashing monitoring. This automatically establishes the com port to avoid confusion by myself and potentially flashing the wrong code to the wrong device. Much quicker and cleaner.
    [Assembly.skp, DebugAndOtherPeripheralsBoard.kicad_pcb, DebugAndOtherPeripheralsBoard.kicad_sch]
2025-10-28 Sorting out simple little quick ui to run esp32 idf commands
    and sorted out flash methods for strings. These are going to required for buffering the last error message if an abort happens so it can be retrieved on reboot and passed to the UI.
2025-10-30 Implementing caching of error information for panic and abort and the like
    This will allow real time error feedback to the ui when the device is running incase of a panic or anything.
    [Connections.xlsx]
2025-11-02 panic logging seems to be working nicely and putting in place events on
    putting in place onOpen and onClosed events on IChannelEvents which is inherited by IChannel and a base class ChannelEvents makes easily available. These events must be dispatched in order from the point of view of the bluetooth stack but without blocking the bluetooth stack so i ended up creating TransientWorker which dispatches on the low priority core (the one we keep for non timing critical operations, the other controls the high speed switching in the circuit and stuff). And transientworker will guarantee the order of the events. The reason we require onOpen and onClosed in thise case (but many uses) is to start up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
2025-11-13 Now just to finish implementing the client side printing of the backtrace array from the LastAbortMessage.
2025-11-16 Two different approaches. shared_ptr and internal memory cleanup vs CleanupBucket
    are battling it out they just met logaheads at one point in my code and i think im going with CleanupBucket for a number of reasons for this. Primarily because the message wrapper objects are not really intended to be lingering around in code and passed about from thread to thread.
2025-11-20 Going extremely well.
    Been implementing error handling for abort and panic and stuff and thats all good now. And been modifying the HighSpeedCore to handle this appropriately. Thats all good from waht i can see. About to make a decision on OtherPeripherals for which the hardware has a Tr and Rs which can either be used for conventional uart style come or i2c coms.
    [HVPSController.cpp]
2025-11-24 Going wonderfully well
    Implemented programmable led related stuff and created Peripheral1 which is a peripheral subsystem talked to by the main controller board over fiber optics. At present this board only controls leds inside the device which act as state indicators and warnings. However it will soon include a fan too.
    [Peripheral1.kicad_pcb, Peripheral1.kicad_sch]
2025-11-26 UART now supports software UART so i can go beyond two.
2025-11-30 Going great
    I have sorted the issues with the bluetooth stack incoming event being delayed due to time consuming methods by implementing TransientWorker. And further shifted the running of system checks to a new dedicated thread. I have made additions to the HighSpeedCore and been testing running system checks. Improvements were made to error state handling. I removed void* style methods from the TaskFactory as I prefer the lambda versions which dont require messinga bout with static trampoline methods.
    [HVPSController.cpp, HardwareUART.cpp, HardwareUART.hpp]
2025-12-03 Going great!
    Software uart debugged, had some issues but for this particular case a low baud rate is more than fine. Coms from the main controller to the peripheral are not the problem. And those seem to work more reliably anyway. The only coms the other way at present is a handshake which comes from either direction depending which board starts first and that handshake is there to just initialize the state. Though technically it can safely show idle for that.
    [SoftwareUART.cpp, SoftwareUART.hpp]
2025-12-06 before i attempt to let gpt refactor it to use the new rmt api due to a conflict with an led library that
    also uses the new one. Might as well use it. I have already started it here but only with changes to includes.
2025-12-06 almost done switching to use the new api and be compatible with rmt led stuff.
2025-12-19 Switched most stuff to float as double precision not required.
2025-12-20 sorted new issue with UART and now been thinking about
    ways to shrink file size because we are running low on space for the program on HVPSController. I have a way and it massively reduces space taken by strings.
    [DAC.cpp, DAC.hpp, HardwareUART.cpp, Outputs.cpp, Outputs.hpp]
2025-12-21 in process of switching to SAFE_ABORT
2025-12-21 all my macro's are in place now
    So that when i want to i can write a custom precompiler stage and strip all unnecessary message string content from the compiled software.
2025-12-31 Almost done with emulation code and just sorted FrequencyMeter so its a reusable part
    [DummyLoadResistorsCase.3mf, DummyLoadResistorsCase.skp, DummyLoadResistorsCase.stl]
2026-01-02 Have the emulation working and gradually working through improvements and fixes
    and then onto the redundancy to handle any bitflips and the watchdog.
    [ADC.cpp, DAC.cpp]
2026-01-09 Still trying to find the root cause of an issue with second run onwards
    where the main controller thinks the threshold for output voltage is in the wrong state even after setting brute force reached for the test. Want to get this on here. This could go on for sometime.
    [ADC.cpp, ADC.hpp, ADCSession.hpp]
2026-01-17 Putting temperature sensing in place.
    [BasicCalculations.xlsx, DummyLoadResistorsCase.3mf, DummyLoadResistorsCase2.3mf, DummyLoadResistorsCase2.skp, DummyLoadResistorsCase2.stl, HVPSController.kicad_sch, LM75AClip.3mf, LM75AClip.skp]
2026-01-19 need a nice structured way to automatically hand out timers and groups for hardware interrupt timers.
    I stumbled upon a but related to this and discovered this as the cause. I had used the same hw timer in both my custom MRT library and as part of a watchdog system and it caused what appeared to be a lockup. But that was simply the MRT library stalling because the interrupt was not firing. (yes we will come back to the lowest level watchdog later) GPT has wrote me a nice allocator for timers and groups, and im in the process of proof reading it and tweaking it to my liking.
    [HVPSController.cpp, Outputs.cpp, Outputs.hpp]
2026-01-21 Going great, designing an improved primary current feedback system and started work on the second version
    of the HVPSController with a huge list of improvements i have gradually put together.
    [BasicCalculations.xlsx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]
2026-01-21 Volt seconds calculation for current transformer.
    [BasicCalculations.xlsx]
2026-01-22 Voltage regulators designed!
    [BasicCalculations.xlsx, HVPSController2.kicad_sch]
2026-01-23 Verified safe fpga pins for io all on 3.3v bus. Maths for H-Bridge going nicely :)
    I let gpt produce a list from reading the data sheet and then manually verified all pins im using are safe.
    [BasicCalculations.xlsx, HVPSController2.kicad_sch, safe_pins_for_io_EP4CE6E22C8N.csv]
2026-01-24 Gate driver for H-Bridge design finished
    [BasicCalculations.xlsx, HVPSController2.kicad_sch]
2026-01-30 Not far from done with parts list for v2 of HVPSController
    [BasicCalculations.xlsx, HVPSController2.kicad_sch, Parts.xlsx, Parts_HVPSController.xlsx, Parts_HVPSController2.xlsx, TransformerAirGapSpacers.3mf, TransformerAirGapSpacers.skp, TransformerAirGapSpacers.stl]
2026-02-02 Started on the verilog and fpga :)
    [HVPSController2.kicad_sch, Parts_HVPSController2.xlsx, pin_assignments.csv, pin_assignments_from_quartus.csv, safe_pins_for_io_EP4CE6E22C8N.csv]
2026-02-02 Pin number as frequency working all pins displaying their number as frequency
    [pin_assignments.csv]
2026-02-06 having a hard time pulling myself away from this. Must stop now.
    [BasicCalculations.xlsx, HVPSController.kicad_sch, HVPSController2.kicad_pcb, HVPSController2.kicad_sch, Parts_HVPSController2.xlsx]
2026-02-08 PCB coming together :)
    [BasicCalculations.xlsx, HVPSController2.kicad_pcb, HVPSController2.kicad_sch, Parts_HVPSController2.xlsx]
2026-02-10 Going great.
    [BasicCalculations.xlsx, HVPSController2.kicad_pcb, HVPSController2.kicad_sch]
2026-02-13 Put in place emulation of the ESP32 FPGA interface in C#.
    [BasicCalculations.xlsx, HVPSController2.kicad_pcb, HVPSController2.kicad_sch]
2026-02-19 Board almost done got some more checks to do first been cleaning up nicely.
    [HVPSController2.kicad_pcb, HVPSController2.kicad_sch, pin_assignments_from_quartus_2.csv, pin_assignments_from_quartus_3.csv]
2026-02-26 Going great think im ready to order the pcb!
    [HVPSController-B_Cu.gbr, HVPSController-B_Mask.gbr, HVPSController-B_Silkscreen.gbr, HVPSController-Edge_Cuts.gbr, HVPSController-F_Cu.gbr, HVPSController-F_Mask.gbr, HVPSController-F_Silkscreen.gbr, HVPSController-NPTH.drl]
2026-03-23 Working on the automatic generation of the fpga interface for microcontroller to speak to fpga. C++ microcontroller side almost done :)
    [BasicCalculations.xlsx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]
2026-03-23 I wrote the C++ side of the generator. Went through it and diagrams and stuff with GPT then he wrote the verilog side and it looks pretty good
    may be issues with either side but very close anyway :)
    [HVPS_FPGAInterface.v]
2026-03-26 Soft start is now switched to PowerConditioningMonitor and it successfully opens relay on voltage drop. Need to add event it dispatches.
2026-03-29 reading from fpga to esp correctly :)
    [pin_assignments.csv, pin_assignments_from_quartus.csv, pin_assignments_from_quartus_2.csv, pin_assignments_from_quartus_3.csv, pin_assignments_from_quartus_4.csv, pin_assignments_from_quartus_5.csv, safe_pins_for_io_EP4CE6E22C8N.csv]
2026-04-04 FPGA interface now sorted and works perfectly
    after a slight issue with clock signals that were bouncing slightly.
    [AD7822.v, BangBangController.v, ClockDomainCrossing.v, HBridge.v, HVPS_FPGAInterface.v]
2026-04-09 Going great. Sorted out ThresholdController and constant .sv file generation.
    [BasicCalculations.xlsx]
2026-04-15 Going great!
    [BasicCalculations.xlsx]
